andrastantos/the_d_machine/modules/sense_amp/notes.md

Temp      DC offset      Output at 20mV input    Output at 40mV input    Gain
=====     ============   ====================    ====================    ====== 
-25:       5.8V               8.60                        11.0             140/130
125:       5.88V              8.34                        10.6             123/118

There's a 13% change in gain and about 1% change in DC offset. However they counteract each other, and the overall effect is only 3-4% change of threshold value. That's acceptable.
