andrastantos/the_d_machine/docs/tape_recorders/MT8X_PCB1.pdf

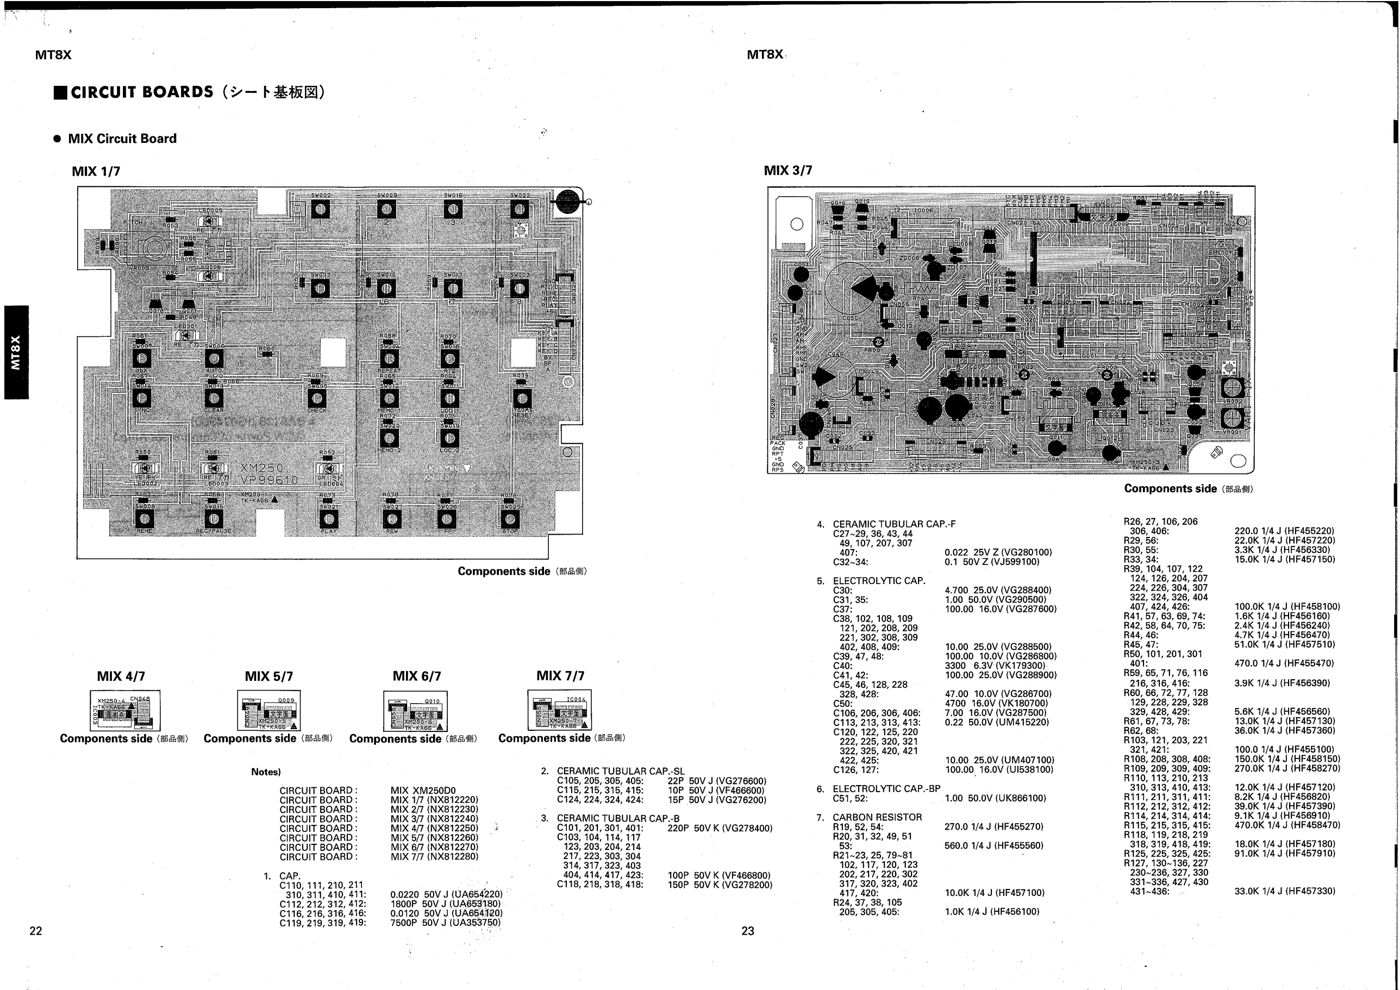
[picture p17: page 1]
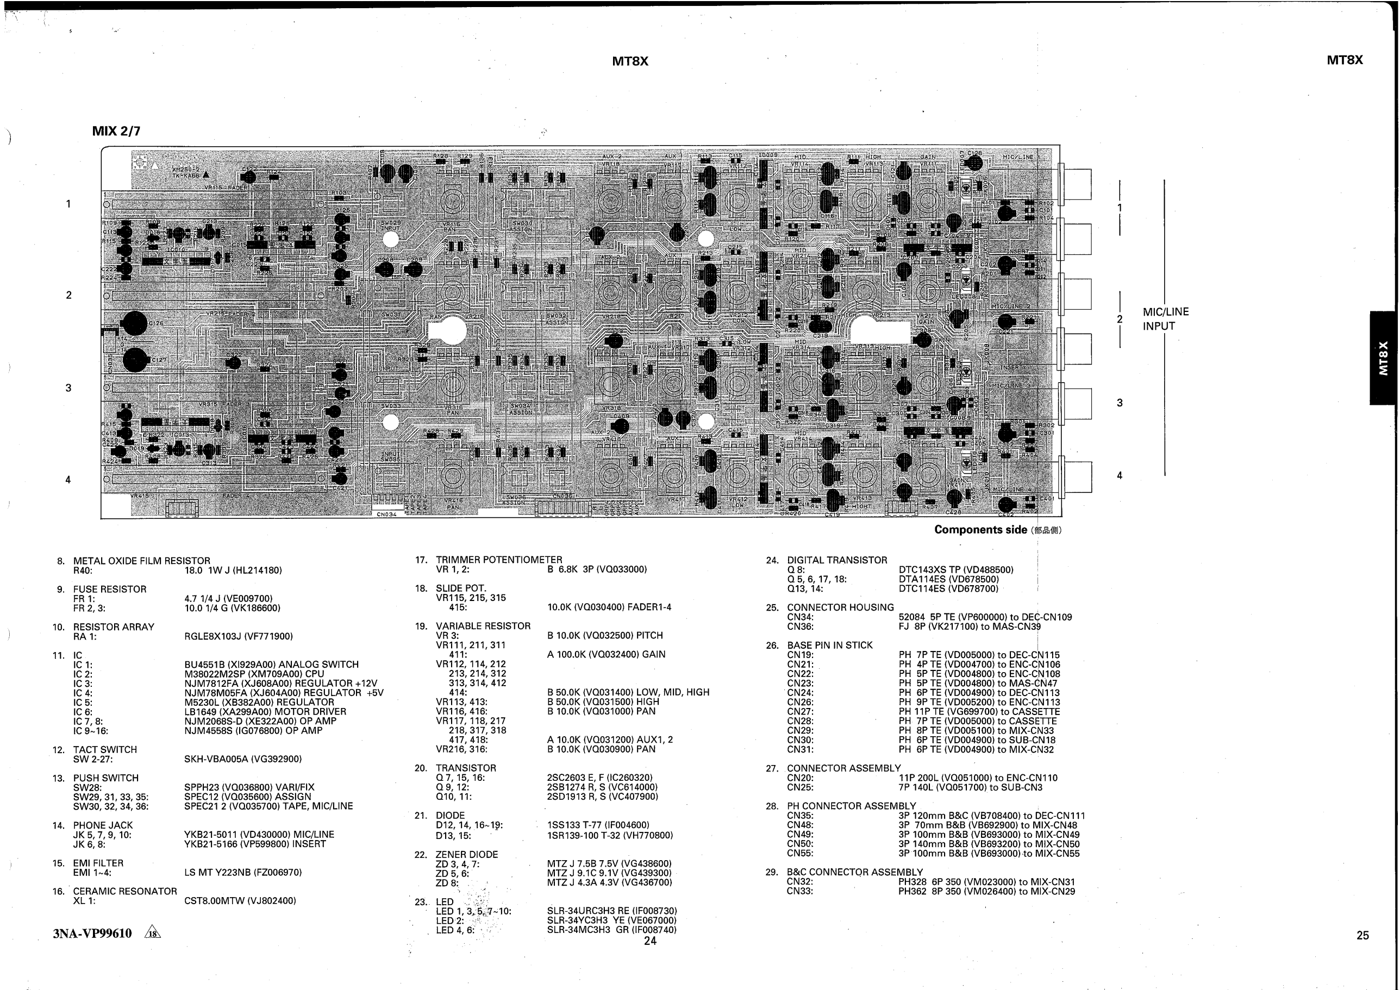
[picture p18: page 2]
