andrastantos/the_d_machine/docs/tape_recorders/MT8X_PCB2.pdf

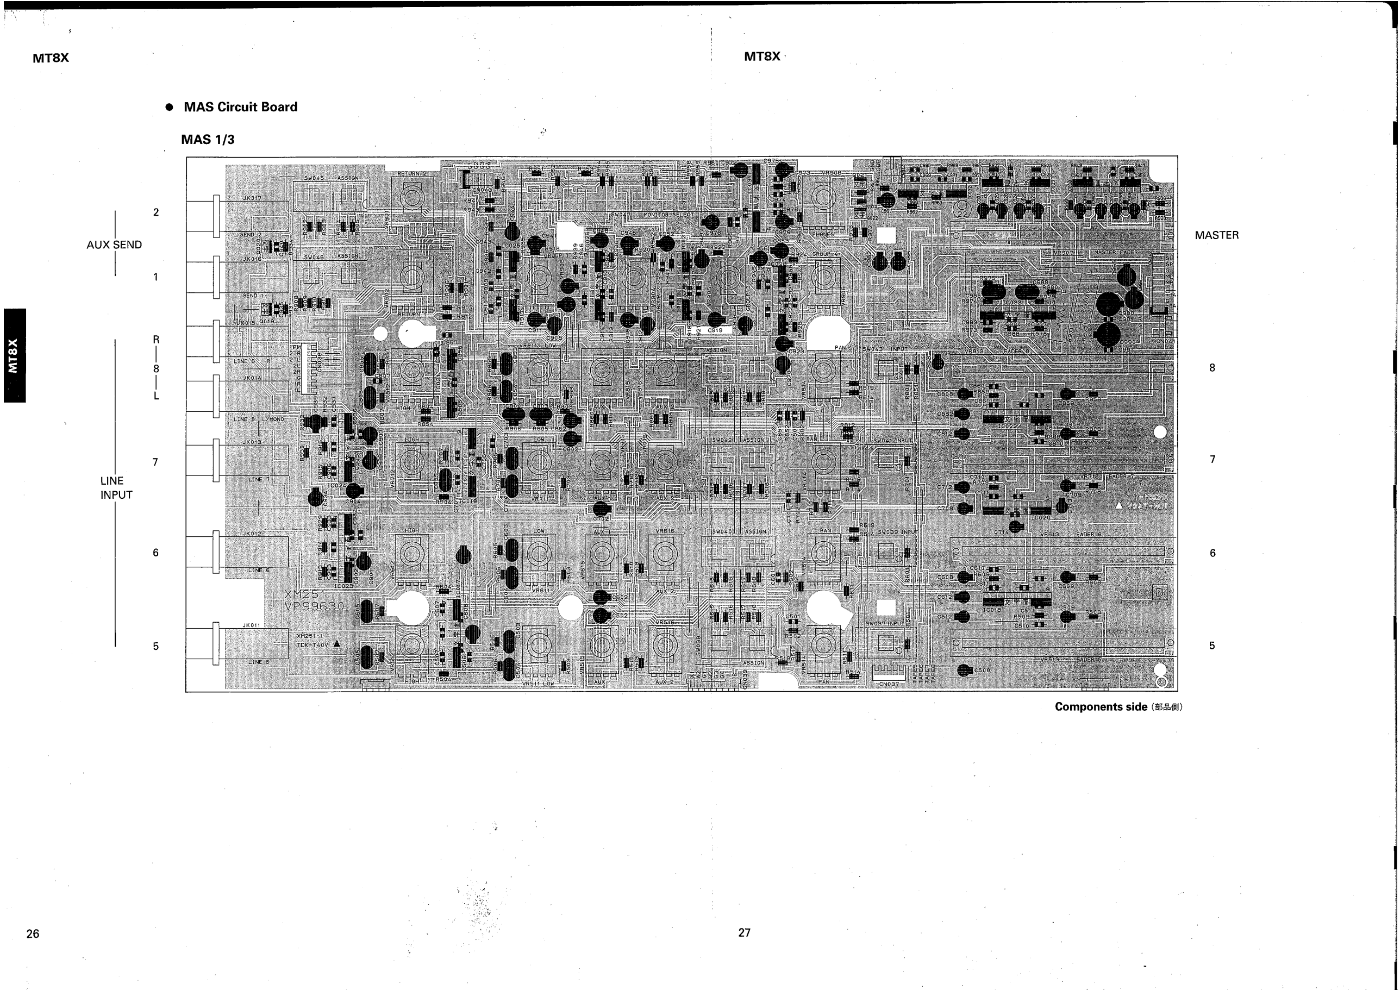
[picture p19: page 1]
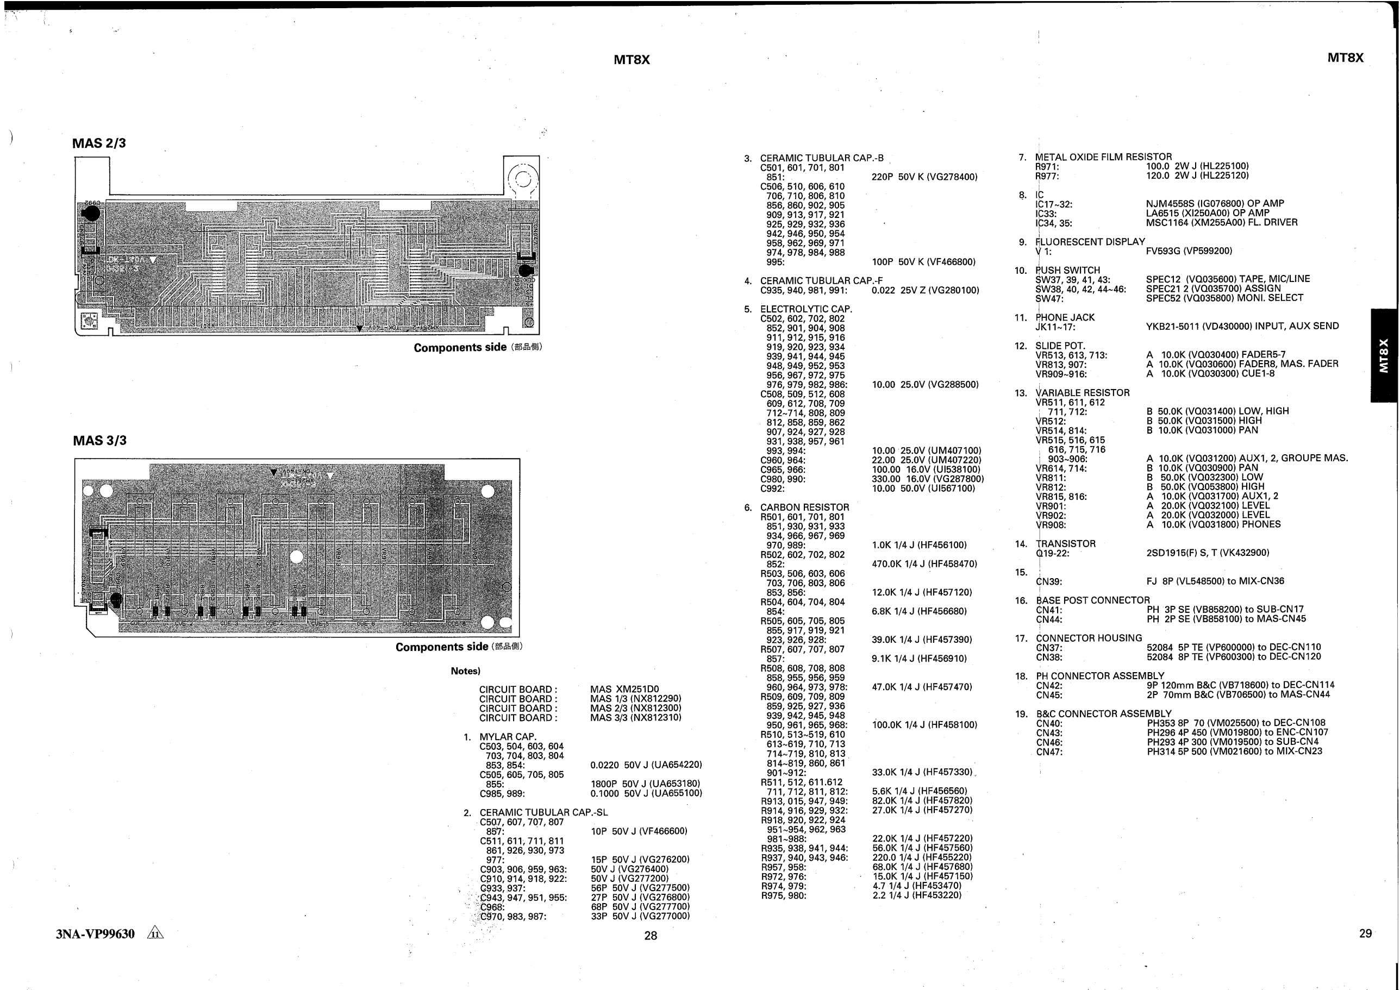
[picture p20: page 2]
