andrastantos/the_d_machine/docs/tape_recorders/MT8X_PCB3.pdf

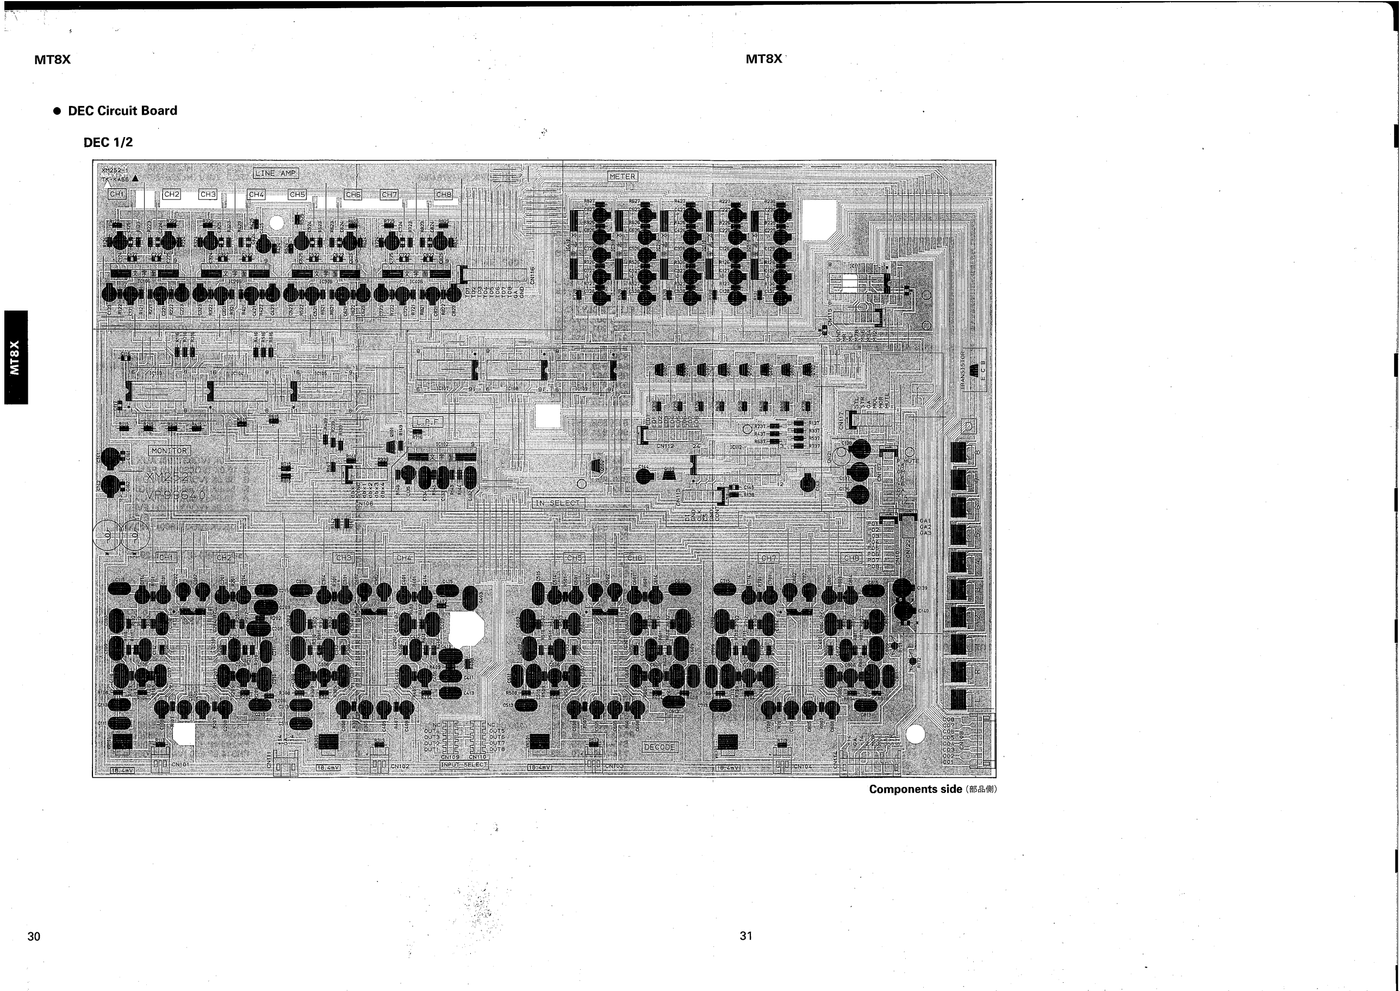
[picture p21: page 1]
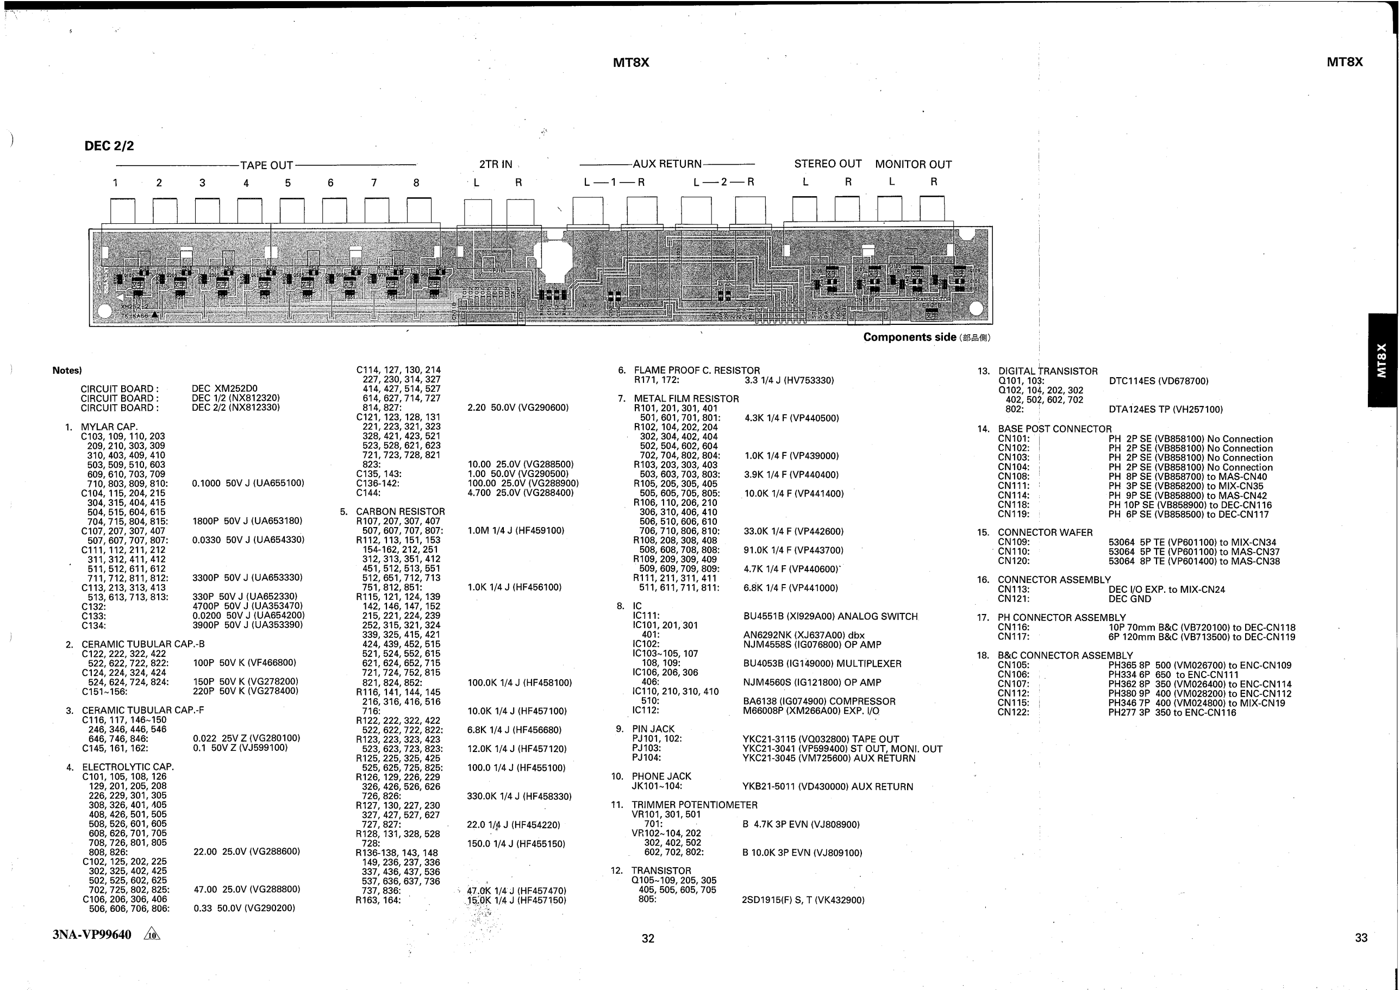
[picture p22: page 2]
