andrastantos/the_d_machine/docs/alu/delay_at_125c.png

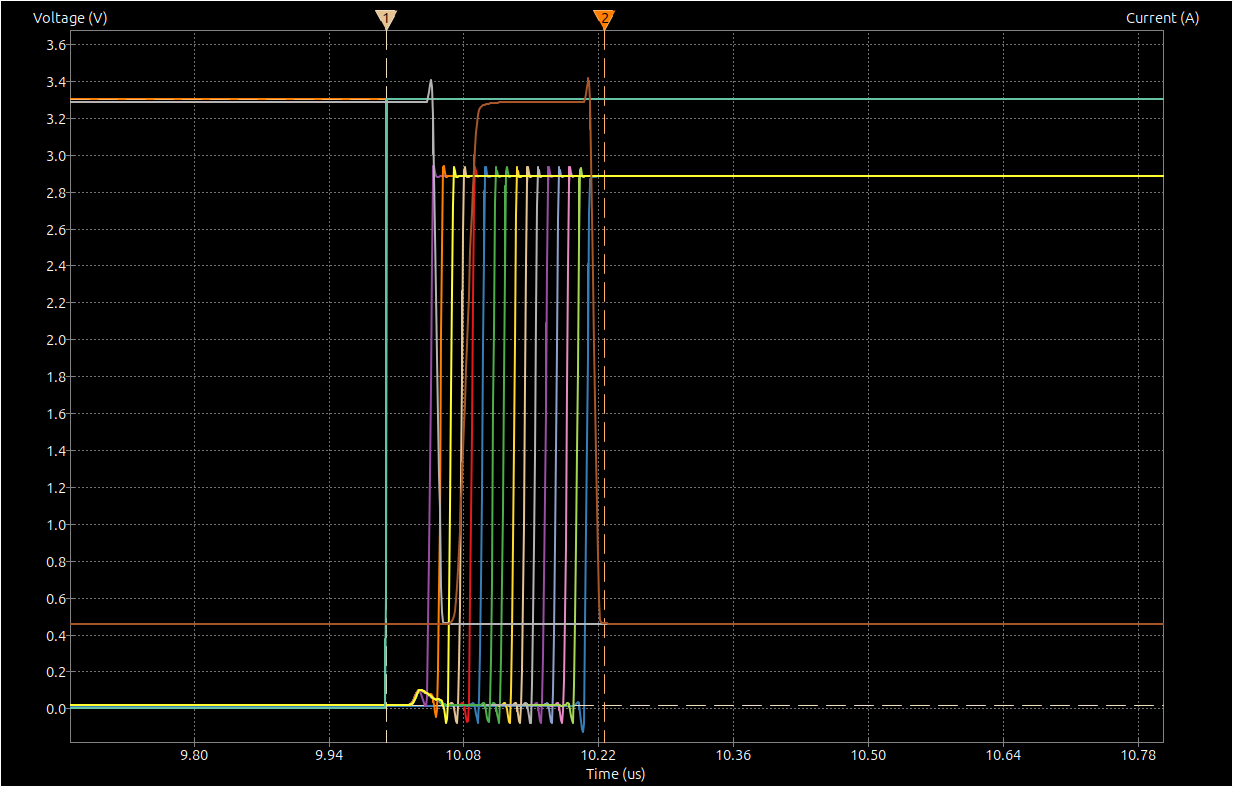
docs/alu/delay_at_125c.png
