andrastantos/the_d_machine/docs/alu/delay_at_neg25c.png

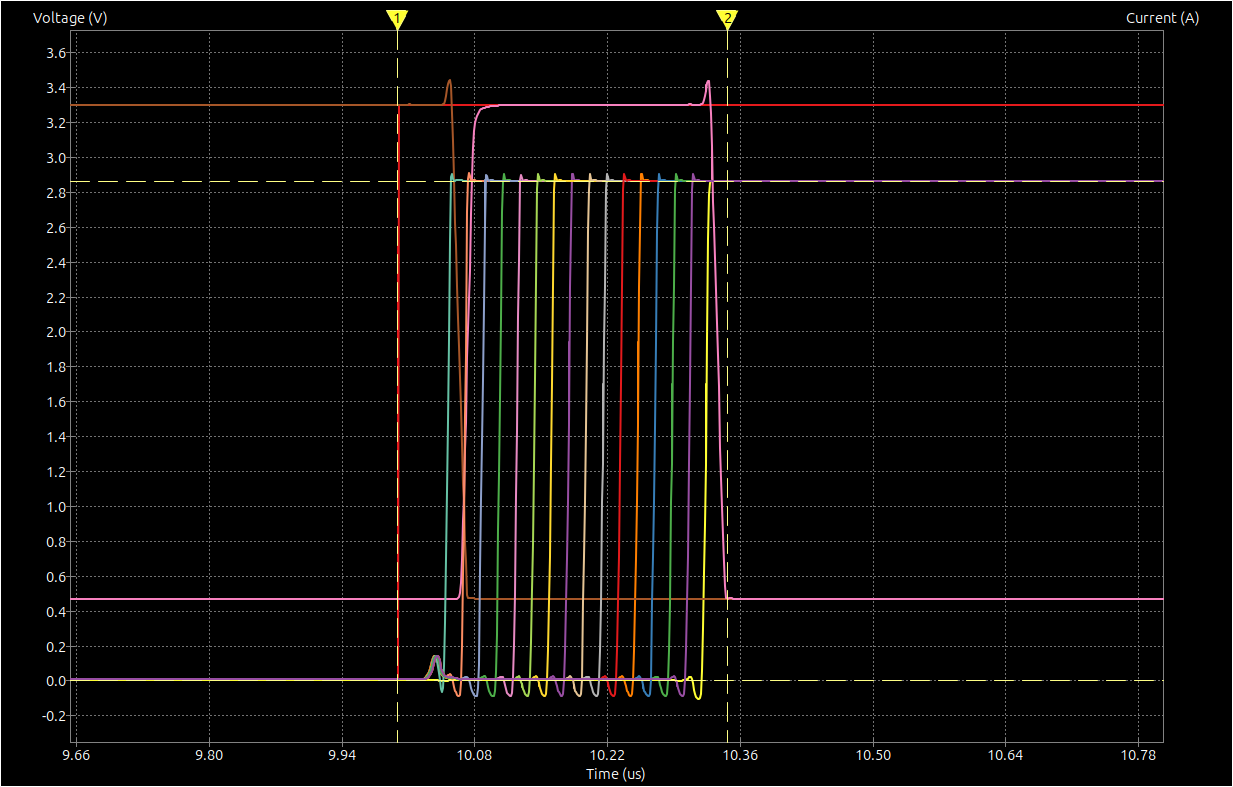
docs/alu/delay_at_neg25c.png
