andrastantos/the_d_machine/docs/tape_recorders/MT8X_sch1.tif

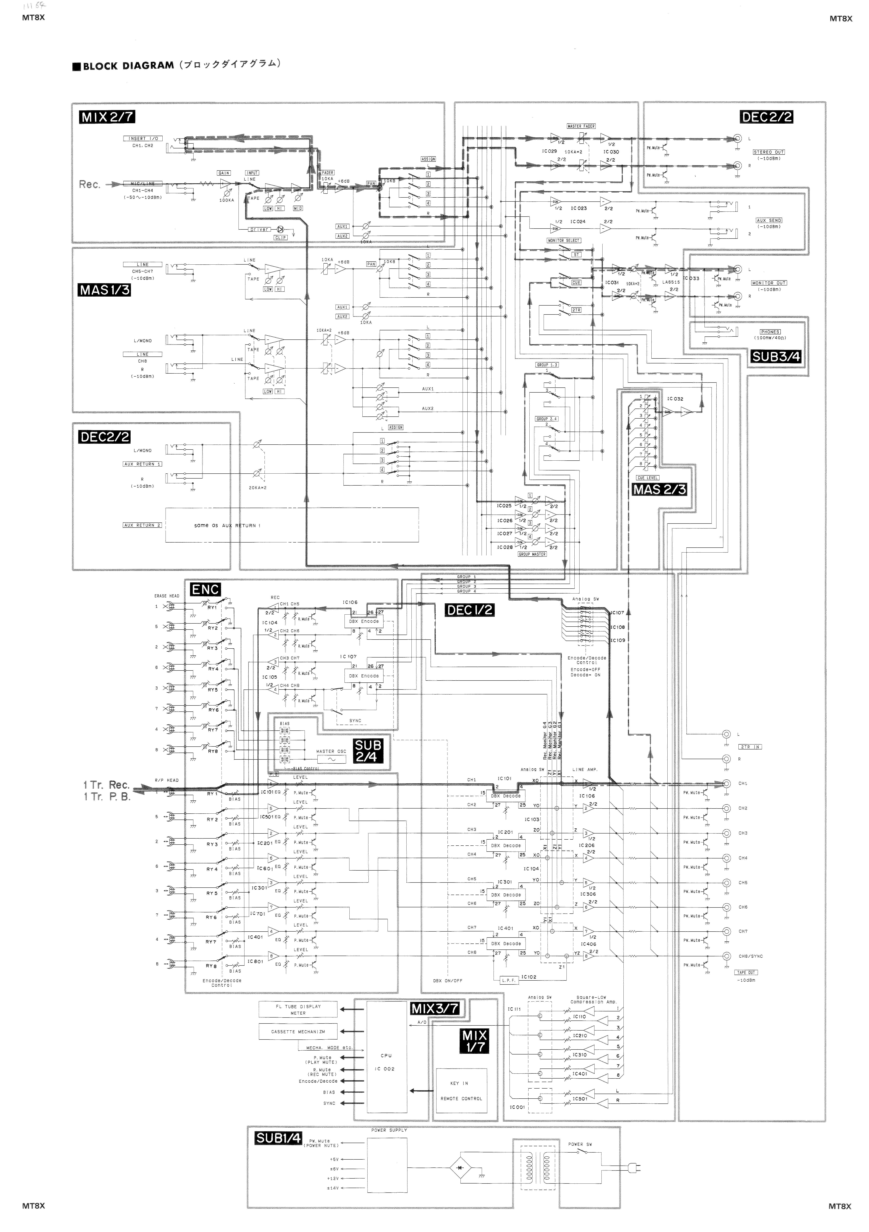
docs/tape_recorders/MT8X_sch1.tif
