andrastantos/the_d_machine/docs/tape_recorders/MT8X_sch4.tif

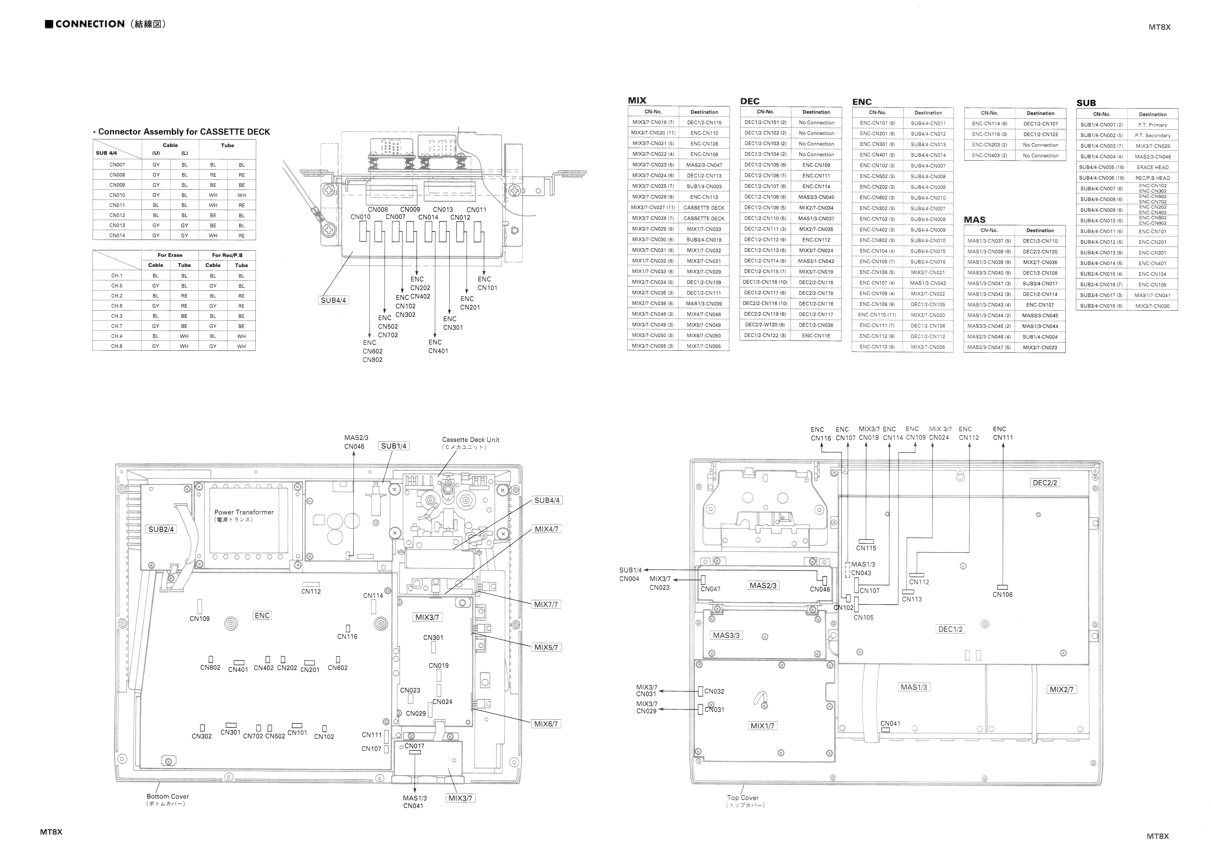
docs/tape_recorders/MT8X_sch4.tif
