andrastantos/the_d_machine/circuit_sims/power/forward_regulator_test2.asc

C1: cap; 100µ
C2: cap; 100µ
D1: diode; MBRS340
D2: diode; MBRS340
D3: diode; MBRS340
D4: diode; MBRS340
D5: diode; MBRS340
D6: diode; MBRS340
L1: ind; {l1}; Rser=1m
L2: ind; {l1*n2*n2}; Rser=1m
L3: ind; {l1*n3*n3}; Rser=1m
L4: ind; {l1*n4*n4}; Rser=1m
L5: ind; 10µ
L6: ind; 10µ
R1: res; 17.6m
R2: res; 105.6m
R3: res; 426m
R4: res; 122m
R5: res; {18/0.1}
R6: res; {18/2}
S1: sw; LDSW
S3: sw; LDSW
V1: voltage; 20
V2: voltage; PULSE(0 1 0 1n 1n 1u 2u)
Named nets: 0, out_p, out_n, sw
;K L1 L2 L3 L4 0.9988
PA3856.006NL
.model LDSW SW(Ron=1m Roff=1Meg Vt=.5 Vh=-.4)
.tran 0 10m 0 5n uic
K L1 L2 L3 L4 1
.param n1=1 n2=1.74 n3=2.12 n4=2.12 l1=128u
Maximum duty cycle is 50%, at least in theory.
Still, this setup can produce 20V output even under heavy loads from a 20V input.
Saturation current: Bpk/K1_factor. Bbk is 2700Gauss and K1_factor is 41.7
K2 L5 L6 L7 1
