andrastantos/the_d_machine/circuit_sims/power/forward_regulator_test1.asc

C1: cap; 100µ
C2: cap; 100µ
C3: cap; 100µ
C4: cap; 100µ
D1: diode; MBRS340
D2: diode; MBRS340
D3: diode; MBRS340
D4: diode; MBRS340
D5: diode; MBRS340
D6: diode; MBRS340
D7: diode; MBRS340
D8: diode; MBRS340
D9: diode; MBRS340
D10: diode; MBRS340
D11: diode; MBRS340
D12: diode; MBRS340
L1: ind; {l1}; Rser=1m
L2: ind; {l1*n2*n2}; Rser=1m
L3: ind; {l1*n3*n3}; Rser=1m
L4: ind; {l1*n4*n4}; Rser=1m
L5: ind; 10µ
L6: ind; 10µ
L7: ind; {l7}; Rser=1m
L8: ind; {l7*n8*n8}; Rser=1m
L9: ind; {l7*n9*n9}; Rser=1m
L10: ind; {l7*n10*n10}; Rser=1m
L11: ind; 10µ
L12: ind; 10µ
R1: res; 17.6m
R2: res; 105.6m
R3: res; 426m
R4: res; 122m
R5: res; {18/1.5}
R6: res; {18/1.5}
R7: res; 60m
R8: res; 90m
R9: res; 75m
R10: res; 90m
R11: res; {18/1.5}
R12: res; {18/1.5}
S1: sw; LDSW
S2: sw; LDSW
V1: voltage; 30
V2: voltage; PULSE(0 1 0 1n 1n 1u 2.75u)
V3: voltage; 30
V4: voltage; PULSE(0 1 0 1n 1n 2.5u 5u)
Named nets: 0
;K L1 L2 L3 L4 0.9988
PA3856.006NL
.model LDSW SW(Ron=1m Roff=1Meg Vt=.5 Vh=-.4)
.tran 0 10m 0 5n uic
K L1 L2 L3 L4 1
.param n1=1 n2=1.74 n3=2.12 n4=2.12 l1=128u
Maximum duty cycle is the turns ration (n1:(n1+n2)) to allow the primary
current to return to zero
;K L1 L2 L3 L4 0.9988
PA3856.007NL
.model LDSW SW(Ron=1m Roff=1Meg Vt=.5 Vh=-.4)
.tran 0 10m 0 5n uic
K2 L7 L8 L9 L10 1
.param n7=1 n8=1 n9=1.1 n10=1.1 l7=200u
Saturation current: Bpk/K1_factor. Bbk is 2700Gauss and K1_factor is 41.7 (33.3 for L7)
The 007NL transformer (just barely) can work with a 20V input voltage.
The 006NL transformer needs close to 30V input to function.
 
Since the 007NL is a unicorn as far as the distributors are concerned
(only Mouser seem to have it), I'll work with the 006NL and increase
the input voltage to 30V.
 
This decision doesn't seem to impact the netlist, just (a bunch of)
component values.
It seems that light loads actually result in really high input currents.
I don't quite understand that.
