andrastantos/the_d_machine/circuit_sims/power/step_down2.asc

C2: cap; {Cosc}
C5: cap; {Cosc}
D3: diode; BZX84C6V2L
Q6: npn; 2N3904
Q8: npn; 2N3904
Q9: pnp; 2N3906
Q10: pnp; 2N3906
Q17: pnp; 2N3906
Q18: pnp; 2N3906
Q19: npn; 2N3904
Q20: pnp; 2N3906
Q21: npn; 2N3904
Q22: npn; 2N3904
R1: res; 1m
R19: res; {1.1/3.5m}
R20: res; 1k
R21: res; 10k
R22: res; 2.5k
R23: res; 1m
R24: res; 1m
R27: res; 1m
R28: res; 4.7k
R29: res; 2.5k
R30: res; {Rosc}
R31: res; {Rosc}
R32: res; 1m
V2: voltage; 2.1
V4: voltage; 20
Named nets: 0, IN, VREF, ca, cb, ba, bb
.tran 0.5m startup
.param Rc=270
.param Rb=1m
.param Rosc=680
;.step param Rosc 3k 10k 500
.param Cosc=470p
;.step param Cosc 1n 10n 1n
;.step temp list -25 25 125
.temp 125
.dc V2 0 20 0.05
1.1V
1.1V
\\/ 5mA
2.1V
