andrastantos/the_d_machine/circuit_sims/power/step_down_trial2_2.asc

C1: cap; 100µ
C3: cap; 4.7n
C4: cap; 10µ
D1: diode; BZX84C6V2L
D2: diode; MBRS340
D3: diode; BAT54
L1: ind; 470µ
M1: pmos; Si4835DY
M5: nmos; 2N7002
M6: nmos; 2N7002
M7: nmos; 2N7002
M8: pmos; BSS84
Q1: pnp; 2N3906
Q4: npn; 2N3904
Q5: npn; 2N3904
Q6: npn; 2N3904
Q7: pnp; 2N3906
Q8: pnp; 2N3906
Q9: npn; 2N3904
Q10: npn; 2N3904
Q11: npn; 2N3904
Q12: pnp; 2N3906
Q13: pnp; 2N3906
Q14: npn; 2N3904
R2: res; 1m
R3: res; 4
R4: res; 1k
R5: res; 1k
R6: res; 1k
R7: res; {1.1/4m}
R8: res; 1k
R9: res; 10k
R10: res; 2.5k
R11: res; {1.1/15m}
R12: res; 1m
R13: res; 4.7k
R14: res; 2.5k
R15: res; 1k
R16: res; 1
R17: res; 8k
R18: res; 8k
R19: res; 10k
R20: res; 10k
R21: res; 1k
R22: res; 1k
R23: res; 10k
R24: res; 10k
R25: res; 10k
R26: res; 10k
R27: res; 1m
R28: res; 220
R29: res; 520
R_ileft1: res; 1m
R_ileft2: res; 1m
R_imaster1: res; 1m
R_imaster2: res; 1m
R_iright1: res; 1m
R_iright2: res; 1m
V2: voltage; 20
Vfb: voltage; 0.9
Named nets: triangle, 0, VREF, FB, st1, st2, out, sw
.tran 10m startup
1.1V
1.1V
\\/ 5mA
2.1V
slow-start capacitor
.dc Vfb 0 20 0.05
1.1V
\\/ 5mA
;.step temp list -25 25 125
.temp -25
