andrastantos/the_d_machine/circuit_sims/power/step_down3.asc

C1: cap; 2.2n
C2: cap; 1p
C3: cap; 33µ
C4: cap; 1µ
D1: diode; BAT54
D2: diode; BAT54
D3: diode; BZX84C6V2L
D4: diode; 1N5818
D5: diode; BAT54
L1: ind; 33µ; Rser=1m
M1: nmos; 2N7002
M2: nmos; 2N7002
M3: nmos; 2N7002
M4: pmos; BSS84
M5: nmos; 2N7002
M6: pmos; BSS84
M7: nmos; 2N7002
M8: pmos; BSS84
Q1: pnp; 2N3906
Q2: pnp; 2N3906
Q3: npn; 2N3904
Q4: pnp; 2N3906
Q5: npn; 2N3904
Q6: npn; 2N3904
Q7: pnp; 2N3906
Q8: npn; 2N3904
Q9: npn; 2N3904
Q10: pnp; 2N3906
Q11: pnp; 2N3906
Q12: pnp; 2N3906
Q13: pnp; 2N3906
Q14: pnp; 2N3906
Q19: npn; 2N3904
Q20: pnp; 2N3906
R1: res; 1
R2: res; 10k
R3: res; 10k
R4: res; 220
R5: res; 1Mega
R6: res; 1m
R7: res; 1m
R8: res; 1m
R9: res; 0.1
R10: res; 10k
R11: res; 10k
R12: res; 10k
R13: res; 25
R14: res; 20k
R15: res; 1Mega
R16: res; 1k
R17: res; 10k
R18: res; 1k
R19: res; {1.1/5m}
R20: res; 1k
R21: res; 10k
R22: res; 2.5k
R23: res; 1m
R24: res; 1m
R25: res; 10k
R28: res; 4.7k
R29: res; 2.5k
R32: res; 1m
R_ileft: res; 1m
R_imaster: res; 1m
R_iright: res; 1m
V4: voltage; 20
Named nets: 0, VREF, FB, triangle, drive, sw, st1, st2, vout, vcc
.tran 0 5m 0 startup
.param Rc=270
.param Rb=1m
;.step param Rosc 3k 10k 500
;.step param Cosc 1n 10n 1n
;.step temp list -25 25 125
.temp 125
.dc V2 0 20 0.05
1.1V
1.1V
\\/ 5mA
2.1V
;.step param Vset 2.12 2.18 0.01
.param Vset=2.2
slow-start capacitor
over-current protection;
crucial for proper startup
Q14/Q12/Q9/Q10: over-voltage protection, but doesn't work too well.
while it does prevent the output from turning on,
the pumpued inductor current still needs to reach 0, which can
drive the output voltage way too high.
M8 is an attempt at soft-start. It only delays the start, unfortunately.
