andrastantos/the_d_machine/circuit_sims/power/step_down1.asc

C1: cap; 100µ
C3: cap; {Cosc}
C4: cap; {Cosc}
D1: diode; BZX84C6V2L
D2: diode; MBRS1100
L1: ind; 470µ; Rser=1m
Q1: npn; 2N3904
Q2: pnp; 2N2907
Q3: npn; 2N3904
Q4: npn; 2N3904
Q5: npn; 2N3904
Q7: pnp
Q11: npn; 2N3904
Q12: npn; 2N3904
Q13: pnp; 2N3906
Q14: pnp; 2N3906
Q15: pnp; 2N3906
Q16: pnp; 2N3906
R1: res; 1k
R2: res; 20k
R3: res; {Rosc}
R4: res; {Rosc}
R5: res; 5k
R6: res; {Rb}
R7: res; {Rb}
R8: res; {Rc}
R9: res; {Rosc}
R10: res; 2k
R11: res; 10
R12: res; 10k
R13: res; 19k
R14: res; 1m
R15: res; 1m
R16: res; {Rosc}
R17: res; 1m
R18: res; 2.7k
V1: voltage; 20
V2: voltage; 5
V3: voltage; PULSE(1 0 1m 100n 100n 10 100)
Named nets: 0, OUT, SW, FB, IN, VREF, ca, cb, ba, bb
.tran 5m startup
.param Rc=270
.param Rb=1
.param Rosc=810
;.step param Rosc 3k 10k 500
.param Cosc=470p
;.step param Cosc 1n 10n 1n
.step temp list -25 25 125
.temp 125
