andrastantos/the_d_machine/circuit_sims/sense_amp/rom_sense_amp_with_optics2.asc

C1: cap; 1n
D1: schottky; BAT54
D2: schottky; BAT54
D3: diode; BZX84C8V2L
I1: current; PULSE(0.8m 1.2m 450n 1n 1n 989n 1980n)
I2: current; 1m
Q1: npn; 2N3904
Q2: npn; 2N3904
Q3: npn; 2N3904
Q4: npn; 2N3904
Q10: npn; 2N3904
Q11: npn; 2N3904
Q19: npn; 2N3904
Q20: npn; 2N3904
Q21: npn; 2N3904
Q26: npn; 2N3904
Q27: npn; 2N3904
Q29: npn; 2N3904
Q30: npn; 2N3904
Q31: pnp; 2N3906
Q32: pnp; 2N3906
R1: res; 1k
R4: res; 1k
R5: res; 1k
R8: res; 1k
R9: res; 0.01m
R10: res; 10k
R11: res; 1k
R12: res; 0.01m
R13: res; 10k
R20: res; 56
R22: res; 56
R24: res; 600
R25: res; 6.8k
R26: res; 6.8k
R27: res; 300
R28: res; 2k
R29: res; 1k
R30: res; 1k
R34: res; 1k
R35: res; 1k
R36: res; 1.7k
R37: res; 300
R38: res; 300
R39: res; 100
R42: res; 100
U3: 4N25
U4: 4N25
V_EN: voltage; PULSE(-4 12 0 1n 1n 299n 500n)
VN: voltage; 12
VP1: voltage; 3.3
VP: voltage; 12
Named nets: 0, V+, V-, IN+, IN-, VCC, EN, SENSE_OUT2-, S_IN-, V_REF, SENSE_OUT2+, O-, O+, E_IN+, E_IN-, S_IN+
.tran 20u
.dc VINA -100m 100m 0.1m
;.step temp -25 125 25
PULSE(-4 12 0 1n 1n 299n 500n)
PWL file=ampl_train.pwl
VREF control
;.step param in_ampl 1000u 10000u 500u
;.temp 125
This is not a good design: it's common-base input stage does nothing for
noise coupling, but of course makes the system more complicated.
