andrastantos/the_d_machine/circuit_sims/sense_amp/rom_sense_amp_with_optics.asc

C1: cap; 100p
C2: cap; 100p
C3: cap; 100p
C4: cap; 10p
C5: cap; 10p
C6: cap; 100p
C7: cap; 10p
D1: schottky; BAT54
D2: schottky; BAT54
D3: diode; BZX84C8V2L
D4: diode; BZX84C8V2L
D5: diode; BZX84C8V2L
D6: diode; BZX84C8V2L
I1: current; PULSE(0.8m 1.2m 450n 1n 1n 249n 500n)
I2: current; 1m
I3: current; 10m
Q1: npn; 2N3904
Q2: npn; 2N3904
Q3: pnp; 2N3906
Q4: npn; 2N3904
Q5: pnp; 2N3906
Q6: npn; 2N3904
Q7: npn; 2N3904
Q8: pnp; 2N3906
Q9: pnp; 2N3906
Q10: npn; 2N3904
Q11: npn; 2N3904
Q12: pnp; 2N3906
Q13: pnp; 2N3906
Q14: pnp; 2N3906
Q15: pnp; 2N3906
Q16: npn; 2N3904
Q19: npn; 2N3904
Q20: npn; 2N3904
Q21: npn; 2N3904
Q26: npn; 2N3904
Q27: npn; 2N3904
Q29: npn; 2N3904
Q30: npn; 2N3904
Q31: pnp; 2N3906
Q32: pnp; 2N3906
R1: res; 1k
R2: res; 1k
R3: res; 1k
R4: res; 1k
R5: res; 1k
R6: res; 1k
R7: res; 1k
R8: res; 1k
R9: res; 1k
R10: res; 100
R11: res; 1k
R12: res; 0.01m
R13: res; 0.01m
R14: res; 500
R15: res; 1k
R16: res; 500
R17: res; 1k
R18: res; 1k
R19: res; 1k
R20: res; 56
R21: res; 0.01m
R22: res; 56
R23: res; 1k
R24: res; 600
R25: res; 6.8k
R26: res; 6.8k
R27: res; 300
R28: res; 2k
R29: res; 1k
R30: res; 1k
R31: res; 1k
R32: res; 1k
R34: res; 1k
R35: res; 1k
R36: res; 1.7k
R37: res; 300
R38: res; 300
R39: res; 100
R42: res; 100
U1: 4N25
U2: 4N25
U3: 4N25
U4: 4N25
U5: 4N25
V1: voltage; 8.2
V_EN: voltage; PULSE(-4 12 0 1n 1n 299n 500n)
VN: voltage; 12
VP1: voltage; 3.3
VP: voltage; 12
Named nets: 0, V+, V-, IN+, IN-, VCC, EN, SENSE_OUT2-, S_IN+, S_IN-, V_REF, SENSE_OUT2+, O-, O+, E_IN+, E_IN-, oooo2, a, b, bias, oooo1, a1, b1, ooo3, oooo3, a2, b2, ooo4
.tran 20u
.dc VINA -100m 100m 0.1m
.step temp -25 125 25
PULSE(-4 12 0 1n 1n 299n 500n)
PWL file=ampl_train.pwl
VREF control
;.step param in_ampl 1000u 10000u 500u
;.temp 125
Common-base current buffer.
Unfortunately, it needs a relatively high input bias current (50uA or so) to work.
In fact, to get low input impedance (~200ohms), one needs 10mA bias current, but
that crushes output current amplitude.
I think this is the common-base input stage that I want
