andrastantos/the_d_machine/circuit_sims/bjt/optical_components.asc

C1: cap; 100p
C2: cap; 100p
C3: cap; 100p
C4: cap; 100p
C5: cap; 100p
C6: cap; 100p
C7: cap; 100p
C8: cap; 100p
D1: diode; L1C1-AMB1000000000
D2: schottky; BAT54
D3: schottky; BAT54
D4: schottky; BAT54
D5: schottky; BAT54
D6: schottky; BAT54
D7: diode; 1N914
D8: diode; L1C1-AMB1000000000
D9: schottky; BAT54
D10: schottky; BAT54
D11: schottky; BAT54
D12: schottky; BAT54
D13: schottky; BAT54
D14: schottky; BAT54
D15: schottky; BAT54
D16: diode; L1C1-AMB1000000000
D17: diode; L1C1-AMB1000000000
D18: diode; L1C1-AMB1000000000
D19: schottky; BAT54
D20: schottky; BAT54
D21: schottky; BAT54
D22: schottky; BAT54
D23: schottky; BAT54
D24: schottky; BAT54
D25: schottky; BAT54
D26: diode; L1C1-AMB1000000000
D27: diode; L1C1-AMB1000000000
D28: diode; L1C1-AMB1000000000
D29: diode; L1C1-AMB1000000000
D30: diode; L1C1-AMB1000000000
I1: current; PULSE(0 10mA 0 1n 1n 99n 200n)
I2: current; PULSE(0 0.06mA 0 1n 1n 99n 200n)
Q1: npn; 2N3904
Q2: npn; 2N3904
Q3: npn; 2N3904
Q4: npn; 2N3904
Q5: npn; 2N3904
Q6: npn; 2N3904
Q7: npn; 2N3904
Q8: npn; 2N3904
Q9: npn; 2N3904
Q10: npn; 2N3904
Q11: pnp; 2N2907
Q12: npn; 2N3904
Q13: npn; 2N3904
Q14: npn; 2N3904
Q15: npn; 2N3904
Q16: npn; 2N3904
Q17: npn; 2N3904
Q18: pnp; 2N3906
Q19: pnp; 2N3906
Q20: npn; 2N3904
Q21: npn; 2N3904
Q22: pnp; 2N3906
Q23: pnp; 2N3906
Q24: npn; 2N3904
Q25: npn; 2N3904
Q26: pnp; 2N3906
Q27: pnp; 2N3906
Q28: npn; 2N3904
Q29: npn; 2N3904
Q30: pnp; 2N3906
Q31: pnp; 2N3906
Q32: npn; 2N3904
Q33: npn; 2N3904
Q34: pnp; 2N3906
Q35: pnp; 2N3906
Q36: npn; 2N3904
Q37: npn; 2N3904
Q38: pnp; 2N3906
Q39: pnp; 2N3906
R1: res; 1k
R2: res; 100
R3: res; 220
R4: res; 220
R5: res; 220
R6: res; 220
R7: res; 220
R8: res; 220
R9: res; 100
R10: res; 1k
R11: res; 220
R12: res; 220
R13: res; 220
R14: res; 220
R15: res; 100
R16: res; 1k
R17: res; 100
R18: res; 15
R19: res; 10k
R20: res; 220
R21: res; 220
R22: res; 100
R23: res; 220
R24: res; 220
R25: res; 100
R26: res; 220
R27: res; 220
R28: res; 15
R29: res; 220
R30: res; 220
R31: res; 15
R32: res; 220
R33: res; 220
R34: res; 15
R35: res; 220
R36: res; 220
R37: res; 1k
R38: res; 1k
R39: res; 1k
R40: res; 1k
R41: res; 75
R42: res; 220
R43: res; 220
R44: res; 75
R45: res; 1m
R46: res; 75
R47: res; 10
R48: res; 10
R49: res; 10
R50: res; 10
R51: res; 220
R52: res; 220
R53: res; 75
R54: res; 1m
R55: res; 10
R56: res; 10
R57: res; 10
R58: res; 10
R59: res; 75
R60: res; 220
R61: res; 220
R62: res; 75
R63: res; 1m
R64: res; 10
R65: res; 10
R66: res; 10
R67: res; 10
R68: res; 75
R69: res; 220
R70: res; 220
R71: res; 75
R72: res; 1m
R73: res; 10
R74: res; 10
R75: res; 10
R76: res; 10
R77: res; 1
R78: res; 1
R79: res; 1
R80: res; 1
R81: res; 66
R82: res; 100
R83: res; 100
U1: 4N25
U2: 4N25
U3: 4N25
U4: 4N25
V1: voltage; PULSE(0 {VCC} 0 {rise} {rise} {1/freq/2-rise} {1/freq})
V2: voltage; 15
V3: voltage; 5
V_BIT2: voltage; PULSE(0 {VCC} 0 {rise} {rise} {1/freq/2-rise} {1/freq}); AC 5
V_BIT3: voltage; PULSE(0 {VCC} 0 {rise} {rise} {2*1/freq/2-rise} {2*1/freq})
V_BIT4: voltage; PULSE(0 {VCC} 0 {rise} {rise} {4*1/freq/2-rise} {4*1/freq})
V_BIT5: voltage; PULSE(0 {VCC} 0 {rise} {rise} {8*1/freq/2-rise} {8*1/freq})
V_BIT6: voltage; PULSE(0 {VCC} 0 {rise} {rise} {16*1/freq/2-rise} {16*1/freq})
VCC1: voltage; {VCC}
Named nets: 0, VCC, BIT0, OUT, BIT1, BIT2, BIT3, BIT4, _bit0, _bit1, _BIT0, _BIT1, bit0, bit1
.tran {16*reps/freq}
.ac oct 100 1k 100mega
.dc V_BIT0 0 {VCC} 0.01
.param VCC=3.3
.param freq=1Mega
.param rise=1n
.param reps=1
.step param temp list -25 25 125
