andrastantos/the_d_machine/circuit_sims/bjt/current_h_bridge_test_bed.asc

C1: cap; 57p
C2: cap; 2.7n
C3: cap; 1n
C4: cap; 2.7n
C5: cap; 2.7n
C6: cap; 100p
C7: cap; 100p
C8: cap; 100p
C9: cap; 100p
C10: cap; 100p
C11: cap; 100p
D1: schottky; BAT54SHY
D2: zener; BZX84C6V2L
D3: schottky; BAT54SHY
D4: schottky; BAT54SHY
D5: diode; TDZV20
D6: schottky; BAT54SHY
D7: diode; 1N914
D8: diode; 1N914
D9: diode; 1N914
D10: diode; 1N914
D11: diode; BZX84C27VLY
D12: diode; BZX84C27VLY
D13: diode; 1N914
D14: schottky; BAT54
D15: schottky; BAT54
D16: schottky; BAT54
D17: schottky; BAT54
D18: schottky; BAT54
D19: diode; 1N914
D20: diode; 1N914
D21: schottky; BAT54
D22: diode; 1N914
D23: diode; 1N914
D24: schottky; BAT54
D25: schottky; BAT54
D26: schottky; BAT54
D27: schottky; BAT54
D28: schottky; BAT54
D29: schottky; BAT54
D30: schottky; BAT54
D31: schottky; BAT54
D32: schottky; BAT54
D33: schottky; BAT54
D34: diode; 1N914
D35: diode; 1N914
D36: diode; 1N914
D37: diode; 1N914
D38: diode; BZX84C27VLY
D39: diode; BZX84C27VLY
D40: schottky; BAT54
D41: schottky; BAT54
D43: schottky; BAT54
D44: schottky; BAT54
I5: current; 0.37
Q1: pnp; 2DB1182Q
Q2: pnp; 2DB1182Q
Q3: npn; 2N3904
Q4: pnp; 2DB1182Q
Q5: npn; 2N3904
Q6: npn; 2N3904
Q7: pnp; 2N3906
Q8: pnp; 2N3906
Q9: pnp; 2N3906
Q10: pnp; 2N3906
Q11: pnp; 2DB1182Q
Q12: pnp; 2N3906
Q13: npn; 2N3904
Q14: pnp; 2N3906
Q15: pnp; 2DB1182Q
Q16: pnp; 2DB1182Q
Q17: pnp; 2N3906
Q18: pnp; 2DB1182Q
Q19: pnp; 2N3906
Q20: pnp; 2DB1182Q
Q21: pnp; 2DB1182Q
Q22: pnp; 2DB1182Q
Q23: pnp; 2DB1182Q
Q24: npn; 2N3904
Q25: pnp; 2DB1182Q
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
.param R_TRIM=3.95k
.param V_HIGH 20
;.param temp 25
.model LDSW SW(Ron=1m Roff=1Meg Vt=.5 Vh=-.4)
.tran 10u
.param R_ISENSE_XY=0.34
.tran {TC*10} uic
.param TON=200n
.param TC=500n
.dc V_RD 0 3.3 0.01
PULSE(3.3 0 {TDELAY/4} 1n 1n {TON} {TC})
.lib ../../spice_models/ssm6l40tu_n.lib
.lib ../../spice_models/ssm6l40tu_p.lib
See https://fscdn.rohm.com/en/products/databook/applinote/common/how_to_use_ltspice_models_an-e.pdf
on how to use .subck models in FETs and other primitives.
See https://fscdn.rohm.com/en/products/databook/applinote/common/how_to_use_ltspice_models_an-e.pdf
on how to use .subck models in FETs and other primitives.
.param TDELAY = {TC-TON}
.lib ../../spice_models/2db1182q.bjt
PULSE(3.3 0 {TC/2+TDELAY/4} 1n 1n {TON} {TC} 1000)
The low-side FET needs shorter on-time than the top-side to avoid swtich
currents flowing through the load. Turn-on needs to be delayed by about 50ns,
turn-off brought in by about the same amount.
.lib ../../spice_models/pbss4580pa.bjt
PULSE(3.3 0 {TDELAY/4} 1n 1n {TON} {TC})
PULSE(0 3.3 {TC/2+TDELAY/4} 1n 1n {TON} {TC} 1000)
