andrastantos/the_d_machine/circuit_sims/bjt/current_switch_test_bed.asc

D1: diode; TDZV20
D2: diode; TDZV20
D3: diode; TDZV20
D4: diode; TDZV20
D5: diode; TDZV20
D6: diode; TDZV20
D7: diode; BAT54
D8: diode; TDZV20
I1: current; 0.37
I2: current; 0.3
I3: current; 0.3
I4: current; 0.3
I5: current; 0.37
I6: current; 0.37
I7: current; 0.37
M1: pmos; RRR030P03
M2: pmos; RRR030P03
M3: pmos; BSS84
M4: nmos; 2N7002
M5: pmos; RRR030P03
Q1: pnp; 2DB1182Q
Q2: pnp; 2DB1182Q
Q3: npn; 2N3904
Q4: pnp; 2DB1182Q
Q5: npn; 2N3904
Q6: npn; 2N3904
Q7: pnp; 2db1182q
Q8: pnp; 2DB1182Q
Q9: npn; 2N3904
Q10: npn; 2N3904
Q11: pnp; 2DB1182Q
Q12: npn; 2N3904
R1: res; 1
R2: res; 1
R3: res; 1
R4: res; 1
R5: res; 50
R6: res; 0.1
R7: res; 0.1
R8: res; 0.1
R9: res; 1
R10: res; 10
R11: res; 10
R12: res; 1k
R13: res; 1k
R14: res; 1k
R15: res; 1k
R16: res; 1k
R17: res; 1k
R_LOAD1: res; 15
R_LOAD2: res; 15
R_LOAD3: res; 15
R_LOAD4: res; 15
R_LOAD5: res; 15
R_LOAD6: res; 15
R_LOAD7: res; 15
V1: voltage; PULSE(20 0 50n 1n 1n 198n 500n)
V2: voltage; PULSE(20 0 0n 1n 1n 198n 400n)
V3: voltage; PULSE(20 0 25n 1n 1n 148n 400n)
V4: voltage; PULSE(10 0 50n 1n 1n 198n 400n)
V5: voltage; PULSE(20 10 50n 1n 1n 198n 400n)
V6: voltage; PULSE(20 2 50n 1n 1n 198n 500n)
V7: voltage; 20
V8: voltage; PULSE(20 0 50n 1n 1n 198n 500n)
V9: voltage; 20
V10: voltage; PULSE(20 0 50n 1n 1n 198n 500n)
Named nets: 0, drv_h, drv_l
.tran 1600n uic
.lib ../../spice_models/tip42c.bjt
.lib ../../spice_models/tip41c.bjt
.lib ../../spice_models/ssm6l40tu_n.lib
.lib ../../spice_models/ssm6l40tu_p.lib
.lib ../../spice_models/2db1182q.bjt
