andrastantos/the_d_machine/circuit_sims/bjt/current_switch_test_bed_2.asc

C1: cap; 57p
C2: cap; 4.7n
C3: cap; 1n
C4: cap; 2.7n
C5: cap; 1n
D1: schottky; BAT54SHY
D2: zener; BZX84C6V2L
D3: schottky; BAT54SHY
D4: schottky; BAT54SHY
D5: diode; TDZV20
D6: schottky; BAT54SHY
D7: diode; 1N914
D8: diode; 1N914
D9: diode; 1N914
D10: diode; 1N914
D11: diode; BZX84C27VLY
D12: diode; BZX84C27VLY
D13: diode; 1N914
D16: diode; 1N914
D17: diode; 1N914
D18: diode; BZX84C27VLY
D19: diode; 1N914
D20: diode; 1N914
D22: diode; 1N914
D23: diode; 1N914
I5: current; 0.37
M1: pmos; RRR030P03
M2: pmos; RRR030P03
M3: nmos; RTR025N03
M4: nmos; RTR025N03
M6: pmos; RRR030P03
Q1: pnp; 2DB1182Q
Q2: pnp; 2DB1182Q
Q3: npn; 2N3904
Q4: pnp; 2DB1182Q
Q5: npn; 2N3904
Q6: npn; 2N3904
Q7: pnp; 2N3906
Q8: pnp; 2N3906
Q9: pnp; 2N3906
Q10: pnp; 2N3906
Q11: pnp; 2DB1182Q
Q12: pnp; 2N3906
Q13: npn; 2N3904
Q14: pnp; 2N3906
Q15: pnp; 2DB1182Q
Q16: pnp; 2DB1182Q
Q17: pnp; 2N3906
Q18: pnp; 2DB1182Q
Q19: pnp; 2N3906
Q20: npn; 2N3904
Q21: npn; 2N3904
Q22: pnp; 2N3906
Q23: npn; 2N3904
Q24: pnp; 2N3906
Q25: pnp; 2DB1182Q
Q26: npn; 2N3904
Q27: npn; 2N3904
Q28: pnp; 2DB1182Q
Q29: npn; 2N3904
R1: res; {R_TRIM}
R2: res; {R_ISENSE_INH}
R3: res; 145
R4: res; 145
R5: res; 4.7k
R6: res; {R_ISENSE_INH}
R7: res; 1k
R8: res; 200
R9: res; {R_ISENSE_XY}
R10: res; {R_ISENSE_XY}
R11: res; 0.1m
R12: res; 1k
R13: res; 1k
R14: res; 1k
R15: res; 0.1m
R16: res; {Rg}
R17: res; {Rg}
R18: res; {Rg}
R19: res; {Rg}
R20: res; 15
R21: res; 4.7
R22: res; 10
R23: res; 10
R24: res; 10
R25: res; 12
R26: res; 520
R27: res; 1k
R28: res; 1k
R29: res; {Rg}
R30: res; 520
R31: res; 1k
R32: res; 0.01
R33: res; 1k
R34: res; 1k
R35: res; 1k
R_LOAD1: res; {R_X}
R_LOAD2: res; {R_Y}
R_LOAD4: res; {R_INH}
R_LOAD5: res; 15
R_LOAD6: res; 15
RT1: res; {300*exp(beta*(1/(TEMP+273.15)-1/(25+273.15)))}
S1: sw; LDSW
V1: voltage; 2
V2: voltage; PULSE(1 0 350n 1n 1n 150n 500n 10)
V3: voltage; {V_HIGH}
V4: voltage; {V_HIGH}
V5: voltage; 20
V7: voltage; 20
V8: voltage; PULSE(0 20 00n 1n 1n 198n 500n)
V_EN1: voltage; 3.3
V_INH1: voltage; PULSE(0 20 {TC/2+50n} 1n 1n {TON} {TC} 1000)
V_LOGIC1: voltage; 3.3
V_RD1: voltage; PULSE(3.3 0 {TDELAY/4} 1n 1n {TON} {TC*2})
V_WR1: voltage; PULSE(3.3 0 {TC+TDELAY/4} 1n 1n {TON} {TC*2} 1000)
Named nets: 0, VT, DB, V_HIGH, TL, LEFT, RIGHT, _RD, EN, V_LOGIC, Gtl, CS0, Gbr, Dbr, Gbl, Gtr, TR, BR, INH, V_HIGH2, BL, _WR, V_TOP_DRV, V_TOP_DRV2, INH_DRV3, V_INH_DRV, V_1, V_2, v_3, v_4
.lib ../../spice_models/tip42c.bjt
.lib ../../spice_models/tip41c.bjt
.step temp 0 50 25
.op
;.step param V_HIGH 18 25 1
.param beta=3468
;.step param beta 3100 4000 100
{300*exp(beta*(1/(TEMP+273.15)-1/(25+273.15)))}
.param L_FERRITE=1p
.param R_X=25 R_Y=19 R_INH=15
.param R_ISENSE_INH=0.365
;.step param R_TRIM 4.1k 4.2k 20
.param R_TRIM=3.95k
.param V_HIGH 20
;.param temp 25
.model LDSW SW(Ron=1m Roff=1Meg Vt=.5 Vh=-.4)
.tran 10u
.param R_ISENSE_XY=0.34
.tran {TC*10} uic
.param TON=200n
.param TC=500n
.param Rg=1m
;.step param Rg 10 100 10
.dc V_RD 0 3.3 0.01
.param Rout=33
PULSE(3.3 0 {TDELAY/4} 1n 1n {TON} {TC})
.lib ../../spice_models/ssm6l40tu_n.lib
.lib ../../spice_models/ssm6l40tu_p.lib
See https://fscdn.rohm.com/en/products/databook/applinote/common/how_to_use_ltspice_models_an-e.pdf
on how to use .subck models in FETs and other primitives.
See https://fscdn.rohm.com/en/products/databook/applinote/common/how_to_use_ltspice_models_an-e.pdf
on how to use .subck models in FETs and other primitives.
.param TDELAY = {TC-TON}
.lib ../../spice_models/2db1182q.bjt
PULSE(3.3 0 {TC/2+TDELAY/4} 1n 1n {TON} {TC} 1000)
The low-side FET needs shorter on-time than the top-side to avoid swtich
currents flowing through the load. Turn-on needs to be delayed by about 50ns,
turn-off brought in by about the same amount.
