andrastantos/the_d_machine/circuit_sims/bjt/current_step_response_DEC.asc

L1: ind; 2µ
L2: ind; 1nH
R1: res; 19
R2: res; 1k
R3: res; 30
S1: sw; LDSW
V1: voltage; 20
V2: voltage; 20
V3: voltage; PULSE(0 1 1u 1n 1n 300n 1u 10)
Named nets: 0, VCC, VL
.model LDSW SW(Ron=1m Roff=1Meg Vt=.5 Vh=-.4)
.tran 2u
