andrastantos/the_d_machine/circuit_sims/bm2ecl_gates.asc

I1: current; {Ig}
I2: current; {Ig}
I3: current; {Ig}
Q1: pnp; 2N3906
Q2: pnp; 2N3906
Q3: pnp; 2N3906
Q4: pnp; 2N3906
Q5: pnp; 2N3906
Q6: pnp; 2N3906
R1: res; {Rc}
R2: res; {Rc}
R3: res; {Rc}
R4: res; {Rc}
R5: res; {Rc}
R6: res; {Rc}
V_IN: voltage; PULSE(0 0.45 0 1n 1n 48n 100n)
V_REF: voltage; {V_REF}
V_VCC: voltage; 3.3
Named nets: 0, VCC, IN, OUT, _OUT, V_REF, OUT2, _OUT2, OUT3, _OUT3
.dc V_IN 0 3.3 0.01
.tran 1u
;.step param V_REF 0 3.3 0.1
.param V_REF 0.225
.step temp -25 125 25
.param Rc 220
.param Ig 2m
