andrastantos/the_d_machine/circuit_sims/bmecl_gates.asc

Q1: npn; 2N3904
Q2: npn; 2N3904
Q3: npn; 2N3904
Q4: npn; 2N3904
Q5: npn; 2N3904
Q6: npn; 2N3904
R1: res; 1.2k
R2: res; 220
R3: res; 220
R4: res; 1.2k
R5: res; 220
R6: res; 220
R7: res; 1.2k
R8: res; 220
R9: res; 220
V_IN: voltage; PULSE(2.8 3.3 0 1n 1n 48n 100n)
V_REF: voltage; 3.05
V_VCC: voltage; 3.3
Named nets: 0, VCC, IN, OUT, _OUT, V_REF, OUT2, _OUT2, OUT3, _OUT3
.dc V_IN 0 3.3 0.1
.tran 1u
.step temp -25 125 25
