andrastantos/the_d_machine/circuit_sims/ecl_gates.asc

Q1: npn; 2N3904
Q2: npn; 2N3904
Q3: npn; 2N3904
Q4: npn; 2N3904
Q5: npn; 2N3904
Q6: npn; 2N3904
Q7: npn; 2N3904
Q8: npn; 2N3904
Q9: npn; 2N3904
Q10: npn; 2N3904
Q11: npn; 2N3904
Q12: npn; 2N3904
Q13: npn; 2N3904
Q14: npn; 2N3904
Q15: npn; 2N3904
Q16: npn; 2N3904
Q17: npn; 2N3904
Q18: npn; 2N3904
Q19: npn; 2N3904
Q20: npn; 2N3904
Q21: npn; 2N3904
R1: res; 779
R2: res; 6.1k
R3: res; 4.98k
R4: res; 220
R5: res; 245
R6: res; 907
R7: res; 2k
R8: res; 2k
R9: res; 779
R10: res; 6.1k
R11: res; 4.98k
R12: res; 220
R13: res; 245
R14: res; 907
R15: res; 50k
R16: res; 50k
R17: res; 779
R18: res; 6.1k
R19: res; 4.98k
R20: res; 220
R21: res; 245
R22: res; 907
R23: res; 50k
R24: res; 50k
V1: voltage; {VCC}
V2: voltage; PULSE(3.4 4.4 0 1n 1n 98n 200n)
Named nets: 0, VCC, IN, OUT, _OUT, OUT3, _OUT3, OUT2, _OUT2
.tran 2000n
.param VCC=5
.dc V2 0 5 0.01
.step param temp -25 125 25
