andrastantos/the_d_machine/circuit_sims/d_flop_bjt.asc

A1: and
A2: and
A3: or
A4: or
A5: or
A6: or
A7: inv
D3: schottky; BAT54
D4: schottky; BAT54
D5: schottky; BAT54
D6: schottky; BAT54
D7: schottky; BAT54
D8: schottky; BAT54
D9: schottky; BAT54
D10: schottky; BAT54
D11: schottky; BAT54
D12: schottky; BAT54
Q1: npn; 2N3904
Q2: npn; 2N3904
Q3: npn; 2N3904
Q4: npn; 2N3904
Q5: npn; 2N3904
Q6: pnp; 2N3906
Q7: pnp; 2N3906
Q8: npn; 2N3904
Q9: pnp; 2N3906
Q10: pnp; 2N3906
Q11: npn; 2N3904
Q12: npn; 2N3904
Q13: npn; 2N3904
Q14: npn; 2N3904
Q15: npn; 2N3904
Q16: npn; 2N3904
Q17: npn; 2N3904
Q18: pnp; 2N3906
Q19: pnp; 2N3906
Q20: npn; 2N3904
Q21: pnp; 2N3906
Q22: pnp; 2N3906
Q23: npn; 2N3904
Q24: npn; 2N3904
Q25: npn; 2N3904
Q26: npn; 2N3904
Q27: npn; 2N3904
Q28: pnp; 2N3906
Q29: pnp; 2N3906
Q30: npn; 2N3904
Q31: pnp; 2N3906
Q32: pnp; 2N3906
Q33: npn; 2N3904
Q34: npn; 2N3904
Q35: npn; 2N3904
Q36: pnp; 2N3906
Q37: pnp; 2N3906
Q38: npn; 2N3904
Q39: pnp; 2N3906
Q40: pnp; 2N3906
Q41: npn; 2N3904
Q42: npn; 2N3904
Q43: npn; 2N3904
Q44: npn; 2N3904
R1: res; 1m
R2: res; {Rout_pull}
R3: res; {Rin*2}
R4: res; {Rin}
R5: res; {Rout_pull}
R6: res; {Rin*2}
R7: res; {Rin}
R8: res; 1m
R9: res; {Rc_up}
R10: res; {Rc_up}
R11: res; 1m
R12: res; {Rout_pull}
R13: res; 1m
R14: res; {Rout_pull}
R15: res; {Rin*2}
R16: res; {Rin}
R17: res; {Rout_pull}
R18: res; {Rin*2}
R19: res; {Rin}
R20: res; 1m
R21: res; {Rc_up}
R22: res; {Rc_up}
R23: res; 1m
R24: res; {Rout_pull}
R25: res; {Rin*2}
R26: res; {Rin}
R27: res; {Rout_pull}
R28: res; {Rin*2}
R29: res; {Rin}
R30: res; 1m
R31: res; {Rc_up}
R32: res; {Rc_up}
R33: res; {Rin*2}
R34: res; {Rin}
R35: res; {Rout_pull}
R36: res; {Rin*2}
R37: res; {Rin}
R38: res; 1m
R39: res; {Rc_up}
R40: res; {Rc_up}
R41: res; {Rout_pull}
R42: res; {Rout_pull}
R43: res; {Rin*2}
R44: res; {Rin}
R47: res; {Rin*2}
R48: res; {Rin}
V_BIT1: voltage; PULSE(0 {VCC} {1/freq/4} {rise} {rise} {1/freq/2-rise} {1/freq} {128*reps}); AC 5
V_BIT5: voltage; PULSE(0 {VCC} 0 {rise} {rise} {2*1/freq/1.5-rise} {2*1/freq/0.75} {256*reps}); AC 5
VCC: voltage; {VCC}
Named nets: 0, VCC, DATA, CLK, _DATA, _CLK, BJTQ1, _BJTQ1, BJTQ2, _BJTQ2
.tran {32*reps/freq}
.param VCC=5
.param freq=10mega
.param rise=1n
.param reps=1
PAR_LD
PAR_D
SHIFT
.param Rin=100
.param Rout_pull=300
.param Rin_ld = 1000
.param Rc_up=300
.step temp -25 125 25
.temp 125
