andrastantos/the_d_machine/circuit_sims/d_flop_cmos.asc

A1: and
A2: and
A3: or
A4: or
A5: or
A6: or
A7: inv
C1: cap; 520p
C2: cap; 520p
C3: cap; 520p
C4: cap; 520p
C5: cap; 520p
C6: cap; 520p
C7: cap; 520p
C8: cap; 520p
C9: cap; 520p
C10: cap; 520p
D1: diode; 1N914
D2: diode; 1N914
D3: schottky; BAT54
D4: schottky; BAT54
D5: schottky; BAT54
D6: schottky; BAT54
D7: schottky; BAT54
D8: schottky; BAT54
D25: diode; 1N914
D26: diode; 1N914
M1: pmos; BSS84
M2: nmos; 2N7002
M3: pmos; BSS84
M4: nmos; 2N7002
M5: pmos; BSS84
M6: nmos; 2N7002
M7: nmos; 2N7002
M8: nmos; 2N7002
M9: pmos; BSS84
M10: nmos; 2N7002
M11: pmos; BSS84
M12: nmos; 2N7002
M13: pmos; BSS84
M14: nmos; 2N7002
M15: nmos; 2N7002
M16: nmos; 2N7002
M17: nmos; 2N7002
M18: nmos; 2N7002
M19: pmos; BSS84
M20: pmos; BSS84
M21: pmos; BSS84
M22: nmos; 2N7002
M23: pmos; BSS84
M24: nmos; 2N7002
M25: nmos; 2N7002
M26: nmos; 2N7002
M27: pmos; BSS84
M28: nmos; 2N7002
M29: nmos; 2N7002
M30: nmos; 2N7002
M31: nmos; 2N7002
M32: nmos; 2N7002
M33: pmos; BSS84
M34: nmos; 2N7002
M35: pmos; BSS84
M36: nmos; 2N7002
M37: nmos; 2N7002
M38: nmos; 2N7002
M39: pmos; BSS84
M40: nmos; 2N7002
M41: pmos; BSS84
M42: nmos; 2N7002
M43: pmos; BSS84
M44: nmos; 2N7002
M45: pmos; BSS84
M46: nmos; 2N7002
M47: nmos; 2N7002
M48: nmos; 2N7002
M49: pmos; BSS84
M50: pmos; BSS84
M51: pmos; BSS84
M52: nmos; 2N7002
M53: pmos; BSS84
M54: nmos; 2N7002
M55: nmos; 2N7002
M56: nmos; 2N7002
M57: pmos; BSS84
M58: nmos; 2N7002
M59: pmos; BSS84
M60: nmos; 2N7002
M61: nmos; 2N7002
M62: nmos; 2N7002
M63: pmos; BSS84
M64: nmos; 2N7002
M65: pmos; BSS84
M66: nmos; 2N7002
M67: nmos; 2N7002
M68: nmos; 2N7002
M69: pmos; BSS84
M70: nmos; 2N7002
M71: pmos; BSS84
M72: nmos; 2N7002
M73: nmos; 2N7002
M74: nmos; 2N7002
Q1: npn; 2N3904
Q2: npn; 2N3904
Q3: npn; 2N3904
Q4: npn; 2N3904
Q5: npn; 2N3904
Q6: pnp; 2N3906
Q7: pnp; 2N3906
Q8: npn; 2N3904
Q9: pnp; 2N3906
Q10: pnp; 2N3906
Q13: npn; 2N3904
Q14: npn; 2N3904
Q15: npn; 2N3904
Q16: npn; 2N3904
Q17: npn; 2N3904
Q18: pnp; 2N3906
Q19: pnp; 2N3906
Q20: npn; 2N3904
Q21: pnp; 2N3906
Q22: pnp; 2N3906
Q23: npn; 2N3904
Q24: npn; 2N3904
Q25: npn; 2N3904
Q26: npn; 2N3904
Q27: npn; 2N3904
Q28: pnp; 2N3906
Q29: pnp; 2N3906
Q30: npn; 2N3904
Q31: pnp; 2N3906
Q32: pnp; 2N3906
R1: res; 1m
R2: res; {Rout_pull}
R3: res; {Rin*2}
R4: res; {Rin}
R5: res; {Rout_pull}
R6: res; {Rin*2}
R7: res; {Rin}
R8: res; 1m
R9: res; {Rc_up}
R10: res; {Rc_up}
R13: res; 1m
R14: res; {Rout_pull}
R15: res; {Rin*2}
R16: res; {Rin}
R17: res; {Rout_pull}
R18: res; {Rin*2}
R19: res; {Rin}
R20: res; 1m
R21: res; {Rc_up}
R22: res; {Rc_up}
R23: res; 1m
R24: res; {Rout_pull}
R25: res; {Rin*2}
R26: res; {Rin}
R27: res; {Rout_pull}
R28: res; {Rin*2}
R29: res; {Rin}
R30: res; 1m
R31: res; {Rc_up}
R32: res; {Rc_up}
V_BIT1: voltage; PULSE(0 {VCC} {1/freq/4} {rise} {rise} {1/freq/2-rise} {1/freq} {128*reps}); AC 5
V_BIT5: voltage; PULSE(0 {VCC} 0 {rise} {rise} {2*1/freq/1.5-rise} {2*1/freq/0.75} {256*reps}); AC 5
VCC1: voltage; {VCC+1.7}
VCC: voltage; {VCC}
Named nets: 0, VCC, DATA, CLK, _Q, VCC5, DOUT, Q, _DATA, _CLK, DLOAD, BJTQ, _BJTQ, BJTDOUT, _DLOAD, DynOUT, DynOUT2, DynOUT3, DynOUTb, BJTQ2, _BJTQ2
.tran {32*reps/freq}
.param VCC=3.3
.param freq=11mega
.param rise=1n
.param reps=1
PAR_LD
PAR_D
SHIFT
.param Rin=100
.param Rout_pull=300
.param Rin_ld = 1000
.param Rc_up=300
.step temp -25 125 25
.temp 125
