andrastantos/the_d_machine/circuit_sims/d_flop.asc

A1: and
A2: and
A3: or
A4: or
A5: or
A6: or
A7: inv
C1: cap; 47p
C2: cap; 22p
C3: cap; 22p
C4: cap; 220p
C5: cap; 10p
D1: schottky; BAT54
D2: schottky; BAT54
D3: schottky; BAT54
D4: schottky; BAT54
D5: schottky; BAT54
D6: schottky; BAT54
D7: schottky; BAT54
D8: schottky; BAT54
D9: schottky; BAT54
D10: schottky; BAT54
D11: schottky; BAT54
D12: schottky; BAT54
D13: schottky; BAT54
D14: schottky; BAT54
D15: schottky; BAT54
D16: schottky; BAT54
D17: schottky; BAT54
D18: schottky; BAT54
D19: schottky; BAT54
D20: schottky; BAT54
D61: schottky; BAT54
D62: schottky; BAT54
L1: ind; 10µ
L2: ind; 1µ
Q1: npn; 2N3904
Q2: npn; 2N3904
Q3: npn; 2N3904
Q4: npn; 2N3904
Q5: npn; 2N3904
Q6: pnp; 2N3906
Q7: pnp; 2N3906
Q8: npn; 2N3904
Q9: pnp; 2N3906
Q10: pnp; 2N3906
Q11: npn; 2N3904
Q12: npn; 2N3904
Q13: npn; 2N3904
Q14: npn; 2N3904
Q15: pnp; 2N3906
Q16: pnp; 2N3906
Q17: pnp; 2N3906
Q18: pnp; 2N3906
Q19: pnp; 2N3906
Q20: npn; 2N3904
Q21: npn; 2N3904
Q22: npn; 2N3904
Q23: npn; 2N3904
Q24: npn; 2N3904
Q25: pnp; 2N3906
Q26: npn; 2N3904
Q27: npn; 2N3904
Q28: npn; 2N3904
Q29: pnp; 2N3906
Q30: pnp; 2N3906
Q31: pnp; 2N3906
Q32: npn; 2N3904
Q33: npn; 2N3904
Q34: pnp; 2N3906
Q35: pnp; 2N3906
Q36: pnp; 2N3906
Q37: npn; 2N3904
Q38: npn; 2N3904
Q39: npn; 2N3904
Q40: npn; 2N3904
Q41: npn; 2N3904
Q42: npn; 2N3904
Q43: npn; 2N3904
Q44: npn; 2N3904
Q45: pnp; 2N3906
Q46: pnp; 2N3906
Q47: pnp; 2N3906
Q48: npn; 2N3904
Q49: npn; 2N3904
Q51: npn; 2N3904
Q52: npn; 2N3904
Q53: npn; 2N3904
Q55: pnp; 2N3906
Q56: pnp; 2N3906
Q190: npn; 2N3904
Q191: npn; 2N3904
Q192: npn; 2N3904
Q193: npn; 2N3904
R1: res; {Rout_pull}
R2: res; 1m
R3: res; 1m
R4: res; {Rout_pull}
R5: res; {Rin*2}
R6: res; {Rin}
R7: res; {Rc_up}
R8: res; {Rc_up}
R9: res; {Rout_pull}
R10: res; 1m
R11: res; {Rin*2}
R12: res; {Rin}
R13: res; {Rin*2}
R14: res; {Rin}
R15: res; {Rout_pull}
R16: res; {Rin*2}
R17: res; {Rin}
R18: res; 1m
R19: res; {Rout_pull}
R20: res; {Rin*2}
R21: res; {Rin}
R22: res; 1m
R23: res; {Rc_up}
R24: res; {Rc_up}
R25: res; {Rout_pull}
R26: res; 1m
R27: res; {Rin*2}
R28: res; {Rin}
R29: res; {Rout_pull}
R30: res; {Rin}
R31: res; {Rin}
R32: res; 500
R33: res; {Rout_pull}
R34: res; {Rin*2}
R35: res; {Rin}
R36: res; 1m
R37: res; {Rout_pull}
R38: res; {Rin*2}
R39: res; {Rc_up}
R40: res; {Rin}
R41: res; {Rout_pull}
R42: res; {Rin*2}
R43: res; {Rin}
R44: res; 1m
R45: res; {Rc_up}
R46: res; 1k
R47: res; 1k
R48: res; 10
R49: res; {Rout_pull}
R50: res; {Rin}
R51: res; {Rin}
R52: res; 1m
R53: res; 1m
R54: res; 1
R55: res; 1m
R56: res; 1m
R57: res; {Rin}
R58: res; {Rin}
R59: res; 1
R60: res; 10
R61: res; 1m
R62: res; 1m
R63: res; 1m
R64: res; {Rin}
R65: res; {Rin}
R66: res; {Rout_pull}
R67: res; 1m
R68: res; {Rin*2}
R69: res; {Rin}
R70: res; 500
R71: res; 35
R72: res; 1m
R73: res; 1m
R74: res; 1m
R75: res; {Rin}
R76: res; {Rin}
R77: res; 1
R79: res; 1m
R80: res; 1m
R81: res; 1m
R82: res; {Rin}
R83: res; {Rin}
R427: res; {Rout_pull}
R428: res; {Rout_pull}
R429: res; {Rin*2}
R430: res; 1m
R431: res; {Rin}
R433: res; {Rin*2}
R434: res; {Rin}
V1: voltage; 2.5
V2: voltage; 2.5
V3: voltage; 2.5
V_BIT1: voltage; PULSE(0 {VCC} {1/freq/4} {rise} {rise} {1/freq/2-rise} {1/freq} {128*reps}); AC 5
V_BIT5: voltage; PULSE(0 {VCC} 0 {rise} {rise} {1/freq/1.5-rise} {1/freq/0.75} {256*reps}); AC 5
VCC: voltage; {VCC}
Named nets: 0, VCC, DATA, CLK, EN, _D, D, DCLK, _EN, D0, _D0, D1, _D1, _CLK, _DCLK, D2, _D2, inv_int, inv_final, inv_ac
.tran {32*reps/freq}
.param VCC=5
.param freq=20mega
.param rise=1n
.param reps=1
PAR_LD
PAR_D
SHIFT
.param Rin=100
.param Rout_pull=300
.param Rin_ld = 1000
.param Rc_up=1000
.step temp -25 125 25
.temp 125
This is a temperature-compensated edge-generator
Very high current (200mA) through this diode!!!!
