andrastantos/the_d_machine/circuit_sims/logic_gates.asc

C1: cap; 50p
C2: cap; 50p
D1: schottky; BAT54
D2: schottky; BAT54
D3: schottky; BAT54
D4: schottky; BAT54
D5: schottky; BAT54
D6: schottky; BAT54
D7: schottky; BAT54
D8: schottky; BAT54
D9: schottky; BAT54
D10: schottky; BAT54
D11: schottky; BAT54
D12: schottky; BAT54
D13: schottky; BAT54
D14: schottky; BAT54
D15: schottky; BAT54
D16: schottky; BAT54
D17: schottky; BAT54
D18: schottky; BAT54
D19: schottky; BAT54
D20: schottky; BAT54
D21: schottky; BAT54
D22: schottky; BAT54
D23: schottky; BAT54
D24: schottky; BAT54
D25: schottky; BAT54
D26: schottky; BAT54
D27: schottky; BAT54
D28: schottky; BAT54
D29: schottky; BAT54
D30: schottky; BAT54
D31: schottky; BAT54
D32: schottky; BAT54
D33: schottky; BAT54
Q1: npn; 2N3904
Q2: npn; 2N3904
Q3: npn; 2N3904
Q4: npn; 2N3904
Q5: npn; 2N3904
Q6: npn; 2N3904
Q7: npn; 2N3904
Q8: npn; 2N3904
Q9: npn; 2N3904
Q10: npn; 2N3904
Q11: pnp; 2N3906
Q12: pnp; 2N3906
Q13: npn; 2N3904
Q14: npn; 2N3904
Q15: npn; 2N3904
Q16: npn; 2N3904
Q17: npn; 2N3904
Q18: npn; 2N3904
Q19: npn; 2N3904
Q20: npn; 2N3904
Q21: npn; 2N3904
Q22: npn; 2N3904
Q23: npn; 2N3904
Q24: npn; 2N3904
Q25: pnp; 2N3906
Q26: pnp; 2N3906
Q27: npn; 2N3904
Q28: npn; 2N3904
Q29: npn; 2N3904
Q30: pnp; 2N3906
Q31: npn; 2N3904
Q32: pnp; 2N3906
Q33: npn; 2N3904
Q34: npn; 2N3904
Q35: npn; 2N3904
Q36: npn; 2N3904
Q37: npn; 2N3904
Q38: pnp; 2N3906
Q39: pnp; 2N3906
Q40: npn; 2N3904
Q41: npn; 2N3904
Q42: npn; 2N3904
Q43: pnp; 2N3906
Q44: pnp; 2N3906
Q45: pnp; 2N3906
Q46: npn; 2N3904
Q49: npn; 2N3904
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
 
Rb=100 --> 4/5ns gate delay; 35mA gate power
Rb=200 --> 6/8ns gate delay; 20mA gate power
.param Rin=100
.param Rout=50
.step  temp -25 125 25
;.step param Rb 10 110 25
This is the simplest inverter chain I could come up with
