andrastantos/the_d_machine/circuit_sims/register.asc

A1: and
A2: and
A3: or
A4: or
A5: or
A6: or
A7: inv
D1: schottky; BAT54
D2: schottky; BAT54
D3: schottky; BAT54
D4: schottky; BAT54
D5: schottky; BAT54
D6: schottky; BAT54
D7: schottky; BAT54
D8: schottky; BAT54
D9: schottky; BAT54
D10: schottky; BAT54
D11: schottky; BAT54
D12: schottky; BAT54
D13: schottky; BAT54
D14: schottky; BAT54
D15: schottky; BAT54
D16: schottky; BAT54
D17: schottky; BAT54
D18: schottky; BAT54
D19: schottky; BAT54
D20: schottky; BAT54
D21: schottky; BAT54
D22: schottky; BAT54
D23: schottky; BAT54
D24: schottky; BAT54
D61: schottky; BAT54
D62: schottky; BAT54
Q1: npn; 2N3904
Q2: npn; 2N3904
Q3: npn; 2N3904
Q4: npn; 2N3904
Q5: npn; 2N3904
Q6: pnp; 2N3906
Q7: pnp; 2N3906
Q8: npn; 2N3904
Q9: pnp; 2N3906
Q10: pnp; 2N3906
Q11: npn; 2N3904
Q12: npn; 2N3904
Q13: npn; 2N3904
Q14: npn; 2N3904
Q15: pnp; 2N3906
Q16: pnp; 2N3906
Q17: pnp; 2N3906
Q18: pnp; 2N3906
Q19: pnp; 2N3906
Q20: npn; 2N3904
Q21: npn; 2N3904
Q22: npn; 2N3904
Q23: npn; 2N3904
Q24: npn; 2N3904
Q25: pnp; 2N3906
Q26: npn; 2N3904
Q27: npn; 2N3904
Q28: npn; 2N3904
Q29: npn; 2N3904
Q30: pnp; 2N3906
Q31: pnp; 2N3906
Q32: npn; 2N3904
Q33: pnp; 2N3906
Q34: pnp; 2N3906
Q35: npn; 2N3904
Q36: npn; 2N3904
Q37: npn; 2N3904
Q38: npn; 2N3904
Q39: npn; 2N3904
Q40: npn; 2N3904
Q41: pnp; 2N3906
Q42: npn; 2N3904
Q43: npn; 2N3904
Q44: pnp; 2N3906
Q45: npn; 2N3904
Q46: npn; 2N3904
Q47: npn; 2N3904
Q48: npn; 2N3904
Q49: npn; 2N3904
Q50: npn; 2N3904
Q51: pnp; 2N3906
Q52: npn; 2N3904
Q53: npn; 2N3904
Q54: pnp; 2N3906
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
.tran {32*reps/freq}
.param VCC=5
.param freq=1mega
.param rise=1n
.param reps=1
PAR_LD
PAR_D
SHIFT
.param Rin=100
.param Rout_pull=300
.param Rin_ld = 1000
.param Rc_up=1000
;.step temp -25 125 25
.temp 125
