andrastantos/the_d_machine/circuit_sims/alu.asc

A1: and; Vhigh={VCC}
A2: or; Vhigh={VCC}
A3: or; Vhigh={VCC}
A4: and; Vhigh={VCC}
A5: and; Vhigh={VCC}
A6: and; Vhigh={VCC}
A7: and; Vhigh={VCC}
A8: and; Vhigh={VCC}
A9: and; Vhigh={VCC}
A10: or; Vhigh={VCC}
A11: dflop; Vhigh={VCC}
A12: inv; Vhigh={VCC}
A13: dflop; Vhigh={VCC}
A14: dflop; Vhigh={VCC}
A15: dflop; Vhigh={VCC}
A16: dflop; Vhigh={VCC}
D2: schottky; BAT54
D3: schottky; BAT54
D4: schottky; BAT54
D7: schottky; BAT54
D8: schottky; BAT54
Q1: npn; 2N3904
Q3: npn; 2N3904
Q4: npn; 2N3904
Q5: npn; 2N3904
Q6: npn; 2N3904
Q13: npn; 2N3904
Q30: npn; 2N3904
Q31: npn; 2N3904
Q32: npn; 2N3904
Q33: pnp; 2N3906
Q34: pnp; 2N3906
Q35: pnp; 2N3906
Q36: pnp; 2N3906
Q37: pnp; 2N3906
Q38: pnp; 2N3906
Q39: pnp; 2N3906
Q41: pnp; 2N3906
Q43: pnp; 2N3906
Q44: pnp; 2N3906
Q52: npn; 2N3904
Q53: pnp; 2N3906
Q54: pnp; 2N3906
Q55: pnp; 2N3906
Q57: npn; 2N3904
Q61: npn; 2N3904
Q63: npn; 2N3904
Q65: npn; 2N3904
Q66: pnp; 2N3906
Q67: pnp; 2N3906
Q70: npn; 2N3904
Q71: npn; 2N3904
Q72: npn; 2N3904
Q73: pnp; 2N3906
Q74: pnp; 2N3906
Q75: pnp; 2N3906
Q76: pnp; 2N3906
Q77: pnp; 2N3906
Q78: pnp; 2N3906
Q79: pnp; 2N3906
Q82: pnp; 2N3906
Q83: npn; 2N3904
R1: res; 1m
R2: res; 1m
R3: res; 1m
R4: res; 1m
R5: res; 1m
R6: res; 1m
R7: res; 1m
R8: res; 1m
R9: res; {Rout_pull}
R10: res; {Rin*2}
R11: res; {Rin}
R12: res; {Rout_pull}
R13: res; {Rin*2}
R14: res; {Rin}
R15: res; {Rout_pull}
R16: res; {Rin*2}
R17: res; {Rin}
R18: res; {Rout_pull}
R19: res; {Rin*2}
R20: res; {Rin}
R21: res; {Rout_pull}
R22: res; {Rin*2}
R24: res; {Rin}
R89: res; {Re_pull}
R93: res; {Re_pull}
R122: res; {Re_pull}
R131: res; {Re_pull}
R136: res; 1m
R146: res; {Re_pull}
R150: res; {Re_pull}
R155: res; 1m
V_BIT5: voltage; PULSE(0 {VCC} 0 {rise} {rise} {1/freq/2-rise} {1/freq} {256*reps}); AC 5
VCC: voltage; {VCC}
Named nets: 0, VCC, T_OUT, A_IN, B_IN, C_IN, _ADD_EN, _CARRY_OUT, COUT_1, COUT_0, CARRY_OUT, BIT0, BIT1, BIT2, _BIT3, BIT4, BIT5, _AND_EN, _OR_EN, L_OUT, BIT3, L_carry_out, _BIT1, _BIT2, _BIT4, _BIT5
.tran {32*reps/freq}
.param VCC=5
.param freq=16Mega
.param rise=1n
.param reps=1
.param Re_pull=220
Rb controls gate delay (rise and fall edge) as well as gate power consumption.
 
Rb=100 --> 4/5ns gate delay; 35mA gate power
Rb=200 --> 6/8ns gate delay; 20mA gate power
ALU
ADD: _AND_EN=1 _OR_EN=0 _ADD_EN=0
XNOR: _AND_EN=1 _OR_EN=X _ADD_EN=0 C_IN=1
XOR: _AND_EN=X _OR_EN=0 _ADD_EN=0 C_IN=0
NOR: _AND_EN=0 _OR_EN=X _ADD_EN=0 C_IN=1
NAND: _AND_EN=X _OR_EN=1 _ADD_EN=0 C_IN=0
MOV_A: _AND_EN=1 _OR_EN=0 _ADD_EN=0 C_IN=0 B_IN=0
MOV_B: _AND_EN=1 _OR_EN=0 _ADD_EN=0 C_IN=0 A_IN=0
.param Rout_pull=250
.param Rin=100
.step  temp -25 125 25
.temp 125
