andrastantos/the_d_machine/circuit_sims/alu_2bit.asc

A1: and; Vhigh={VCC}
A2: or; Vhigh={VCC}
A3: or; Vhigh={VCC}
A4: and; Vhigh={VCC}
A5: and; Vhigh={VCC}
A6: and; Vhigh={VCC}
A7: and; Vhigh={VCC}
A8: and; Vhigh={VCC}
A9: and; Vhigh={VCC}
A10: or; Vhigh={VCC}
A11: dflop; Vhigh={VCC}
A12: inv; Vhigh={VCC}
A13: dflop; Vhigh={VCC}
A14: dflop; Vhigh={VCC}
A15: dflop; Vhigh={VCC}
A16: dflop; Vhigh={VCC}
D1: schottky; BAT54
D2: schottky; BAT54
D3: schottky; BAT54
D4: schottky; BAT54
D5: schottky; BAT54
D6: schottky; BAT54
D7: schottky; BAT54
D8: schottky; BAT54
D9: schottky; BAT54
D10: schottky; BAT54
Q1: npn; 2N3904
Q2: pnp; 2N3906
Q3: npn; 2N3904
Q4: npn; 2N3904
Q5: npn; 2N3904
Q6: npn; 2N3904
Q7: pnp; 2N3906
Q8: npn; 2N3904
Q9: npn; 2N3904
Q10: npn; 2N3904
Q11: npn; 2N3904
Q12: npn; 2N3904
Q13: npn; 2N3904
Q14: npn; 2N3904
Q15: npn; 2N3904
Q16: pnp; 2N3906
Q17: pnp; 2N3906
Q18: pnp; 2N3906
Q19: pnp; 2N3906
Q20: pnp; 2N3906
Q21: pnp; 2N3906
Q22: pnp; 2N3906
Q23: pnp; 2N3906
Q24: pnp; 2N3906
Q25: pnp; 2N3906
Q26: pnp; 2N3906
Q27: pnp; 2N3906
Q28: npn; 2N3904
Q29: npn; 2N3904
Q30: npn; 2N3904
Q31: npn; 2N3904
Q32: npn; 2N3904
Q33: pnp; 2N3906
Q34: pnp; 2N3906
Q35: pnp; 2N3906
Q36: pnp; 2N3906
Q37: pnp; 2N3906
Q38: pnp; 2N3906
Q39: pnp; 2N3906
Q40: npn; 2N3904
Q41: pnp; 2N3906
Q42: npn; 2N3904
Q43: pnp; 2N3906
Q44: pnp; 2N3906
Q45: pnp; 2N3906
Q46: pnp; 2N3906
Q47: npn; 2N3904
Q48: npn; 2N3904
Q49: npn; 2N3904
Q50: pnp; 2N3906
Q51: pnp; 2N3906
Q52: npn; 2N3904
Q53: pnp; 2N3906
Q54: pnp; 2N3906
Q55: pnp; 2N3906
Q56: pnp; 2N3906
Q57: npn; 2N3904
Q58: pnp; 2N3906
Q59: pnp; 2N3906
Q60: pnp; 2N3906
Q61: npn; 2N3904
Q62: pnp; 2N3906
Q63: npn; 2N3904
Q64: npn; 2N3904
Q65: npn; 2N3904
Q66: pnp; 2N3906
Q67: pnp; 2N3906
Q68: npn; 2N3904
Q70: npn; 2N3904
Q71: npn; 2N3904
Q72: npn; 2N3904
Q73: pnp; 2N3906
Q74: pnp; 2N3906
Q75: pnp; 2N3906
Q76: pnp; 2N3906
Q77: pnp; 2N3906
Q78: pnp; 2N3906
Q79: pnp; 2N3906
Q82: pnp; 2N3906
Q83: npn; 2N3904
R1: res; 1m
R2: res; 1m
R3: res; 1m
R4: res; 1m
R5: res; 220
R6: res; 1m
R7: res; 1m
R8: res; 1m
R9: res; {Rout_pull}
R10: res; {Rin*6}
R11: res; {Rin*3}
R12: res; {Rout_pull}
R13: res; {Rin*6}
R14: res; {Rin*3}
R15: res; {Rout_pull}
R16: res; {Rin*6}
R17: res; {Rin*3}
R18: res; {Rout_pull}
R19: res; {Rin*6}
R20: res; {Rin*3}
R21: res; {Rout_pull}
R22: res; {Rin*6}
R23: res; 1m
R24: res; {Rin*3}
R25: res; 1m
R26: res; 1m
R27: res; 1m
R28: res; 1m
R29: res; 1m
R30: res; 1m
R31: res; 1m
R32: res; 1m
R33: res; 1m
R34: res; 1m
R35: res; 1m
R36: res; 1m
R37: res; 220
R38: res; 1m
R39: res; 1m
R40: res; 1m
R41: res; 220
R42: res; 1m
R43: res; 1m
R44: res; 1m
R45: res; 1m
R46: res; 1m
R47: res; 1m
R48: res; {Rout_pull}
R49: res; {Rin*6}
R50: res; {Rin*3}
R51: res; {Rout_pull}
R52: res; {Rin*6}
R53: res; {Rin*3}
R54: res; {Rout_pull}
R55: res; {Rin*6}
R56: res; {Rin*3}
R57: res; 1m
R58: res; 1m
R59: res; 1m
R60: res; 220
R61: res; 1m
R62: res; 1m
R63: res; 1m
R64: res; 1m
R65: res; 1m
R66: res; 1m
R67: res; 220
R68: res; 1m
R69: res; 1m
R70: res; 1m
R71: res; 220
R72: res; 1m
R73: res; 1m
R74: res; 1m
R75: res; 1m
R76: res; 1m
R77: res; 1m
R78: res; 1m
R79: res; 1m
R80: res; 1m
R81: res; {Rout_pull}
R82: res; {Rin*6}
R83: res; {Rin*3}
R84: res; 1m
R85: res; {Rout_pull}
R86: res; {Rin*6}
R87: res; 1m
R88: res; 1m
R89: res; 220
R90: res; 1m
R91: res; 1m
R92: res; 1m
R93: res; 220
R94: res; 1m
R95: res; {Rin*3}
R98: res; 1m
R99: res; 1m
R100: res; 1m
R103: res; 1m
R107: res; 1m
R108: res; 1m
R109: res; 1m
R111: res; 1m
R113: res; 1m
R115: res; 1m
R119: res; 1m
R122: res; 220
R124: res; 1m
R125: res; 1m
R126: res; 1m
R127: res; 1m
R128: res; 1m
R129: res; 1m
R131: res; 220
R132: res; 1m
R136: res; 1m
R137: res; 1m
R138: res; 1m
R144: res; 1m
R145: res; 1m
R146: res; 220
R147: res; 1m
R148: res; 1m
R149: res; 1m
R150: res; 220
R151: res; 1m
R152: res; 1m
R153: res; 1m
R154: res; 1m
R155: res; 1m
V_BIT5: voltage; PULSE(0 {VCC} 0 {rise} {rise} {1/freq/2-rise} {1/freq} {256*reps}); AC 5
VCC: voltage; {VCC}
Named nets: 0, VCC, T_OUT, A_IN, B_IN, C_IN, _ADD_EN, _CARRY_OUT, COUT_1, COUT_0, CARRY_OUT, _AND_EN, _OR_EN, L_OUT, L_carry_out, T_OUT2, _CARRY_OUT2, CARRY_OUT2
.tran {32*reps/freq}
.ac oct 100 1k 100mega
.dc V_IN 0 5 0.01
.param VCC=5
.param freq=1Mega
.param rise=1n
.param reps=1
.param Rb=100
Rb controls gate delay (rise and fall edge) as well as gate power consumption.
 
Rb=100 --> 4/5ns gate delay; 35mA gate power
Rb=200 --> 6/8ns gate delay; 20mA gate power
ALU
ADD: _AND_EN=1 _OR_EN=0 _ADD_EN=0
XNOR: _AND_EN=1 _OR_EN=X _ADD_EN=0 C_IN=1
XOR: _AND_EN=X _OR_EN=0 _ADD_EN=0 C_IN=0
NOR: _AND_EN=0 _OR_EN=X _ADD_EN=0 C_IN=1
NAND: _AND_EN=X _OR_EN=1 _ADD_EN=0 C_IN=0
MOV_A: _AND_EN=1 _OR_EN=0 _ADD_EN=0 C_IN=0 B_IN=0
MOV_B: _AND_EN=1 _OR_EN=0 _ADD_EN=0 C_IN=0 A_IN=0
.param Rout_pull=250
.param Rin=100
.param Rout=50
.step  temp -25 125 25
ALU
