andrastantos/the_d_machine/circuit_sims/bitcell.asc

D1: schottky; BAT54
D2: schottky; BAT54
D7: schottky; BAT54
D8: schottky; BAT54
D9: schottky; BAT54
D10: schottky; BAT54
D11: schottky; BAT54
D12: schottky; BAT54
D13: schottky; BAT54
D14: schottky; BAT54
D15: schottky; BAT54
D16: schottky; BAT54
D17: schottky; BAT54
D18: schottky; BAT54
D19: schottky; BAT54
D20: schottky; BAT54
D21: schottky; BAT54
D22: schottky; BAT54
D23: schottky; BAT54
D24: schottky; BAT54
D25: diode; 1N4148
D26: diode; 1N4148
D27: diode; 1N4148
D28: schottky; BAT54
D29: diode; 1N4148
D30: schottky; BAT54
D31: schottky; BAT54
D32: schottky; BAT54
D33: schottky; BAT54
D34: schottky; BAT54
D35: schottky; BAT54
D36: schottky; BAT54
D37: schottky; BAT54
D38: schottky; BAT54
D39: schottky; BAT54
D40: schottky; BAT54
D41: schottky; BAT54
D42: schottky; BAT54
D43: schottky; BAT54
D44: schottky; BAT54
E3: e; 1
E4: e; 1
I1: load2; 20m
Q1: npn; 2N3904
Q2: pnp; 2N3906
Q3: npn; 2N3904
Q4: pnp; 2N3906
Q5: npn; 2N3904
Q6: pnp; 2N3906
Q7: npn; 2N3904
Q8: pnp; 2N3906
Q9: npn; 2N3904
Q10: pnp; 2N3906
Q11: npn; 2N3904
Q12: pnp; 2N3906
Q13: npn; 2N3904
Q14: pnp; 2N3906
Q15: npn; 2N3904
Q16: pnp; 2N3906
Q17: npn; 2N3904
Q18: pnp; 2N3906
Q19: npn; 2N3904
Q20: pnp; 2N3906
Q21: npn; 2N3904
Q22: pnp; 2N3906
Q23: npn; 2N3904
Q24: pnp; 2N3906
Q25: npn; 2N3904
Q26: pnp; 2N3906
Q27: npn; 2N3904
Q28: pnp; 2N3906
Q29: npn; 2N3904
Q30: pnp; 2N3906
Q31: npn; 2N3904
Q32: pnp; 2N3906
Q33: npn; 2N3904
Q34: npn; 2N3904
Q35: npn; 2N3904
Q36: pnp; 2N3906
Q37: npn; 2N3904
Q38: pnp; 2N3906
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
.ac oct 100 1k 100mega
.dc V_BIT0 0 {VCC} 0.01
.param VCC=5
.param freq=10Mega
.param rise=1n
.param reps=1
.param Rb=100
Rb controls gate delay (rise and fall edge) as well as gate power consumption.
 
Rb=100 --> 4/5ns gate delay; 35mA gate power
Rb=200 --> 6/8ns gate delay; 20mA gate power
This invertert chain produces 1.5V swing around 2.5V, consumes around 15mA per inverter and seems to have a propagation delay of about 1ns.
.param Rinv_in=100
.step temp -25 125 25
I think this is the inverter I would want to use for logic. This needs a 5V supply to operate reasonable well though, which incerases power consumption quite a bit.
