andrastantos/the_d_machine/circuit_sims/bitcell_nmos.asc

M1: nmos; 2N7002
M2: nmos; 2N7002
M3: nmos; 2N7002
M4: nmos; 2N7002
M5: nmos; 2N7002
M6: nmos; 2N7002
R1: res; {R}
R2: res; R=R/2
R3: res; R=R/2
R4: res; R=R/2
R5: res; R=R/2
VB: voltage; {VB}
VCC: voltage; {VCC}
WR: voltage; PULSE(0 {VCC} 2u 10n 10n 1.5u 8u 10)
X: voltage; PULSE({VCC} 0 0 10n 10n 2u 4u 10)
Y: voltage; PULSE({VCC} 0 1u 10n 10n 2u 4u 10)
Named nets: 0, B1, BIT, EN, X, Y
.param VCC=3.3 R=500 VB=5
.tran 100u
