andrastantos/the_d_machine/circuit_sims/low_power_inverter.asc

A11: dflop; Vhigh={VH-VL}
A13: dflop; Vhigh={VH-VL}
A14: dflop; Vhigh={VH-VL}
A15: dflop; Vhigh={VH-VL}
A16: dflop; Vhigh={VH-VL}
D1: schottky; BAT54
D2: schottky; BAT54
D3: diode; 1N914
D4: schottky; BAT54
D5: diode; 1N914
D10: diode; 1N914
D11: schottky; BAT54
D12: diode; 1N914
Q1: npn; 2N3904
Q2: npn; 2N3904
Q3: npn; 2N3904
Q6: npn; 2N3904
R1: res; R=R_b
R2: res; R=R_b
R3: res; R=R_b
R4: res; R=R_fb
R5: res; R=R_fb
R6: res; R=R_fb
R7: res; R=R_c
R8: res; R=R_c
R9: res; R=R_c
R10: res; R=R_d
R11: res; 1m
R12: res; 1m
R13: res; R=R_d
R14: res; R=R_d
R15: res; R=R_e
R16: res; R=R_e
R17: res; R=R_e
R18: res; 1m
R26: res; 1m
R30: res; R=R_e
R31: res; R=R_b
R32: res; R=R_fb
R33: res; R=R_c
R34: res; R=R_d
R107: res; 1m
R109: res; 1m
V_BIT5: voltage; PULSE(0 {VH-VL} 0 {rise} {rise} {1/freq/2-rise} {1/freq} {256*reps}); AC {VH}
V_IN1: voltage; PULSE({VL} {VH} 0 1n 1n 24n 50n 1000)
VCC1: voltage; {VL}
VCC: voltage; {VCC}
Named nets: 0, VCC, A_IN, B_IN, C_IN, _ADD_EN, _AND_EN, _OR_EN, COUT_0, COUT_1, _B_IN, EN, _D, D, _C_IN, O1, O2, O3, O4
.tran {2*reps/freq}
.ac oct 100 1k 100mega
.param VCC=5
.param freq=20mega
.param rise=1n
.param reps=1
.param Rb=200
Rb controls gate delay (rise and fall edge) as well as gate power consumption.
 
Rb=100 --> 4/5ns gate delay; 35mA gate power
Rb=200 --> 6/8ns gate delay; 20mA gate power
.dc V_IN1 0 5 0.01
.tran 500n
.step temp -25 125 25
;.step param VH 1 2.5 0.1
.param VH=5
.param VL=0.0
.param R_c=50
.param R_e=1m
.param R_b=100
.param R_fb=1mega
.param R_d=7
