andrastantos/the_d_machine/circuit_sims/register_bjt.asc

A11: dflop; Vhigh={VH-VL}
A13: dflop; Vhigh={VH-VL}
A14: dflop; Vhigh={VH-VL}
A15: dflop; Vhigh={VH-VL}
A16: dflop; Vhigh={VH-VL}
D1: diode; 1N4148
D2: schottky; BAT54
D3: schottky; BAT54
D4: diode; 1N914
D5: schottky; BAT54
D6: diode; 1N914
D7: diode; 1N914
D8: schottky; BAT54
D9: diode; 1N914
D10: schottky; BAT54
D11: diode; 1N914
D12: schottky; BAT54
D13: diode; 1N914
D14: schottky; BAT54
D15: diode; 1N914
D16: schottky; BAT54
D17: diode; 1N914
D18: schottky; BAT54
D19: diode; 1N914
D20: schottky; BAT54
D21: diode; 1N914
D22: schottky; BAT54
Q1: npn; 2N3904
Q2: npn; 2N3904
Q3: npn; 2N3904
Q4: npn; 2N3904
Q5: npn; 2N3904
Q6: npn; 2N3904
Q7: pnp; 2N3906
Q8: npn; 2N3904
Q9: npn; 2N3904
Q10: npn; 2N3904
Q11: npn; 2N3904
Q12: npn; 2N3904
Q13: pnp; 2N3906
Q14: pnp; 2N3906
Q15: npn; 2N3904
Q16: npn; 2N3904
Q17: npn; 2N3904
Q18: npn; 2N3904
Q19: npn; 2N3904
Q21: npn; 2N3904
R1: res; 100
R2: res; 75
R3: res; 180
R4: res; 220
R5: res; 10k
R6: res; 1m
R7: res; 20
R8: res; 1m
R9: res; 200
R10: res; 200
R11: res; 1m
R12: res; 1m
R13: res; 1k
R14: res; 1k
R15: res; 500
R16: res; 20
R17: res; 1m
R18: res; 200
R19: res; 1k
R20: res; 500
R21: res; 500
R22: res; 20
R23: res; 1m
R24: res; 1m
R25: res; 200
R26: res; 1m
R27: res; 1k
R28: res; 500
R29: res; 20
R30: res; 1m
R31: res; 100
R32: res; 1m
R33: res; 1k
R34: res; 500
R35: res; 20
R36: res; 1m
R37: res; 100
R38: res; 1k
R39: res; 500
R40: res; 20
R41: res; 1m
R42: res; 100
R43: res; 1k
R44: res; 500
R45: res; 20
R46: res; 1m
R47: res; 100
R48: res; 1k
R49: res; 500
R50: res; 20
R51: res; 1m
R52: res; 100
R53: res; 1k
R54: res; 500
R55: res; 20
R56: res; 1m
R57: res; 100
R58: res; 1k
R59: res; 500
R60: res; 20
R61: res; 100
R62: res; 100
R63: res; 100
R64: res; 100
R65: res; 2k
R66: res; 1k
R67: res; 2k
R68: res; 1k
R69: res; 10k
R70: res; 1k
R71: res; 1m
R72: res; 2k
R73: res; 1k
R107: res; 1m
R109: res; 1m
R168: res; 810
R169: res; 1k
R171: res; 15
R174: res; 22
V_BIT5: voltage; PULSE(0 {VH-VL} 0 {rise} {rise} {1/freq/2-rise} {1/freq} {256*reps}); AC {VH}
V_IN1: voltage; PULSE({VL} {VH} 0 1n 1n 24n 50n 1000)
V_IN: voltage; PULSE(0 3 0 1n 1n 24n 50n 1000)
VCC1: voltage; {VL}
VCC: voltage; {VCC}
VCC_1: voltage; 12
VCC_3: voltage; 3
VCC_12: voltage; 30
VCC_NEG: voltage; 12
Named nets: 0, VCC, A_IN, B_IN, C_IN, _ADD_EN, _AND_EN, _OR_EN, COUT_0, COUT_1, _B_IN, EN, _D, D, _O1, I1, O1, IN, O2, O4, O3, S1, S2, S4, S3, O, _C_IN, _O, _OO
.tran {2*reps/freq}
.ac oct 100 1k 100mega
.param VCC=5
.param freq=20mega
.param rise=1n
.param reps=1
.param Rb=200
Rb controls gate delay (rise and fall edge) as well as gate power consumption.
 
Rb=100 --> 4/5ns gate delay; 35mA gate power
Rb=200 --> 6/8ns gate delay; 20mA gate power
This is the original cascode video amplifier I had for the MAC project
.dc V_IN1 0 5 0.01
.tran 500n
.step temp -25 125 25
;.step param VH 1 2.5 0.1
.param VH=1.5
.param VL=0.0
