andrastantos/the_d_machine/circuit_sims/register_cascode.asc

A11: dflop; Vhigh={VCC}
A13: dflop; Vhigh={VCC}
A14: dflop; Vhigh={VCC}
A15: dflop; Vhigh={VCC}
A16: dflop; Vhigh={VCC}
D1: diode; 1N4148
D2: schottky; BAT54
D3: diode
Q1: npn; 2N3904
Q2: npn; 2N3904
Q3: npn; 2N3904
Q4: pnp; 2N3906
Q5: pnp; 2N3906
Q9: npn; 2N3904
R1: res; 100
R2: res; 75
R3: res; 180
R4: res; 220
R5: res; 10k
R6: res; 50
R7: res; 1m
R8: res; 100
R9: res; 100
R10: res; 700
R11: res; 1m
R12: res; 1m
R13: res; 360
R14: res; 1k
R15: res; 400
R16: res; 50
R17: res; 1Mega
R18: res; 700
R19: res; 600
R20: res; 700
R21: res; 1k
R22: res; 50
R23: res; 180
R24: res; 1m
R25: res; 100
R26: res; 1m
R107: res; 1m
R109: res; 1m
R168: res; 810
R169: res; 1k
R171: res; 15
R174: res; 22
V_BIT5: voltage; PULSE(0 {VCC} 0 {rise} {rise} {1/freq/2-rise} {1/freq} {256*reps}); AC 5
V_IN1: voltage; PULSE({VL} {VH} 0 1n 1n 24n 50n 1000)
V_IN: voltage; PULSE(0 3 0 1n 1n 24n 50n 1000)
VCC: voltage; {VCC}
VCC_1: voltage; 12
VCC_2: voltage; 5
VCC_3: voltage; 12
VCC_12: voltage; 30
VCC_NEG: voltage; 12
Named nets: 0, VCC, A_IN, B_IN, C_IN, _ADD_EN, _AND_EN, _OR_EN, COUT_0, COUT_1, _B_IN, EN, _D, D, _O1, I1, O1, O1b, O1c, O1d
.tran {2*reps/freq}
.ac oct 100 1k 100mega
.param VCC=5
.param freq=1k
.param rise=1n
.param reps=1
.param Rb=200
Rb controls gate delay (rise and fall edge) as well as gate power consumption.
 
Rb=100 --> 4/5ns gate delay; 35mA gate power
Rb=200 --> 6/8ns gate delay; 20mA gate power
This is the original cascode video amplifier I had for the MAC project
.dc V_IN1 0 5 0.01
.tran 250n
.step temp -25 125 25
;.step param VH 1 2.5 0.1
.param VH=0.8
.param VL=0
