andrastantos/the_d_machine/circuit_sims/register_mos.asc

A1: and
A2: and
A3: or
A4: or
A5: or
A6: or
A7: inv
A11: dflop; Vhigh={VCC}
A13: dflop; Vhigh={VCC}
A14: dflop; Vhigh={VCC}
A15: dflop; Vhigh={VCC}
A16: dflop; Vhigh={VCC}
D1: schottky; BAT54
D2: schottky; BAT54
D5: schottky; BAT54
D6: schottky; BAT54
D7: schottky; BAT54
D8: schottky; BAT54
D25: schottky; BAT54
D26: schottky; BAT54
M1: nmos; 2N7002
M2: nmos; 2N7002
M3: nmos; 2N7002
M4: nmos; 2N7002
M5: nmos; 2N7002
Q1: npn; 2N3904
Q2: pnp; 2N3906
Q3: npn; 2N3904
Q6: pnp; 2N3906
Q7: pnp; 2N3906
Q8: npn; 2N3904
Q9: npn; 2N3904
Q10: pnp; 2N3906
Q11: npn; 2N3904
Q12: pnp; 2N3906
Q13: npn; 2N3904
Q14: pnp; 2N3906
Q17: pnp; 2N3906
Q19: pnp; 2N3906
Q20: npn; 2N3904
Q21: pnp; 2N3906
Q23: npn; 2N3904
Q24: pnp; 2N3906
Q25: npn; 2N3904
Q26: pnp; 2N3906
Q27: pnp; 2N3906
Q30: npn; 2N3904
Q31: pnp; 2N3906
R1: res; {Rb}
R2: res; {Rb}
R3: res; 1m
R4: res; 1m
R5: res; 1m
R6: res; 1m
R7: res; {R}
R8: res; 1m
R9: res; 1m
R10: res; 1m
R11: res; 1m
R12: res; 1m
R13: res; 1m
R14: res; 1m
R15: res; 1m
R16: res; 1m
R17: res; 1m
R18: res; 1m
R19: res; {Rb}
R20: res; {Rb}
R21: res; 1m
R22: res; R=R/2
R23: res; 1m
R24: res; 1k
R25: res; 1k
R26: res; 1m
R27: res; 1m
R31: res; 1m
R35: res; 1m
R36: res; 1m
R37: res; 1m
R38: res; 1m
R39: res; R=R/2
R40: res; R=R/2
R41: res; {Rb}
R42: res; {Rb}
R43: res; 1m
R44: res; 1m
R45: res; 1m
R46: res; 1m
R47: res; 1m
R48: res; 1m
R49: res; 1m
R50: res; 1m
R51: res; 1m
R52: res; 1m
R54: res; 1m
R56: res; R=R/2
R57: res; 1m
R58: res; 1m
R59: res; 1k
R61: res; 1k
R85: res; {Rb}
R86: res; {Rb}
R107: res; 1m
R109: res; 1m
R158: res; 1m
R160: res; 1m
R168: res; 1m
R169: res; 1m
R170: res; 1m
R171: res; 1m
R172: res; 1m
R173: res; 1m
R174: res; 1m
R175: res; 1m
V_BIT5: voltage; PULSE(0 {VCC} 0 {rise} {rise} {1/freq/2-rise} {1/freq} {256*reps}); AC 5
VB1: voltage; {VB}
VCC1: voltage; {VCC}
VCC: voltage; {VCC}
Named nets: 0, VCC, NAN2, BIT0, BIT1, A_IN, B_IN, C_IN, _ADD_EN, _AND_EN, _OR_EN, COUT_0, COUT_1, _EN, EN, D0, _D0, _D, D, _B_IN, B1
.tran {32*reps/freq}
.ac oct 100 1k 100mega
.dc V_IN 0 5 0.01
.param VCC=5
.param freq=1k
.param rise=1n
.param reps=1
.param Rb=200
Rb controls gate delay (rise and fall edge) as well as gate power consumption.
 
Rb=100 --> 4/5ns gate delay; 35mA gate power
Rb=200 --> 6/8ns gate delay; 20mA gate power
Parallel load would add 10 more transistors per bit
PAR_LD
PAR_D
SHIFT
.param R=500
.param VB=7
