andrastantos/the_d_machine/circuit_sims/ttl_inverters.asc

D1: schottky; BAT54
D2: schottky; BAT54
D3: schottky; BAT54
D4: schottky; BAT54
D5: schottky; BAT54
D6: schottky; BAT54
D7: schottky; BAT54
D8: schottky; BAT54
D9: diode; 1N914
D10: schottky; BAT54
D11: schottky; BAT54
D12: schottky; BAT54
D13: schottky; BAT54
D14: schottky; BAT54
D15: schottky; BAT54
D16: schottky; BAT54
D17: schottky; BAT54
D18: schottky; BAT54
D19: schottky; BAT54
M1: nmos; 2N7002
M2: pmos; BSS84
M3: nmos; 2N7002
M4: pmos; BSS84
M5: nmos; 2N7002
M6: pmos; BSS84
M7: nmos; 2N7002
M8: pmos; BSS84
Q1: npn; 2N3904
Q2: npn; 2N3904
Q3: pnp; 2N3906
Q4: npn; 2N3904
Q5: npn; 2N3904
Q6: npn; 2N3904
Q7: npn; 2N3904
Q8: npn; 2N3904
Q9: npn; 2N3904
Q10: npn; 2N3904
Q11: npn; 2N3904
Q12: npn; 2N3904
Q13: npn; 2N3904
Q14: npn; 2N3904
Q15: pnp; 2N3906
Q16: pnp; 2N3906
Q17: npn; 2N3904
Q18: npn; 2N3904
Q19: pnp; 2N3906
Q20: npn; 2N3904
Q21: pnp; 2N3906
Q22: npn; 2N3904
Q23: pnp; 2N3906
Q24: npn; 2N3904
Q25: pnp; 2N3906
Q26: npn; 2N3904
Q27: pnp; 2N3906
Q28: npn; 2N3904
Q29: pnp; 2N3906
R1: res; 50
R2: res; 100
R3: res; 2.2k
R4: res; 100
R5: res; 100
R6: res; 100
R7: res; 100
R8: res; 1m
R9: res; 0.01
R10: res; 0.01
R11: res; 1k
R12: res; 1k
R13: res; 470
R14: res; 0.01
R15: res; 100
R16: res; 100k
R17: res; 10
R18: res; 1m
R19: res; 1k
R20: res; 1k
R21: res; 500
R22: res; 0.01
R23: res; 100
R24: res; 1m
R25: res; 3.5k
R26: res; 100
R27: res; 250
R28: res; 1m
R29: res; 0.01
R30: res; 0.01
R31: res; 50
R32: res; 50
R33: res; 50
R34: res; 200
R35: res; 200
R36: res; 1m
R37: res; 1m
R38: res; 200
R39: res; 200
R40: res; 1m
R41: res; 1m
R42: res; 1k
R43: res; 1k
R44: res; 1m
R45: res; 1m
R46: res; 1m
R47: res; 1m
R48: res; 1m
R49: res; 1m
R50: res; 1m
R51: res; 1m
R52: res; 1k
R53: res; 1k
R54: res; 1m
R55: res; 1m
R56: res; 1m
R57: res; 1m
R58: res; 1m
R59: res; 1m
R60: res; 200
R61: res; 200
R62: res; 1m
R63: res; 1m
R64: res; 1k
R65: res; 1k
R66: res; 1m
R67: res; 1m
R68: res; 1m
R69: res; 1m
R70: res; 1m
R71: res; 1m
R72: res; 200
R73: res; 200
R74: res; 1m
R75: res; 1m
R76: res; 1k
R77: res; 1k
R78: res; 1m
R79: res; 1m
R80: res; 1m
R81: res; 1m
R82: res; 1m
R83: res; 1m
R84: res; 100
R85: res; 0.01
R86: res; 0.01
R87: res; 0.01
R88: res; 1m
R89: res; 50
R90: res; 50
R91: res; 0.01
R92: res; 0.01
R93: res; 1m
R94: res; 50
R95: res; 50
R96: res; 0.01
R97: res; 0.01
R98: res; 1m
R99: res; 50
R100: res; 50
V1: voltage; 5
V_IN: voltage; PULSE(0.5 4.5 0 1n 1n 499n 1000n 10); AC 5
Named nets: 0, OUT, IN, VCC, OUT2, OUT3, OUT4, OUT_CMOS1, OUT2a, OUT2b, OUT2c, OUT2d, OUT_CMOS2, OUT_CMOS3, OUT_CMOS4
.tran 10u
.ac oct 100 1k 100mega
Circuits from https://ia802904.us.archive.org/32/items/bitsavers_tidataBookrdTTLSLSDataBook_39061488/1988_TTL_Logic_Standard_TTL_S_LS_Data_Book.pdf
74Sxx-series
74xx series (more or less)
.dc V_IN 0 5 0.01
~4ns rise and fall, but enormous power consumption (mostly transient though)
Base power is around 20mA per gate with an 80ns transient to ~70mA average.
Seems to still beat 74Sxx in every metric possible.
