andrastantos/the_d_machine/circuit_sims/op_amp.asc

C2: cap; 100n
M1: nmos; 2N7002
M2: nmos; 2N7002
M3: nmos; 2N7002
M4: nmos; 2N7002
M5: pmos; BSS84
M6: pmos; BSS84
M7: nmos; 2N7002
M8: nmos; 2N7002
R1: res; {Ri}
R2: res; 10k
R3: res; 10k
R4: res; 100k
R5: res; 1k
R6: res; 1k
V1: voltage; SINE(0 {Vdiff} 500k 0 0 0)
V2: voltage; SINE(0 {Vdiff} 500k 0 0 180)
V3: voltage; {VCC}
V4: voltage; SINE({Vcm} {Vdd} 5k 0 0 180)
Named nets: OUT, 0, IN_P, IN_N
.tran 1000u
.param VCC=10
.param Ri=250
.param Vcm=5
.param Vdiff=10m
;.step param Vcm 1 15 1
.param Vdd=100m
