andrastantos/the_d_machine/circuit_sims/sense_amp3.asc

C1: cap; 1µ
C2: cap; 100n
C3: cap; 1µ
C4: cap; 1µ
M1: nmos; 2N7002
M2: nmos; 2N7002
M3: nmos; 2N7002
M4: nmos; 2N7002
M5: nmos; 2N7002
M6: nmos; 2N7002
M7: pmos; BSS84
M8: pmos; BSS84
M9: pmos; BSS84
M10: pmos; BSS84
M11: pmos; BSS84
M12: pmos; BSS84
M13: pmos; BSS84
M14: nmos; 2N7002
M15: pmos; BSS84
M16: nmos; 2N7002
M17: nmos; 2N7002
M18: nmos; 2N7002
M19: nmos; 2N7002
M20: nmos; 2N7002
M21: nmos; 2N7002
M22: nmos; 2N7002
M23: pmos; BSS84
M24: pmos; BSS84
R1: res; {Ri}
R2: res; {Rl}
R3: res; {Rl}
R4: res; {Rload}
R5: res; {Rl/2}
R6: res; 0.0001
R7: res; {Rload}
R8: res; {Ri}
R9: res; {Rl}
R10: res; {Rl}
R11: res; 0.0001
R12: res; {Rload}
R13: res; {Rload*1.43}
R14: res; {Rl}
R15: res; {Rl}
R16: res; 0.0001
R17: res; {Rload*1.5}
R18: res; {Rload}
R19: res; 1k
R20: res; 1k
R21: res; {Ri}
R22: res; {Rl}
R23: res; {Rl}
R24: res; 0.0001
R25: res; {Rload*1.3}
R26: res; {Rload}
R27: res; 1k
V1: voltage; SINE(0 {Vdiff} {f_sig} 0 0 0)
V2: voltage; SINE(0 {Vdiff} {f_sig} 0 0 180)
V3: voltage; {VCC}
V4: voltage; SINE({Vcm} {Vdd} {f_dd} 0 0 180)
V5: voltage; {VBIAS}
Named nets: OUT, 0, IN_P, IN_N, VCC, OP, ON, BIT
.tran {10/f_sig}
.param VCC=5
.param Ri=1000
.param Vcm=2.5
.param Vdiff=20m
.step param Vdiff 10m 20m 5m
.param Vdd=100m
.param Rl=1500
.param Rload=10k
.param f_sig=50k
.param f_dd=5000
.param VBIAS=5
