andrastantos/the_d_machine/circuit_sims/sense_amp_bjt.asc

C1: cap; 1µ
C2: cap; 1µ
C3: cap; 100p
Q1: npn2; 2N3904
Q2: npn2; 2N3904
Q5: npn2; 2N3904
Q12: npn2; 2N3904
Q13: npn2; 2N3904
Q14: pnp; 2N3906
Q15: pnp; 2N3906
Q16: pnp; 2N3906
Q17: pnp; 2N3906
R1: res; 22k
R2: res; 1k
R3: res; {Rin}
R4: res; 1k
R5: res; 100
R6: res; 1k
R7: res; 1k
R8: res; 1k
R9: res; {Rin}
R10: res; 1k
R12: res; 100
R13: res; 100
R18: res; 150
V1: voltage; SINE(0 {Vdiff} {f_diff} 0 0 0); AC 1
V2: voltage; SINE(0 {Vdiff} {f_diff} 0 0 180); AC 1 180
V3: voltage; {VCC}
V4: voltage; SINE({Vcm} {Vdd} 0 0 0 180)
Named nets: OUT, 0, IN_P, IN_N, VCC, OUT2
.tran {max(10m, 10/f_diff)}
.param VCC=10
.param Ri=250
.param Vcm=5
.param Vdiff=10m
;.step param f_diff 1k 1001k 100k
.param Vdd=10m
.ac dec 100 1u 1000mega
.param Lb=3m
Based on https://sound-au.com/project07.htm
 
A databook with tons of good design info:
http://www.bitsavers.org/components/ti/_dataBooks/1974_TI_Linear_and_Interface_Circuits_Applications.pdf
http://www.bitsavers.org/components/ti/_dataBooks/1977_TI_Memory_Interface_Data_Book.pdf
 
Specifically:
- DC termination on the intput of about 100ohm (external)
- Input bias current of 25-50uA
 
We seem to be meeting these...
 
- Thershold accuracy of about 1-3mV
- (They) depending on resistor ratios to achieve that.
- (They) don't use window-comparators
.param Rin=10k
Common current source needs about 2.5V to operate
Top current mirror needs about 1.2V to operate
As such, 5V operation is not really possible.
.param f_diff=1mega
;step param Rin 1k 10k 1k
;.step param Vcm 3 7 1
.step param Vdiff 0 50m 10m
.tran {10/f_diff}
