andrastantos/the_d_machine/circuit_sims/sense_amp_third_try.asc

C1: cap; 1µ
C2: cap; 1µ
C3: cap; 1µ
C4: cap; 1µ
M1: nmos; 2N7002
M2: nmos; 2N7002
M3: nmos; 2N7002
M4: nmos; 2N7002
M5: pmos; BSS84
M6: pmos; BSS84
M7: pmos; BSS84
M8: pmos; BSS84
M9: pmos; BSS84
M10: pmos; BSS84
M11: pmos; BSS84
M12: pmos; BSS84
M15: nmos; 2N7002
M16: nmos; 2N7002
M17: nmos; 2N7002
M18: nmos; 2N7002
M19: nmos; 2N7002
M20: nmos; 2N7002
M21: pmos; BSS84
M22: pmos; BSS84
M25: nmos; 2N7002
M26: nmos; 2N7002
M27: nmos; 2N7002
M28: nmos; 2N7002
M29: pmos; BSS84
M30: pmos; BSS84
Q1: npn2; 2N3904
Q2: npn2; 2N3904
Q3: npn2; 2N3904
Q4: npn2; 2N3904
Q5: npn2; 2N3904
Q6: npn2; 2N3904
Q7: npn2; 2N3904
Q8: npn2; 2N3904
Q9: npn2; 2N3904
R1: res; {Ri}
R2: res; 10k
R3: res; {Rin}
R4: res; 1k
R5: res; {Ri}
R6: res; 1k
R7: res; {Rin}
R8: res; {Rin}
R9: res; {Rin}
R10: res; 1k
R11: res; 50k
R12: res; 100
R13: res; 100
R14: res; 100
R15: res; {Ri}
R16: res; 1k
R17: res; {Rin}
R19: res; {Rin}
R20: res; 50k
R21: res; 100
R22: res; 10k
R23: res; 1k
R24: res; 1k
R25: res; 100
R26: res; {Ri}
R27: res; 1k
R28: res; {Rin}
R29: res; {Rin}
R30: res; 50k
R31: res; 100
R32: res; 10k
R33: res; 5k
R34: res; 5k
R35: res; 100
R36: res; 100
R37: res; {10*Rin}
R38: res; 100
R39: res; {10*Rin}
V1: voltage; SINE(0 {Vdiff} {f_diff} 0 0 0); AC 1
V2: voltage; SINE(0 {Vdiff} {f_diff} 0 0 180); AC 1 180
V3: voltage; {VCC}
V4: voltage; SINE({Vcm} {Vdd} 0 0 0 180)
V5: voltage; SINE(0 {Vdiff} {f_diff} 0 0 0); AC 1
V6: voltage; SINE(0 {Vdiff} {f_diff} 0 0 180); AC 1 180
V7: voltage; SINE({Vcm} {Vdd} 5k 0 0 180)
V8: voltage; SINE(0 {Vdiff} {f_diff} 0 0 0); AC 1
V9: voltage; SINE(0 {Vdiff} {f_diff} 0 0 180); AC 1 180
V10: voltage; PWL(0 0 5m 10); AC 2
V12: voltage; SINE({Vcm} {Vdd} 0 0 0 180)
Named nets: OUT, 0, IN_P, IN_N, VCC, IN_P1, IN_N1, OUT1, IN_CM, OUT4, IN_P4, IN_N4, OUT_CM
.tran {10/f_diff}
.param VCC=10
.param Ri=250
.param Vcm=6.59
.param Vdiff=10m
.step param f_diff 1k 1001k 100k
.param Vdd=10m
.ac dec 100 1u 1000mega
.param Lb=3m
A databook with tons of good design info:
http://www.bitsavers.org/components/ti/_dataBooks/1974_TI_Linear_and_Interface_Circuits_Applications.pdf
http://www.bitsavers.org/components/ti/_dataBooks/1977_TI_Memory_Interface_Data_Book.pdf
 
Specifically:
- DC termination on the intput of about 100ohm (external)
- Input bias current of 25-50uA
 
We seem to be meeting these...
 
- Thershold accuracy of about 1-3mV
- (They) depending on resistor ratios to achieve that.
- (They) don't use window-comparators
.param Rin=10k
Common current source needs about 2.5V to operate
Top current mirror needs about 1.2V to operate
As such, 5V operation is not really possible.
.param f_diff=1
