andrastantos/the_d_machine/circuit_sims/xor.asc

IN1: voltage; PULSE(0 5 0 10n 10n 90n 200n 10)
IN2: voltage; PULSE(0 5 0 10n 10n 190n 400n 5)
M1: nmos; 2N7002
M2: nmos; 2N7002
M3: nmos; 2N7002
M4: nmos; 2N7002
M5: nmos; 2N7002
M6: nmos; 2N7002
M7: pmos; BSS84
M8: pmos; BSS84
M9: nmos; 2N7002
M10: pmos; BSS84
M11: nmos; 2N7002
M12: nmos; 2N7002
M13: nmos; 2N7002
M14: nmos; 2N7002
M15: nmos; 2N7002
M16: nmos; 2N7002
M17: nmos; 2N7002
M18: nmos; 2N7002
M19: nmos; 2N7002
M20: nmos; 2N7002
M21: pmos; BSS84
M22: pmos; BSS84
M23: nmos; 2N7002
M24: pmos; BSS84
M25: nmos; 2N7002
M26: nmos; 2N7002
M27: pmos; BSS84
M28: pmos; BSS84
M29: nmos; 2N7002
M30: pmos; BSS84
M31: nmos; 2N7002
M32: nmos; 2N7002
M33: nmos; 2N7002
M34: nmos; 2N7002
M35: nmos; 2N7002
M36: nmos; 2N7002
R1: res; 100k
R2: res; 100
R3: res; 100k
R4: res; 100k
R5: res; 100
R6: res; 100
R7: res; 100
R8: res; 100
R9: res; 100
R10: res; 100
VCC1: voltage; 5
VCC: voltage; 7
Named nets: 0, VG, VCC, A, B, O1, O2
.tran 1000n
