andrastantos/the_d_machine/modules/alu/bit_logic/bit_logic.kicad_pcb

## KiCad design modules/alu/bit_logic/bit_logic.kicad_pcb (2026-05-24)

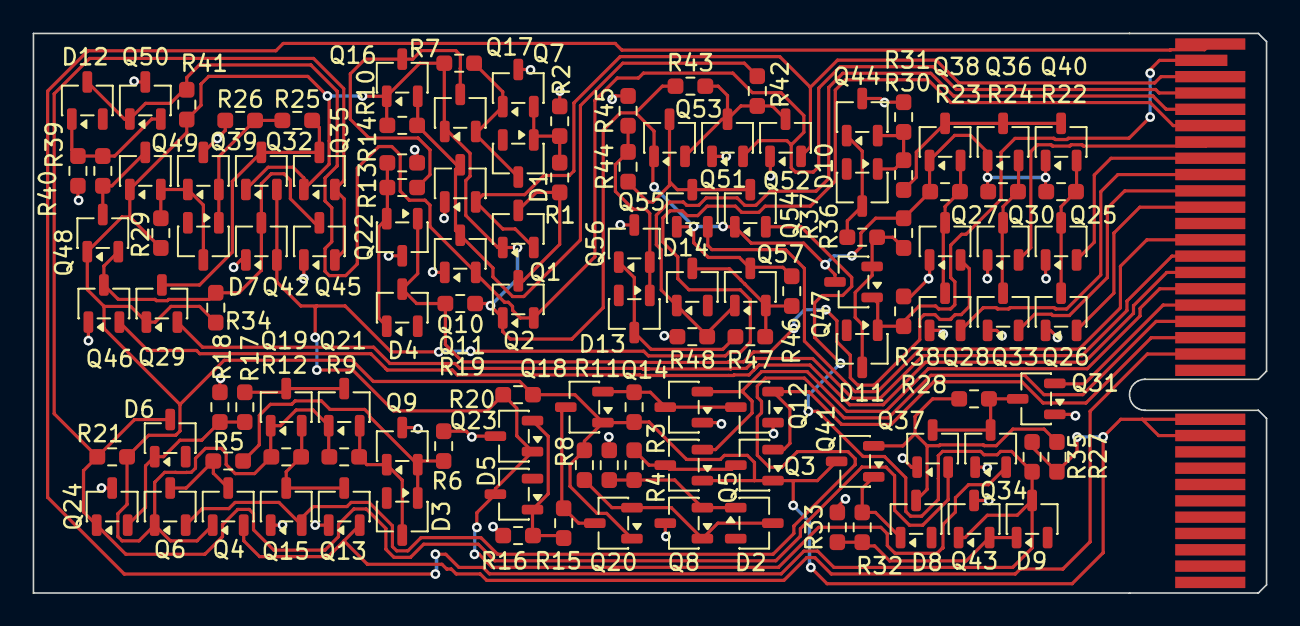
[picture p27: board bit_logic.kicad_pcb from above]

Board: 2 copper layers, 75.6 x 34.3 mm, 120 parts (0 on the bottom side), 63 nets.

Parts:
D1, D2, D3, D4, D5, D6, D7, D8, D9, D10, D11, D12, D13, D14: BAT54LT1G; SOT-23-3
J1: PCIe_4x_edge; BUS_PCIexpress_x4
Q1, Q2, Q3, Q4, Q5, Q6, Q7, Q8, Q9, Q16, Q17, Q18, Q19, Q20, Q21, Q22, Q23, Q24, Q29, Q32, Q35, Q36, Q38, Q39, Q40, Q43, Q44, Q48, Q49, Q50, Q53, Q54, Q55, Q56: 2N3904; SOT-23-3
Q10, Q11, Q12, Q13, Q14, Q15, Q25, Q26, Q27, Q28, Q30, Q31, Q33, Q34, Q37, Q41, Q42, Q45, Q46, Q47, Q51, Q52, Q57: 2N3906; SOT-23-3
R1, R2, R3, R4, R5, R6, R13, R14, R15, R16, R17, R18, R25, R26, R27, R28, R30, R31, R39, R40, R44, R45: 220; R_0603_1608Metric_Pad0.98x0.95mm_HandSolder
R7, R8, R9, R19, R20, R21, R29, R32, R33, R35, R36, R37, R38, R41, R46, R47, R48: 100; R_0603_1608Metric_Pad0.98x0.95mm_HandSolder
R10, R11, R12, R22, R23, R24, R34, R43: 520; R_0603_1608Metric_Pad0.98x0.95mm_HandSolder
R42: 0; R_0603_1608Metric_Pad0.98x0.95mm_HandSolder

Connections:
/IN_A: J1.B14 (Pin_b14), Q3.2 (B), Q12.2 (B)
/IN_ADD_EN: J1.B24 (Pin_b24), Q28.2 (B)
/IN_AND_EN: J1.B19 (Pin_b19), Q29.2 (B)
/IN_A_NEXT: J1.B26 (Pin_b26), Q30.2 (B)
/IN_A_PREV: J1.B25 (Pin_b25), Q25.2 (B)
/IN_B: J1.B13 (Pin_b13), Q4.2 (B), Q13.2 (B)
/IN_C: J1.B30 (Pin_b30), Q1.2 (B), Q10.2 (B), Q52.2 (B)
/IN_C_IS_1: J1.B20 (Pin_b20), Q55.2 (B)
/IN_INV_A: J1.B17 (Pin_b17), Q5.2 (B), Q14.2 (B)
/IN_INV_B: J1.B15 (Pin_b15), Q6.2 (B), Q15.2 (B)
/IN_ROL_EN: J1.B22 (Pin_b22), Q26.2 (B)
/IN_ROR_EN: J1.B23 (Pin_b23), Q33.2 (B)
/OUT_A: D5.3 (K), J1.B27 (Pin_b27), Q23.1 (C), Q32.2 (B), Q34.2 (B), Q42.2 (B), R20.2
/OUT_C: D14.1 (A), J1.B28 (Pin_b28), Q57.1 (C), R48.1
/OUT_G: D9.3 (K), J1.B32 (Pin_b32), Q43.1 (C), Q54.2 (B), R35.2
/OUT_P: D12.3 (K), J1.B29 (Pin_b29), Q2.2 (B), Q11.2 (B), Q50.1 (C), Q51.2 (B), R41.2
/OUT_S: D11.1 (A), J1.B31 (Pin_b31), Q47.1 (C), R38.1
/XX: Q10.3 (E), Q11.3 (E), Q16.2 (B), R10.2, R42.1
/~IN_C_IS_0: J1.B16 (Pin_b16), Q31.2 (B)
/~IN_OR_EN: J1.B18 (Pin_b18), Q46.2 (B)
GND: J1.A10 (Pin_a10), J1.A11 (Pin_a11), J1.A12 (Pin_a12), J1.A13 (Pin_a13), J1.A14 (Pin_a14), J1.A15 (Pin_a15), J1.A16 (Pin_a16), J1.A17 (Pin_a17), J1.A18 (Pin_a18), J1.A19 (Pin_a19), J1.A20 (Pin_a20), J1.A21 (Pin_a21), J1.A22 (Pin_a22), J1.A23 (Pin_a23), J1.A24 (Pin_a24), J1.A25 (Pin_a25), J1.A26 (Pin_a26), J1.A27 (Pin_a27), J1.A28 (Pin_a28), J1.A29 (Pin_a29), J1.A30 (Pin_a30), J1.A31 (Pin_a31), J1.A32 (Pin_a32), Q7.3 (E), Q8.3 (E), Q9.3 (E), Q10.1 (C), Q11.1 (C), Q12.1 (C), Q13.1 (C), Q14.1 (C), Q15.1 (C), Q22.3 (E), Q23.3 (E), Q24.3 (E), Q25.1 (C), Q26.1 (C), Q27.1 (C), Q28.1 (C), Q30.1 (C), Q31.1 (C), Q33.1 (C), Q34.1 (C), Q37.1 (C), Q39.3 (E), Q42.1 (C), Q43.3 (E), Q44.3 (E), Q45.1 (C), Q46.1 (C), Q50.3 (E), Q51.1 (C), Q52.1 (C), Q56.3 (E), R2.2, R4.2, R6.2, R14.2, R16.2, R18.2, R26.2, R31.2, R33.2, R38.2, R40.2, R45.2, R48.2
unnamed: D1.1 (A), Q7.2 (B), R1.2, R2.1
unnamed: D1.3 (K), Q7.1 (C), Q17.2 (B), R7.2
unnamed: D2.1 (A), Q8.2 (B), R3.2, R4.1
unnamed: D2.3 (K), Q8.1 (C), Q20.2 (B), R8.2
unnamed: D3.1 (A), Q9.2 (B), R5.2, R6.1
unnamed: D3.3 (K), Q9.1 (C), Q21.2 (B), R9.2
unnamed: D4.1 (A), Q22.2 (B), R13.2, R14.1
unnamed: D4.3 (K), Q22.1 (C), Q27.2 (B), R19.2
unnamed: D5.1 (A), Q23.2 (B), R15.2, R16.1
unnamed: D6.1 (A), Q24.2 (B), R17.2, R18.1
unnamed: D6.3 (K), Q24.1 (C), Q35.2 (B), Q37.2 (B), Q45.2 (B), R21.2
unnamed: D7.1 (A), Q39.2 (B), R25.2, R26.1
unnamed: D7.3 (K), Q39.1 (C), Q49.2 (B), R29.2
unnamed: D8.1 (A), Q41.1 (C), R32.1
unnamed: D8.3 (K), Q41.2 (B), R27.2, R28.1
unnamed: D9.1 (A), Q43.2 (B), R32.2, R33.1
unnamed: D10.1 (A), Q44.2 (B), R30.2, R31.1
unnamed: D10.3 (K), Q44.1 (C), R37.2
unnamed: D11.3 (K), Q47.2 (B), R36.2, R37.1
unnamed: D12.1 (A), Q50.2 (B), R39.2, R40.1
unnamed: D13.1 (A), Q56.2 (B), R44.2, R45.1
unnamed: D13.3 (K), Q56.1 (C), R47.2
unnamed: D14.3 (K), Q57.2 (B), R46.2, R47.1
unnamed: Q1.3 (E), Q2.3 (E), R1.1
unnamed: Q3.3 (E), Q5.3 (E), R3.1
unnamed: Q4.3 (E), Q6.3 (E), R5.1
unnamed: Q12.3 (E), Q14.3 (E), Q18.2 (B), R11.2
unnamed: Q13.3 (E), Q15.3 (E), Q19.2 (B), R12.2
unnamed: Q16.3 (E), Q17.3 (E), R13.1
unnamed: Q18.3 (E), Q20.3 (E), R15.1
unnamed: Q19.3 (E), Q21.3 (E), R17.1
unnamed: Q25.3 (E), Q26.3 (E), Q40.2 (B), R22.2
unnamed: Q27.3 (E), Q28.3 (E), Q38.2 (B), R23.2
unnamed: Q29.3 (E), Q32.3 (E), Q35.3 (E), R25.1
unnamed: Q30.3 (E), Q33.3 (E), Q36.2 (B), R24.2
unnamed: Q31.3 (E), Q34.3 (E), Q37.3 (E), R28.2
unnamed: Q36.3 (E), Q38.3 (E), Q40.3 (E), R30.1
unnamed: Q42.3 (E), Q45.3 (E), Q46.3 (E), Q48.2 (B), R34.2
unnamed: Q48.3 (E), Q49.3 (E), R39.1
unnamed: Q51.3 (E), Q52.3 (E), Q53.2 (B), R42.2, R43.2
unnamed: Q53.3 (E), Q54.3 (E), Q55.3 (E), R44.1
VCC: J1.B10 (Pin_b10), J1.B11 (Pin_b11), Q1.1 (C), Q2.1 (C), Q3.1 (C), Q4.1 (C), Q5.1 (C), Q6.1 (C), Q16.1 (C), Q17.1 (C), Q18.1 (C), Q19.1 (C), Q20.1 (C), Q21.1 (C), Q29.1 (C), Q32.1 (C), Q35.1 (C), Q36.1 (C), Q38.1 (C), Q40.1 (C), Q41.3 (E), Q47.3 (E), Q48.1 (C), Q49.1 (C), Q53.1 (C), Q54.1 (C), Q55.1 (C), Q57.3 (E), R7.1, R8.1, R9.1, R10.1, R11.1, R12.1, R19.1, R20.1, R21.1, R22.1, R23.1, R24.1, R27.1, R29.1, R34.1, R35.1, R36.1, R41.1, R43.1, R46.1
