andrastantos/the_d_machine/modules/demux_8/demux_8.kicad_pcb

## KiCad design modules/demux_8/demux_8.kicad_pcb (2026-05-24)

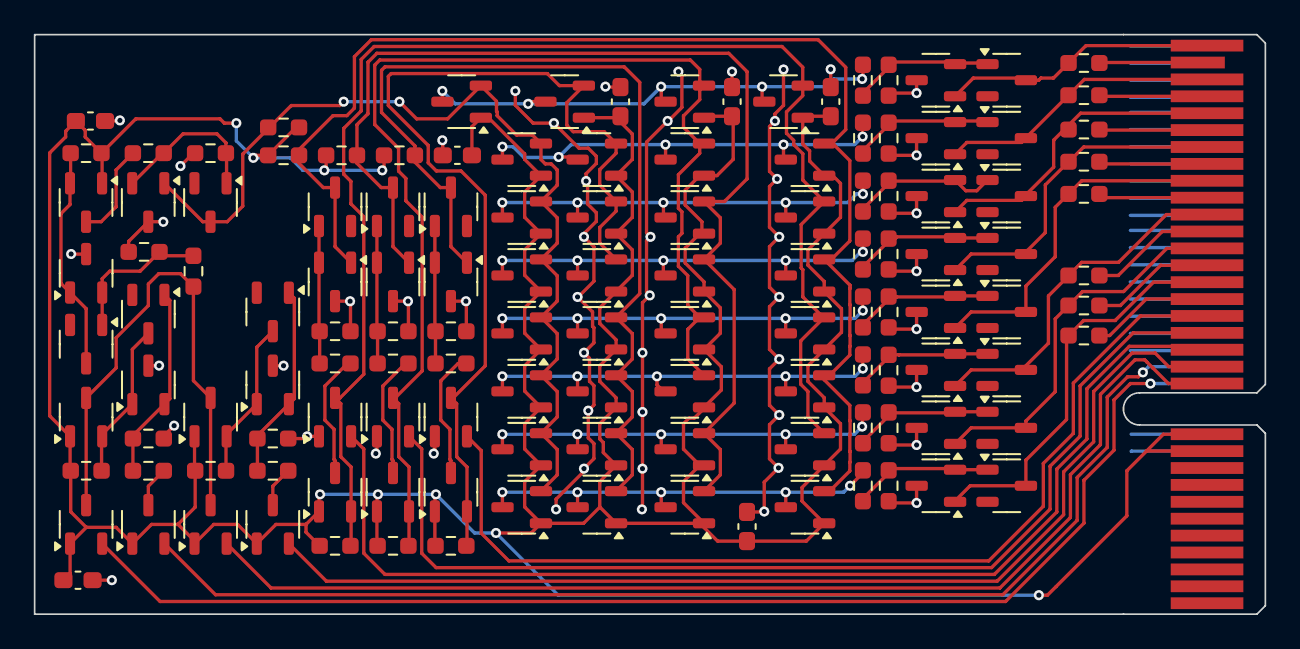
[picture p28: board demux_8.kicad_pcb from above]

Board: 2 copper layers, 72.8 x 34.3 mm, 131 parts (0 on the bottom side), 65 nets.

Parts:
C1, C2, C3, C4, C5, C6, C7: 1u; C_0603_1608Metric_Pad1.08x0.95mm_HandSolder
D1, D2, D3, D4, D5, D6, D7, D8, D9, D10, D11, D12, D13, D14, D15: BAT54LT1G; SOT-23-3
J1: Conn_02x18_Row_Letter_First; BUS_PCIexpress_x4
Q1, Q5, Q6, Q7, Q8, Q9, Q10, Q11, Q12, Q13, Q14, Q15, Q16, Q17, Q18, Q19, Q20, Q21, Q22, Q23, Q24, Q25, Q26, Q27, Q28, Q29, Q30, Q31, Q32, Q33, Q34, Q35, Q36, Q37, Q38, Q39, Q40, Q41, Q42, Q43, Q44, Q45, Q46, Q47, Q48, Q49, Q50, Q51, Q52, Q53, Q54, Q55, Q56, Q57, Q58, Q59, Q60: 2N3904; SOT-23-3
Q2, Q3, Q4: 2N3906; SOT-23-3
R9, R10, R14, R15, R16, R17, R18, R19, R21, R22, R27, R28, R30, R31, R32, R33, R34, R35, R39, R40, R41, R42, R45, R46, R47, R48, R51, R52, R53, R54: 220; R_0603_1608Metric_Pad0.98x0.95mm_HandSolder
R11, R12, R13: 520; R_0603_1608Metric_Pad0.98x0.95mm_HandSolder
R20, R23, R24, R25, R26, R29, R36, R37, R38, R43, R44, R49, R50, R55, R56: 100; R_0603_1608Metric_Pad0.98x0.95mm_HandSolder

Connections:
/A: J1.B14 (Pin_b14), Q2.2 (B)
/B: J1.B15 (Pin_b15), Q3.2 (B)
/C: J1.B16 (Pin_b16), Q4.2 (B)
/EN: D6.3 (K), Q24.1 (C), Q27.2 (B), R29.2
/EN2: J1.B13 (Pin_b13), Q1.2 (B)
/EN3: J1.A13 (Pin_a13), Q9.2 (B)
/O0: D7.3 (K), J1.B18 (Pin_b18), Q28.1 (C), R36.2
/O1: D8.3 (K), J1.B20 (Pin_b20), Q29.1 (C), R37.2
/O2: D10.3 (K), J1.B22 (Pin_b22), Q39.1 (C), R43.2
/O3: D11.3 (K), J1.B24 (Pin_b24), Q40.1 (C), R44.2
/O4: D12.3 (K), J1.B26 (Pin_b26), Q49.1 (C), R49.2
/O5: D13.3 (K), J1.B28 (Pin_b28), Q50.1 (C), R50.2
/O6: D14.3 (K), J1.B30 (Pin_b30), Q59.1 (C), R55.2
/O7: D15.3 (K), J1.B32 (Pin_b32), Q60.1 (C), R56.2
/V_O0: J1.B17 (Pin_b17), R36.1
/V_O1: J1.B19 (Pin_b19), R37.1
/V_O2: J1.B21 (Pin_b21), R43.1
/V_O3: J1.B23 (Pin_b23), R44.1
/V_O4: J1.B25 (Pin_b25), R49.1
/V_O5: J1.B27 (Pin_b27), R50.1
/V_O6: J1.B29 (Pin_b29), R55.1
/V_O7: J1.B31 (Pin_b31), R56.1
/_A: Q2.3 (E), Q5.2 (B), Q18.2 (B), Q32.2 (B), Q42.2 (B), Q52.2 (B), R11.2
/_B: Q3.3 (E), Q6.2 (B), Q33.2 (B), Q34.2 (B), Q53.2 (B), Q54.2 (B), R12.2
/_C: Q4.3 (E), Q7.2 (B), Q45.2 (B), Q46.2 (B), Q55.2 (B), Q56.2 (B), R13.2
/_~A: D2.3 (K), Q10.1 (C), Q17.2 (B), Q31.2 (B), Q41.2 (B), Q51.2 (B), R23.2
/_~B: D3.3 (K), Q11.1 (C), Q20.2 (B), Q21.2 (B), Q43.2 (B), Q44.2 (B), R24.2
/_~C: D4.3 (K), Q12.1 (C), Q22.2 (B), Q23.2 (B), Q35.2 (B), Q36.2 (B), R25.2
/~EN0: J1.B12 (Pin_b12), Q14.2 (B)
/~EN1: J1.A12 (Pin_a12), Q15.2 (B)
/~EN: D9.3 (K), Q25.2 (B), Q26.2 (B), Q30.1 (C), Q37.2 (B), Q38.2 (B), Q47.2 (B), Q48.2 (B), Q57.2 (B), Q58.2 (B), R38.2
GND: C1.2, C2.2, C3.2, C4.2, C5.2, C6.2, C7.2, J1.A10 (Pin_a10), J1.A11 (Pin_a11), J1.A14 (Pin_a14), J1.A15 (Pin_a15), J1.A16 (Pin_a16), J1.A17 (Pin_a17), J1.A18 (Pin_a18), J1.A19 (Pin_a19), J1.A20 (Pin_a20), J1.A21 (Pin_a21), J1.A22 (Pin_a22), J1.A23 (Pin_a23), J1.A24 (Pin_a24), J1.A25 (Pin_a25), J1.A26 (Pin_a26), J1.A27 (Pin_a27), J1.A28 (Pin_a28), J1.A29 (Pin_a29), J1.A30 (Pin_a30), J1.A31 (Pin_a31), J1.A32 (Pin_a32), Q2.1 (C), Q3.1 (C), Q4.1 (C), Q8.3 (E), Q10.3 (E), Q11.3 (E), Q12.3 (E), Q13.3 (E), Q24.3 (E), Q28.3 (E), Q29.3 (E), Q30.3 (E), Q39.3 (E), Q40.3 (E), Q49.3 (E), Q50.3 (E), Q59.3 (E), Q60.3 (E), R10.2, R15.2, R17.2, R19.2, R22.2, R28.2, R31.2, R33.2, R35.2, R40.2, R42.2, R46.2, R48.2, R52.2, R54.2
unnamed: D1.1 (A), Q8.2 (B), R9.2, R10.1
unnamed: D1.3 (K), Q8.1 (C), Q16.2 (B), R20.2
unnamed: D2.1 (A), Q10.2 (B), R14.2, R15.1
unnamed: D3.1 (A), Q11.2 (B), R16.2, R17.1
unnamed: D4.1 (A), Q12.2 (B), R18.2, R19.1
unnamed: D5.1 (A), Q13.2 (B), R21.2, R22.1
unnamed: D5.3 (K), Q13.1 (C), Q19.2 (B), R26.2
unnamed: D6.1 (A), Q24.2 (B), R27.2, R28.1
unnamed: D7.1 (A), Q28.2 (B), R30.2, R31.1
unnamed: D8.1 (A), Q29.2 (B), R32.2, R33.1
unnamed: D9.1 (A), Q30.2 (B), R34.2, R35.1
unnamed: D10.1 (A), Q39.2 (B), R39.2, R40.1
unnamed: D11.1 (A), Q40.2 (B), R41.2, R42.1
unnamed: D12.1 (A), Q49.2 (B), R45.2, R46.1
unnamed: D13.1 (A), Q50.2 (B), R47.2, R48.1
unnamed: D14.1 (A), Q59.2 (B), R51.2, R52.1
unnamed: D15.1 (A), Q60.2 (B), R53.2, R54.1
unnamed: Q1.3 (E), R9.1
unnamed: Q5.3 (E), R14.1
unnamed: Q6.3 (E), R16.1
unnamed: Q7.3 (E), R18.1
unnamed: Q9.3 (E), R21.1
unnamed: Q14.3 (E), Q15.3 (E), Q16.3 (E), Q19.3 (E), R27.1
unnamed: Q17.3 (E), Q20.3 (E), Q22.3 (E), Q25.3 (E), R30.1
unnamed: Q18.3 (E), Q21.3 (E), Q23.3 (E), Q26.3 (E), R32.1
unnamed: Q27.3 (E), R34.1
unnamed: Q31.3 (E), Q33.3 (E), Q35.3 (E), Q37.3 (E), R39.1
unnamed: Q32.3 (E), Q34.3 (E), Q36.3 (E), Q38.3 (E), R41.1
unnamed: Q41.3 (E), Q43.3 (E), Q45.3 (E), Q47.3 (E), R45.1
unnamed: Q42.3 (E), Q44.3 (E), Q46.3 (E), Q48.3 (E), R47.1
unnamed: Q51.3 (E), Q53.3 (E), Q55.3 (E), Q57.3 (E), R51.1
unnamed: Q52.3 (E), Q54.3 (E), Q56.3 (E), Q58.3 (E), R53.1
VCC: C1.1, C2.1, C3.1, C4.1, C5.1, C6.1, C7.1, J1.B10 (Pin_b10), J1.B11 (Pin_b11), Q1.1 (C), Q5.1 (C), Q6.1 (C), Q7.1 (C), Q9.1 (C), Q14.1 (C), Q15.1 (C), Q16.1 (C), Q17.1 (C), Q18.1 (C), Q19.1 (C), Q20.1 (C), Q21.1 (C), Q22.1 (C), Q23.1 (C), Q25.1 (C), Q26.1 (C), Q27.1 (C), Q31.1 (C), Q32.1 (C), Q33.1 (C), Q34.1 (C), Q35.1 (C), Q36.1 (C), Q37.1 (C), Q38.1 (C), Q41.1 (C), Q42.1 (C), Q43.1 (C), Q44.1 (C), Q45.1 (C), Q46.1 (C), Q47.1 (C), Q48.1 (C), Q51.1 (C), Q52.1 (C), Q53.1 (C), Q54.1 (C), Q55.1 (C), Q56.1 (C), Q57.1 (C), Q58.1 (C), R11.1, R12.1, R13.1, R20.1, R23.1, R24.1, R25.1, R26.1, R29.1, R38.1
