andrastantos/the_d_machine/modules/aoi_4x4/aoi_4x4.kicad_pcb

## KiCad design modules/aoi_4x4/aoi_4x4.kicad_pcb (2026-03-07)

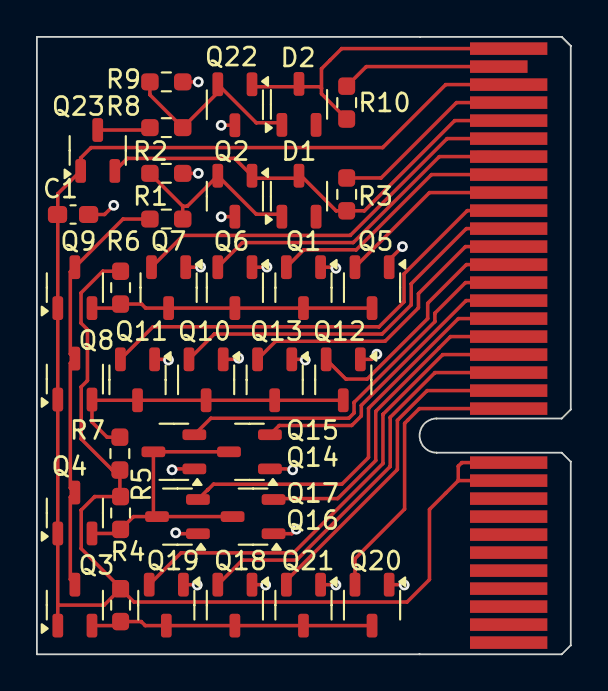
[picture p29: board aoi_4x4.kicad_pcb from above]

Board: 2 copper layers, 29.7 x 34.3 mm, 37 parts (0 on the bottom side), 30 nets.

Parts:
C1: 1u; C_0603_1608Metric_Pad1.08x0.95mm_HandSolder
D1, D2: BAT54LT1G; SOT-23-3
J1: Conn_02x18_Row_Letter_First; BUS_PCIexpress_x4
Q1, Q5, Q6, Q7, Q10, Q11, Q12, Q13, Q14, Q15, Q16, Q17, Q18, Q19, Q20, Q21: 2N3906; SOT-23-3
Q2, Q3, Q4, Q8, Q9, Q22, Q23: 2N3904; SOT-23-3
R1, R2, R8, R9: 220; R_0603_1608Metric_Pad0.98x0.95mm_HandSolder
R3, R10: 100; R_0603_1608Metric_Pad0.98x0.95mm_HandSolder
R4, R5, R6, R7: 520; R_0603_1608Metric_Pad0.98x0.95mm_HandSolder

Connections:
/A: Q1.3 (E), Q5.3 (E), Q6.3 (E), Q7.3 (E), Q9.2 (B), R6.2
/B: Q8.2 (B), Q10.3 (E), Q11.3 (E), Q12.3 (E), Q13.3 (E), R7.2
/C: Q4.2 (B), Q14.3 (E), Q15.3 (E), Q16.3 (E), Q17.3 (E), R5.2
/D: Q3.2 (B), Q18.3 (E), Q19.3 (E), Q20.3 (E), Q21.3 (E), R4.2
/IN_A1: J1.B26 (Pin_b26), Q6.2 (B)
/IN_A2: J1.B27 (Pin_b27), Q7.2 (B)
/IN_A3: J1.B24 (Pin_b24), Q5.2 (B)
/IN_A4: J1.B25 (Pin_b25), Q1.2 (B)
/IN_B1: J1.B22 (Pin_b22), Q10.2 (B)
/IN_B2: J1.B23 (Pin_b23), Q11.2 (B)
/IN_B3: J1.B20 (Pin_b20), Q12.2 (B)
/IN_B4: J1.B21 (Pin_b21), Q13.2 (B)
/IN_C1: J1.B18 (Pin_b18), Q14.2 (B)
/IN_C2: J1.B19 (Pin_b19), Q15.2 (B)
/IN_C3: J1.B16 (Pin_b16), Q16.2 (B)
/IN_C4: J1.B17 (Pin_b17), Q17.2 (B)
/IN_D1: J1.B14 (Pin_b14), Q18.2 (B)
/IN_D2: J1.B15 (Pin_b15), Q19.2 (B)
/IN_D3: J1.B12 (Pin_b12), Q20.2 (B)
/IN_D4: J1.B13 (Pin_b13), Q21.2 (B)
/OUT: D2.3 (K), J1.B32 (Pin_b32), Q22.1 (C), R10.2
/V_OUT: J1.B31 (Pin_b31), R10.1
/V_~OUT: J1.B29 (Pin_b29), R3.1
/X: Q3.3 (E), Q4.3 (E), Q8.3 (E), Q9.3 (E), R1.1
/X2: D1.1 (A), Q2.2 (B), R1.2, R2.1
/Y: Q23.3 (E), R8.1
/Y2: D2.1 (A), Q22.2 (B), R8.2, R9.1
/~OUT: D1.3 (K), J1.B28 (Pin_b28), Q2.1 (C), Q23.2 (B), R3.2
GND: C1.2, J1.A10 (Pin_a10), J1.A11 (Pin_a11), J1.A12 (Pin_a12), J1.A13 (Pin_a13), J1.A14 (Pin_a14), J1.A15 (Pin_a15), J1.A16 (Pin_a16), J1.A17 (Pin_a17), J1.A18 (Pin_a18), J1.A19 (Pin_a19), J1.A20 (Pin_a20), J1.A21 (Pin_a21), J1.A22 (Pin_a22), J1.A23 (Pin_a23), J1.A24 (Pin_a24), J1.A25 (Pin_a25), J1.A26 (Pin_a26), J1.A27 (Pin_a27), J1.A28 (Pin_a28), J1.A29 (Pin_a29), J1.A30 (Pin_a30), J1.A31 (Pin_a31), J1.A32 (Pin_a32), Q1.1 (C), Q2.3 (E), Q5.1 (C), Q6.1 (C), Q7.1 (C), Q10.1 (C), Q11.1 (C), Q12.1 (C), Q13.1 (C), Q14.1 (C), Q15.1 (C), Q16.1 (C), Q17.1 (C), Q18.1 (C), Q19.1 (C), Q20.1 (C), Q21.1 (C), Q22.3 (E), R2.2, R9.2
VCC: C1.1, J1.B10 (Pin_b10), J1.B11 (Pin_b11), J1.B30 (Pin_b30), Q3.1 (C), Q4.1 (C), Q8.1 (C), Q9.1 (C), Q23.1 (C), R4.1, R5.1, R6.1, R7.1
