andrastantos/the_d_machine/modules/diff_probe/diff_probe.kicad_pcb

## KiCad design modules/diff_probe/diff_probe.kicad_pcb (2025-12-10)

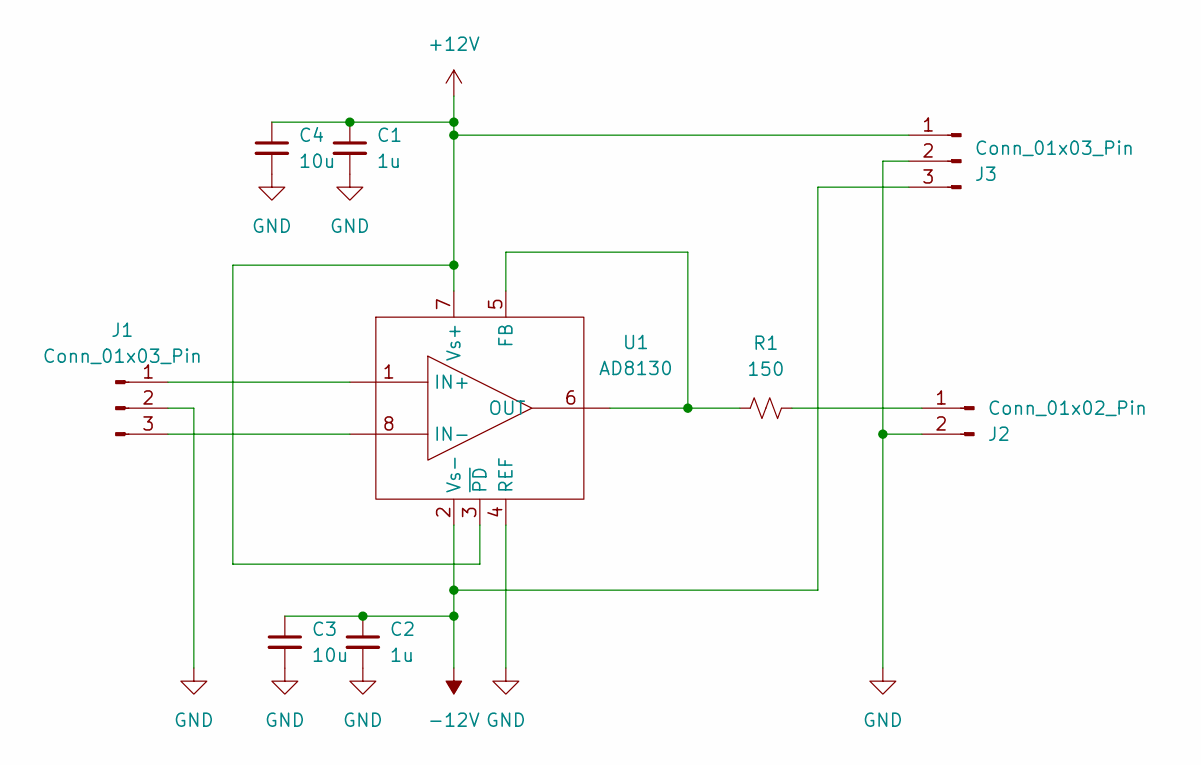
[picture p30: schematic diff_probe.kicad_sch]

Parts:
C1, C2: 1u; C_0603_1608Metric_Pad1.08x0.95mm_HandSolder
C3, C4: 10u; C_0805_2012Metric_Pad1.18x1.45mm_HandSolder
J1, J3: Conn_01x03_Pin; PinHeader_1x03_P2.54mm_Horizontal
J2: Conn_01x02_Pin; SMA_Amphenol_132289_EdgeMount
R1: 150; R_0603_1608Metric_Pad0.98x0.95mm_HandSolder
U1: AD8130; MSOP-8_3x3mm_P0.65mm

Connections:
+12V: C1.1, C4.1, J3.1, U1.3 (~PD), U1.7 (Vs+)
-12V: C2.1, C3.1, J3.3, U1.2 (Vs-)
GND: C1.2, C2.2, C3.2, C4.2, J1.2, J2.2, J3.2, U1.4 (REF)
unnamed: J1.1, U1.1 (IN+)
unnamed: J1.3, U1.8 (IN-)
unnamed: J2.1, R1.2
unnamed: R1.1, U1.5 (FB), U1.6 (OUT)

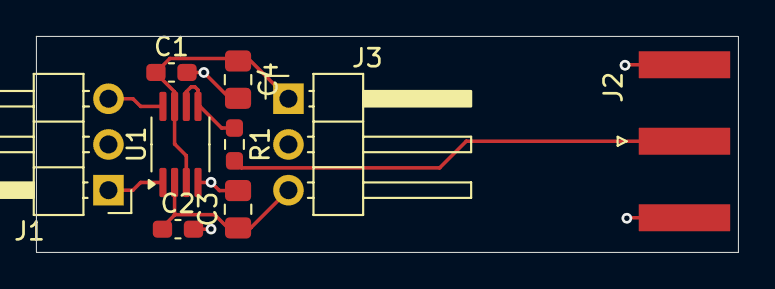
[picture p31: board diff_probe.kicad_pcb from above]

Board: 2 copper layers, 39.0 x 12.0 mm, 9 parts (0 on the bottom side), 7 nets.
