andrastantos/the_d_machine/modules/aoi_2x2/aoi_2x2.kicad_pcb

## KiCad design modules/aoi_2x2/aoi_2x2.kicad_pcb (2025-06-12)

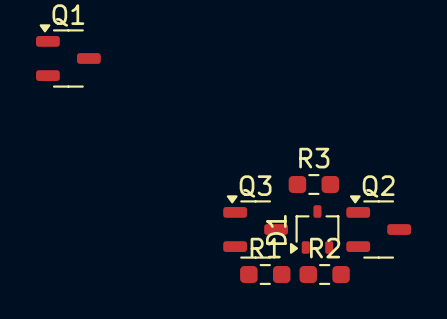
[picture p32: board aoi_2x2.kicad_pcb from above]

Board: 2 copper layers, 7 parts (0 on the bottom side), 5 nets, no tracks yet.

Parts:
D1: BAT54W; SOT-323_SC-70
Q1: 2N3906; SOT-23-3
Q2, Q3: 2N3904; SOT-23-3
R1: 600; R_0603_1608Metric_Pad0.98x0.95mm_HandSolder
R2, R3: 300; R_0603_1608Metric_Pad0.98x0.95mm_HandSolder

Connections:
0: Q2.3 (E), R2.2
/BASE: D1.1 (A), Q2.2 (B), R1.2, R2.1
/OUT: D1.3 (K), Q2.1 (C), R3.2
unnamed: Q3.3 (E), R1.1
VCC: Q3.1 (C), R3.1
