andrastantos/the_d_machine/docs/blog_drawings.kicad_sch

## KiCad design docs/blog_drawings.kicad_sch (2025-07-11)

Schematic: blog_drawings.kicad_sch

Parts:
D1, D2, D3, D4, D5, D6, D7, D8: D
FB1, FB2, FB3, FB4, FB5, FB6, FB7, FB8, FB9, FB10, FB11, FB12, FB13, FB14, FB15, FB16, FB17, FB18, FB19, FB20, FB21, FB22, FB23, FB24, FB25, FB26, FB27, FB28, FB29, FB30, FB31, FB32, FB33, FB34, FB35, FB36, FB37, FB38, FB39, FB40, FB41, FB42, FB43, FB44, FB45, FB46, FB47, FB48, FB49, FB50, FB51, FB52, FB53, FB54, FB55, FB56, FB57, FB58, FB59, FB60, FB61, FB62, FB63, FB64: FerriteBead
I1: HALF_CURRENT
Q1, Q3, Q5, Q7, Q9, Q11, Q13, Q15, Q17, Q19, Q21, Q24, Q25, Q27, Q29, Q31, Q33, Q36, Q38, Q39, Q41: 2N3906; SOT-23-3
Q2, Q4, Q6, Q8, Q10, Q12, Q14, Q16, Q18, Q20, Q22, Q23, Q26, Q28, Q30, Q32, Q34, Q35, Q37, Q40, Q42: 2N3904; SOT-23-3

Connections:
A: Q1.2 (B), Q5.2 (B), Q9.2 (B), Q13.2 (B), Q17.2 (B), Q19.2 (B), Q24.2 (B), Q25.2 (B), Q36.2 (B), Q38.2 (B)
B: Q2.2 (B), Q6.2 (B), Q10.2 (B), Q14.2 (B), Q18.2 (B), Q20.2 (B), Q23.2 (B), Q26.2 (B), Q35.2 (B), Q37.2 (B)
C: Q3.2 (B), Q7.2 (B), Q11.2 (B), Q15.2 (B), Q21.2 (B), Q27.2 (B), Q29.2 (B), Q31.2 (B), Q33.2 (B), Q39.2 (B), Q41.2 (B)
D: Q4.2 (B), Q8.2 (B), Q12.2 (B), Q16.2 (B), Q22.2 (B), Q28.2 (B), Q30.2 (B), Q32.2 (B), Q34.2 (B), Q40.2 (B), Q42.2 (B)
unnamed: D1.1 (K), D2.1 (K), FB57.1
unnamed: D1.2 (A), D4.2 (A), Q38.1 (C)
unnamed: D2.2 (A), D3.2 (A), Q37.1 (C)
unnamed: D3.1 (K), D4.1 (K), FB58.1
unnamed: D5.1 (K), D7.1 (K), FB49.1
unnamed: D5.2 (A), D6.2 (A), Q35.1 (C)
unnamed: D6.1 (K), D8.1 (K), FB50.1
unnamed: D7.2 (A), D8.2 (A), Q36.1 (C)
unnamed: FB1.1, Q1.1 (C), Q2.1 (C)
unnamed: FB1.2, FB2.1
unnamed: FB2.2, FB3.1
unnamed: FB3.2, FB4.1
unnamed: FB4.2, Q3.1 (C), Q4.1 (C)
unnamed: FB5.1, Q5.1 (C), Q6.1 (C)
unnamed: FB5.2, FB6.1
unnamed: FB6.2, FB7.1
unnamed: FB7.2, FB8.1
unnamed: FB8.2, Q7.1 (C), Q8.1 (C)
unnamed: FB9.1, Q9.1 (C), Q10.1 (C)
unnamed: FB9.2, FB10.1
unnamed: FB10.2, FB11.1
unnamed: FB11.2, FB12.1
unnamed: FB12.2, Q11.1 (C), Q12.1 (C)
unnamed: FB13.1, Q13.1 (C), Q14.1 (C)
unnamed: FB13.2, FB14.1
unnamed: FB14.2, FB15.1
unnamed: FB15.2, FB16.1
unnamed: FB16.2, Q15.1 (C), Q16.1 (C)
unnamed: FB17.1, FB19.1, Q17.1 (C), Q18.1 (C)
unnamed: FB17.2, FB21.1
unnamed: FB18.1, FB20.1, Q19.1 (C), Q20.1 (C)
unnamed: FB18.2, FB22.1
unnamed: FB19.2, FB23.1
unnamed: FB20.2, FB24.1
unnamed: FB21.2, FB25.1
unnamed: FB22.2, FB26.1
unnamed: FB23.2, FB27.1
unnamed: FB24.2, FB28.1
unnamed: FB25.2, FB29.1
unnamed: FB26.2, FB30.1
unnamed: FB27.2, FB31.1
unnamed: FB28.2, FB32.1
unnamed: FB29.2, FB30.2, Q27.1 (C), Q28.1 (C)
unnamed: FB31.2, FB32.2, Q21.1 (C), Q22.1 (C)
unnamed: FB33.1, FB35.1, Q23.1 (C), Q24.1 (C)
unnamed: FB33.2, FB37.1
unnamed: FB34.1, FB36.1, Q25.1 (C), Q26.1 (C)
unnamed: FB34.2, FB38.1
unnamed: FB35.2, FB39.1
unnamed: FB36.2, FB40.1
unnamed: FB37.2, FB41.1
unnamed: FB38.2, FB42.1
unnamed: FB39.2, FB43.1
unnamed: FB40.2, FB44.1
unnamed: FB41.2, FB45.1
unnamed: FB42.2, FB46.1
unnamed: FB43.2, FB47.1
unnamed: FB44.2, FB48.1
unnamed: FB45.2, FB48.2, Q31.1 (C), Q32.1 (C)
unnamed: FB46.2, FB47.2, Q33.1 (C), Q34.1 (C)
unnamed: FB49.2, FB51.1
unnamed: FB50.2, FB52.1
unnamed: FB51.2, FB53.1
unnamed: FB52.2, FB54.1
unnamed: FB53.2, FB55.1
unnamed: FB54.2, FB56.1
unnamed: FB55.2, FB63.2, Q39.1 (C), Q40.1 (C)
unnamed: FB56.2, FB64.2, Q41.1 (C), Q42.1 (C)
unnamed: FB57.2, FB59.1
unnamed: FB58.2, FB60.1
unnamed: FB59.2, FB61.1
unnamed: FB60.2, FB62.1
unnamed: FB61.2, FB63.1
unnamed: FB62.2, FB64.1
unnamed: I1.1, Q1.3 (E), Q3.3 (E), Q5.3 (E), Q7.3 (E), Q9.3 (E), Q11.3 (E), Q13.3 (E), Q15.3 (E)
unnamed: I1.2, Q2.3 (E), Q4.3 (E), Q6.3 (E), Q8.3 (E), Q10.3 (E), Q12.3 (E), Q14.3 (E), Q16.3 (E)
unnamed: Q29.1 (C), Q30.1 (C)
