andrastantos/the_d_machine/circuit_sims/and_or_not/and_or_not.kicad_sch

## KiCad design circuit_sims/and_or_not/and_or_not.kicad_sch (2025-06-12)

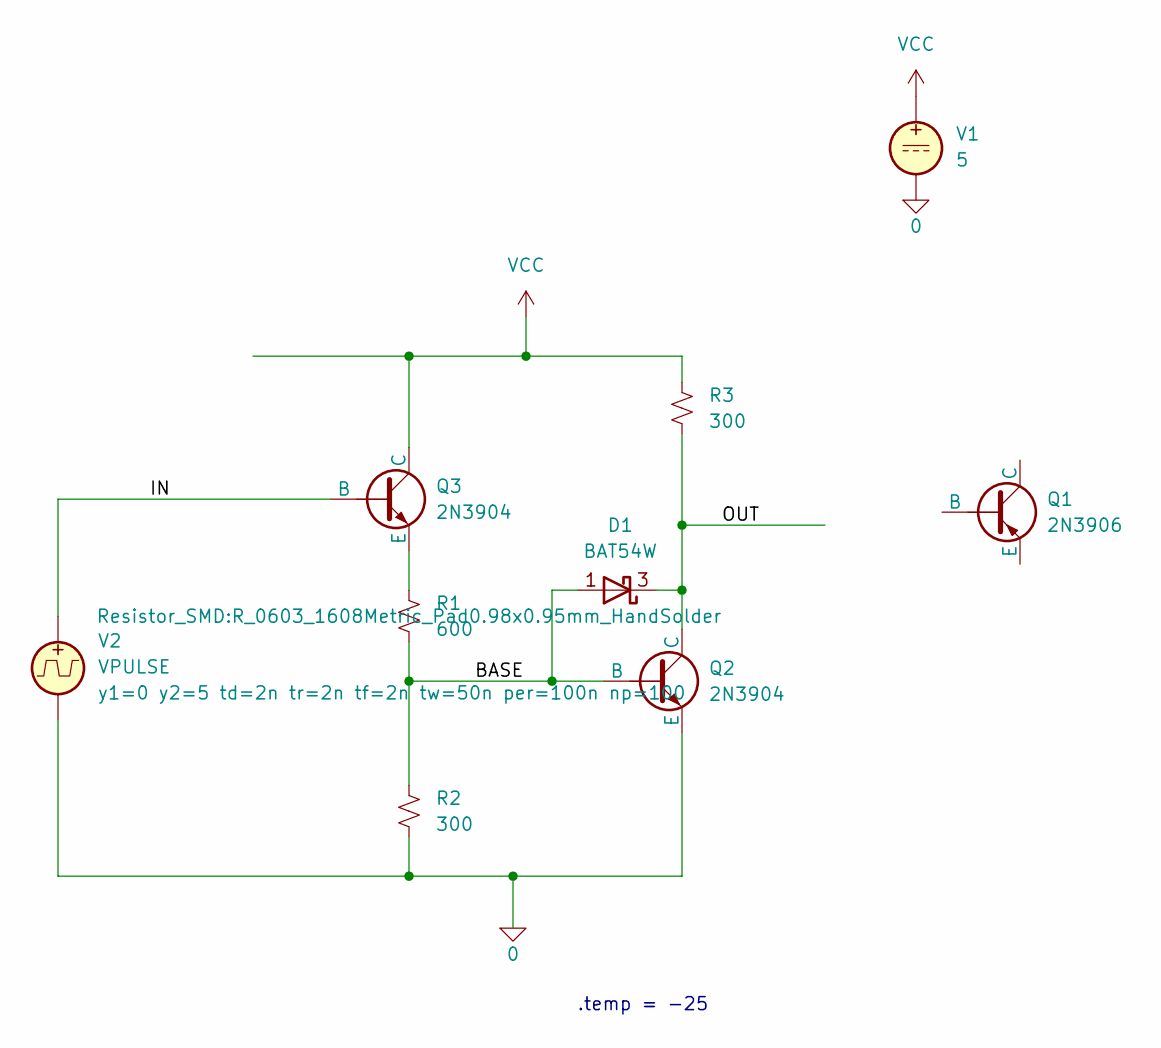
[picture p33: schematic and_or_not.kicad_sch]

Parts:
D1: BAT54W; SOT-323_SC-70
Q1: 2N3906; SOT-23-3
Q2, Q3: 2N3904; SOT-23-3
R1: 600; R_0603_1608Metric_Pad0.98x0.95mm_HandSolder
R2, R3: 300; R_0603_1608Metric_Pad0.98x0.95mm_HandSolder
V1: 5
V2: VPULSE

Connections:
0: Q2.3 (E), R2.2, V1.2, V2.2
BASE: D1.1 (A), Q2.2 (B), R1.2, R2.1
IN: Q3.2 (B), V2.1
unnamed: Q3.3 (E), R1.1
OUT: D1.3 (K), Q2.1 (C), R3.2
VCC: Q3.1 (C), R3.1, V1.1

Notes on the sheet:
.temp = -25
