andrastantos/the_d_machine/(commit log)

2025-05-01 Some tests for more exotic register circuits. No cheese though...
2025-05-02 Still not sure how to make a cheap, low-power and fast SRAM cell.
    No wonder it was difficult back then as well...
2025-05-02 A not-so-low-power inverter variant.
2025-05-05 I'm not getting anywhere with this inverter driver thing.
2025-05-06 Finally, a working, fast, relatively low power and cheap inverter!
    On the other side of the ledger, this needs 3 power supplies.
2025-05-06 Finally, some functional (5V only, unfortunately) logic gates!!
    5V works, but 2.5V would sure be nicer. Lower power, etc. Maybe there's a compromise somewhere in the middle. At any rate, these gates are ~100mA per gate, but have 10ns propagation delay, so maybe there's room for savings.
    The temperature dependency is not great, but acceptable. What's interesting is that the *first* inverter in the chain develops some temperature sensitivity in it's trigger point, but it doesn't seem to get amplified downwards an inverter chain. In other words, it's a self-limiting phenomena, and might not even matter when every driver is of the same kind as opposed to an ideal voltage source in LTSpice.
2025-05-07 Finally figured out temperature compensation.
    This circuit now works well at 5V, though current consumption is high.
    I also need now 4 (!) power supplies, fine-tuned to compensate for Vbe drop.
    This is for now represented by ideal voltage supplies, but of course it
    will need to be something that needs to be implemented by
    real circuits in the end.
    But, at least it allows me to make forward progress.
    NOTE: 2.5V operation is not possible, the emitter follower drops
    are too high.
2025-05-07 I don't think I can get a better bit-cell then this.
    Here we have a 5V, ~20ns, relatively low power bit-cell, where the two inverters and the shift-enable logic total needs only 6 transistors and 2 diodes. I'm not sure I would want to use the same design for generic logic, but I think it's going to be great for the shift-registers.
    For things with parallel load requirements yet another structure (with 2 more transistors to make the input OR gates less hacky) might be needed. Or maybe not. We shall see.
2025-05-08 Low power ALU.
    This thing consumes about 200mA but is relatively slow: 80ns worst-case propagation delay. That doesn't allow 16MHz operation
2025-05-08 2-bit ALU test.
    This has a worst-case propagation delay of 120ns, just about fast enough for 8MHz. On the hairy edge, and if anything else slows things down, it won't make it.
    I think I'll have to find more complex and faster inverters if I want to make this thing tick...
2025-05-08 Added 8-track cassette recorder docs.
    Yes, apparently that was a thing. This is more spendy then the one I've ordered, and I'm a but suspicious of it's signal quality given the extremely narrow tracks, but it actually was a thing.
2025-05-08 Yet another attempt at a fast, complementer inverter.
    This works, but doesn't save any power or provide a speed increase.
2025-05-08 Fine-tuned ALU to work at 20MHz.
    This simply means reducing the input emitter-follower resistance (Rin) to 33ohms. NOTE: this is not the actual resistance, that is a multiple of this.
    At any rate, this results in 20MHz operation (~50ns propagation delay) for a 250mA power.
    I think I'll take this and move on...
2025-05-09 Added trivial inverter chain.
    This uses complementer stages one after the other to achieve very low component count. This might be useful if non-inverting gates are needed.
2025-05-09 New register design.
    This has reasonable speed, ~40mA/bit power and an 8T/2D design. I don't think it can get much more optimal than that in terms of component count.
2025-05-09 Fixed temperature-compensation on inverter.
2025-05-10 Finally a somewhat reasonable clock pulse generator.
    It is sub-optimal in several ways:
    - It needs a dozen or so transistors
    - The lower-end bias-circuit needs to be extremely stiff, right now,
    I need more than 1A current to stabilize it. Interestingly, this is
    not current that's consumed by the inverters, those are fairly
    modest, though the AC coupled one approaches 200mA peak
    On the plus side, this thing generates pulses of ~15 deep and can easily scale from 200kHz to 20MHz and is quite stable over temperature as well.
2025-05-13 So, the only reasonable D-flop is the BJT one with a whopping 20T/4D design per bit.
    Even this, *even this*, only runs up to 10MHz over temperature. At least, it can be made faster by tuning the supply voltage, so if reality is less forgiving, it can be made to work still.
2025-05-19 All tested instructions execute properly now
    Unfortunately I needed to add another mux path: L_BUS_D needs
    to load from both ALU_RESULT (for SWAP) and from L_ALU_RESULT
    (for everything else). This is because L_BUS_D is also an input to most
    ALU operations, so the result has to go through L_ALU_RESULT for a
    cycle, but SWAP can't cycle it's result through there as L_ALU_RESULT
    is a temporary storage for the register content.
    Also MOV-s are somewhat special in selecting their ALU inputs as one or
    the other needs to be zero-ed out based on what the move direction is.
    BTW: MOV could easily be a UNARY op, freeing up a BINARY encoding slot. This is not done though.
2025-05-19 Disambiguated interrupts and reset.
    Sharing the same vector is possible, but ugly. The extra logic, I believe is just one extra transistor, so it's worth the effort.
2025-05-19 Predicates (well, at least EQ and NEQ) work now.
    They're also more efficient then initially thought: they manipulate the PC
    directly instead of killing the next instruction. This also means that
    interrupts are not disabled after a predicate.
2025-05-21 Started a simple assembler.
    This can more or less correctly assemble a single instruction at the moment.
    It can't handle symbols at all.
2025-05-22 Removed 'R1' from indirect base addressing modes.
    We have instead a mem[immediate] addressing, which is way more valuable, not to mention, more symmetrical.
    I think the RTL can be further simplified as we don't have to special-case
    SWAPI anymore.
2025-05-22 A *way* more capable assembler.
    This supports symbols, expressions, sections, pseudo-ops, multi-line
    assembly. It is even capable of generating binary for a trivial single-line
    source.
2025-05-25 I was wrong, the test was wrong. Both the sim and the assembler was right.
2025-05-25 Fixed some assembly and memory dump issues.
2025-05-28 Fixed reversed predicate assembly (D field inversion was wrong).
    Still not cheese though, the execution still fails.
    But at least now I get the right instruction.
2025-05-29 Some CPU fixes and TB improvements:
    - TB now supports the termination port
    - CPU uses MOV instead of SWAP for reset (and properly loads it upon reset)
    - CPU now doesn't write back old data if target is memory: this is the only correct behavior with core memory.
    - MOV writes the correct data back to memory
    - interrupts are properly routed to both data and control planes
2025-06-01 Some further ALU optimization.
    Now the ROL/ROR chains are tied off of already existing inverters.
2025-06-03 Replaced ALU input selects and BUS commands with individual wires.
    At least on the interface level. Sequencer still uses the enums
    internally to figure out what ALU input to drive to what.
2025-06-09 Fixed (but not tested) interrupt handling.
    The fix is to allow ISWAP to increment $PC after
    execution, thus allowing for the skipping of the
    return from interrupt instruction. This makes
    setting the interrupt vector a bit awkward, but
    oh, well.
2025-06-10 Fixed interrupt problems.
2025-06-10 Added another latch to really fix interrupt handling.
    That is: the ISWAP executed during interrupt
    handling should *NOT* increment the
    stored $PC. Since, upon returning from
    the interrupt handler, we want to retry
    the interrupted instruction.
2025-06-12 Started KiCAD based simulation project
    It's not going well, though basic sim works.
    What doesn't work is temperature sweeps.
    Other than that though, it reproduces LTSpice
    results at least on a simple inverter.
    [and_or_not.kicad_pcb, and_or_not.kicad_sch]
2025-06-17 Started KiCAD modules.
    [alu.kicad_pcb, alu.kicad_sch, aoi_2x2.kicad_pcb, aoi_2x2.kicad_sch, xor.kicad_pcb, xor.kicad_sch]
2025-06-17 Much work towards an actual ALU bit-cell.
    [alu.kicad_pcb, alu.kicad_sch]
2025-06-18 Full 16-bit ALU out of transistors.
    The propagation delay seems to be pretty
    good, actually:
    ~220ns at 125C and (thought the sim is still running)
    ~350ns at -25C
    This is well within target for 400ns and
    kind of surprising for a ripple-carry
    implementation. However if it holds,
    this makes things much easier on the
    implementation.
    BTW: ROL/ROR bit-forwarding is hooked
    up incorrectly on the top, so that needs
    to be fixed.
    Also, only ADD is tested at the moment.
    The rest should be easy as mostly can be
    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
    [alu.kicad_sch, alu_4.kicad_sch, bit_logic.kicad_sch]
2025-06-19 Fixed ROL/ROR routing and added flags
    This is not fully tested yet, but at least
    complete in terms of functionality.
    Latency still seems to be less than 350ns.
    [alu.kicad_sch, alu_4.kicad_sch, bit_logic.kicad_sch]
2025-06-19 Small ALU fix.
    [alu.kicad_pcb, alu.kicad_sch, alu_4.kicad_sch, bit_logic.kicad_sch]
2025-06-19 Checked in circuitverse diagrams.
2025-06-24 Moved carry generation into ALU bit-cell.
    [alu_4.kicad_sch, bit_logic.kicad_sch]
2025-06-30 Started sense-amp project
    [sense_amp.kicad_pcb, sense_amp.kicad_sch]
2025-06-30 A workable sense-amp design.
    This can probably be fine-tuned a little to
    get for instance power consumption
    under control, but otherwise, pretty
    good.
    The design is DC-coupled.
    It has about 85ns delay to it, but I don't
    think that matters all that much.
    It's threshold changes about 1mV
    with temperature.
    Rise times are ~17ns, fall times are ~25ns.
    All are very acceptable values.
    Complexity wise it has 16 transistors,
    3 diodes and ~25 resistors.
2025-06-30 A second inverting sense-amp design.
    I don't think it's worth it's salt, but its
    output stage is my normal NPN driver.
2025-07-04 Diode array documentation added
2025-07-07 Created a semi-decent current-source
2025-07-07 Added more mirrors for the X/Y/Inhibit drivers.
    Accuracy dropped to about 5%, unfortunately.
2025-07-07 Made current source a bit better.
    Now it has ~1% (+/-2mA) accuracy over temperature and ~1mA/V supply rejection.
2025-07-07 DEC version of the current source.
2025-07-08 Updates to current sources.
    DEC one now properly reproduce the currents from the original.
    Mine has proper temperature compensation using the thermistor.
2025-07-08 New current sense amp.
2025-07-08 Some more work to characterize the current sources.
2025-07-09 An even better current source.
2025-07-09 Added driver IC datasheet that DEC used.
2025-07-09 First iteration of line switch. Slow, but at least works.
2025-07-09 More work on the switch. Still very, very slow!
2025-07-10 More work on switches
2025-07-11 Some updates to the line drivers.
2025-07-11 Some tidy-up of the line switch schematic.
2025-07-11 Some cleanup of the BJT line driver.
    It still doesn't work BTW.
2025-07-11 Blog drawings project.
    [blog_drawings.kicad_sch]
2025-07-14 Maybe a reasonable inhibit circuit.
2025-07-14 I can't make a current source, apparently.
2025-07-15 More work on the current source.
    This is *hard*!!
2025-07-16 Finally (in version 3) a decent current source.
    This current source seems to be well
    enough tuned to the load switches that
    that I have. It is parameterized to the inhibit
    currents at the moment, I'll have to tune
    a version for the line drivers as well.
    Rise times are workable with no inductive
    loads, have to test what it would look like
    with worst-case loads.
2025-07-16 Fantastic! This circuit isn't even stable with inductive loads.
    I've added some dampers to keep that in check,
    but now it's sluggish, especially in ring-down.
    So, hopefully, I won't have a really inductive load.
    Actually all indication is that I won't.
2025-07-18 Checking in current progress.
2025-07-23 Much more updated current source.
    This one is back to four outputs and an
    extra buffer stage to make the crosstalk
    nonexistence.
    The penalty for it is a few extra
    transistors and more importantly a
    diminished temperature independence.
    Still not awful and after thermistor
    compensation, pretty good, actually.
    Also, the load regulation could be better,
    something to look into with the actual
    load.
2025-08-15 Started work on line-switch.
2025-08-20 Checking in a bunch of circuit changes.
2025-08-20 Some more analysis on fast inverters.
    There is maybe some way of balancing power
    consumption and speed. But it's not
    pretty.
2025-08-20 Added comment (and SPICE model) about new FET selection.
2025-08-20 I think I have a reasonable high-voltage FET driver here.
    This still needs a good level-shifter in front of it, that needs to be
    invented.
2025-08-22 New line-switch driver idea.
2025-08-25 Lots of fuffing about with current sources.
    Also, found an acceptable dual-FET, so updated to that SPICE model.
2025-08-25 Some progress towards an inhibit switch.
2025-08-25 Realized why current source was so slow.
    This was the extremely slow TIP42C.
    Replaced it with a more modern power BJT
    and things are significantly better now.
    Of course this change requires a lot of
    fine-tuning, some of which still hasn't
    been done.
2025-08-25 Added another potential power PNP spice model.
2025-08-26 Yet another driver trial.
    This one is pretty close to a TTL output stage
    (which BTW finally works). However, it still
    doesn't work well-enough, I think it has to do
    with the pull-up strength of the stage.
2025-08-27 Better driver, still no cheese.
    So, the high-side needs a complementer
    driver (which is a PITA), but even with that,
    the "off-hump" didn't disappear. At least
    the shoot-through did though...
2025-08-28 I finally understand what the problem with the bride is.
    Essentially, the top-side inactive FET Cgs needs to be charged up because the
    bridge is powered by a current source
    that varies the top voltage whilst the gate
    is held at a constant voltage.
    How to fix this though is a different
    animal all together.
2025-08-28 Finally some real progress!
    The emitter-follower idea to generate the
    high-side drive voltage is actually a great
    one. Maybe not the final setup, but
    certainly a great improvement.
2025-08-28 Added a second emitter-follower stage.
    This is there to reduce drop between CS0
    and gate-drive output.
2025-08-29 I think - apart from the input delays - load driver is done.
    I need to find a way to skinny up the low-side
    drive by about 50ns on both sides. Other
    that that though, it seems things are
    working relatively well. Fingers crossed...
2025-08-29 Maybe a complete switch design?
2025-09-16 Escapades in understanding FET turn-on and off.
2025-09-22 Minimal test-bed for switch tests.
2025-09-23 Test bed for current switches
2025-09-24 More ideas around current switching.
    The complicated non-saturation control
    seems to be working, albeit it needs
    4 transistors, not counting the
    level shifters.
    The idea of turning the current source
    on/off also seem to be working, but this
    one needs higher than 20V control.
2025-09-26 Gave up on controlling the current source.
    Instead, fine-tuned the load-switch idea. This is still problematic
    in that the compensation capacitor depends on the load quite
    a bit. But maybe it's good enough?
    Rise time is now on the order of 150ns. Not stellar, but maybe acceptable?
2025-10-02 Dunno, some changes, it seems adding a 2-ohm resistor for some reason.
2025-10-03 Finally written up article about inhibit switches.
2025-10-24 So far the best I could do with an H-bridge.
    At this point, it seems I can just as well as do the low-side
    the same way as the high-side: diodes and BJTs are
    of roughly the same cost...
2025-10-27 This is the craziest H-bridge I've ever seen.
    This uses 4 PNP transistors and some complicated
    drive logic to achieve non-saturated, fast switching.
    Yet, this is the simplest I could come up with, and it
    actually seems to fit the bill with about 120ns
    rising edges.
2025-10-29 Added fancy level-shifters to the H-bridge.
    This is getting ugly fast: 11-12 transistors PER power transistor.
    That's more than 2000 transistors just for the X-Y driver circuit.
    With inhibit drivers, we're around 2500 transistors.
2025-10-30 I managed to optimize out 4 transistors per drive path.
    Also fixed shoot-through. So now, each X-Y driver needs
    16 transistors, needing only 768 total. (BTW, I think
    previously I estimated double the transistor count
    than actually needed, so it went from 1100 to 768).
    I also gotten rid of the shoot-through that was due
    to the not-so-clean high level on the high voltage
    drive of the high-side.
    Now the price I pay is rather sluggish rise-time, we
    barely reach the target current by the end of the 200ns
    on-time.
2025-10-30 Actually shoot-through is still not eliminated, but step-response is beautiful now.
    Introduced base-resistors on the high-side. This limited
    shoot-through somewhat, but it's still present. More
    importantly though, the load-current now is very nice.
    So as long as the shoot-through is not damaging
    anything (and it shouldn't), I don't think I cared all
    that much.
2025-11-03 Created complementer high-side drive. Now the shoot-through is gone.
    This is even crazier than the previous design:
    now all power transistor are of the wrong kind.
    In other words, all power BJTs are in an emitter
    follower configuration. This also has much
    worse step-response, probably because the
    missing shoot-through doesn't "pre-charge"
    the current source.
2025-11-05 Some work towards a temperature compensated delay line.
2025-11-07 Created some drawings for the timing circuit.
2025-11-07 Added clock generator circuit
2025-11-07 I now have a couple of oscillating oscillators.
    I'm not quite sure if I wanted to use them:
    it seems a major PITA to get them logic level
    compliant.
2025-11-10 Started working on optical drivers/sensors.
2025-11-14 Some small sense amp circuit changes (in the stimulus).
2025-11-21 QSpice test circuit.
2025-11-25 Spent a lot of time with common-base input stages.
    Not sure I got to where I want to be, but there is *something*. About 150uV output swing with
    a significantly larger temperature-dependent offset (even though the circuit is now pretty well
    temperature compensated). It's also rather complicated at 5 transistors. I'm wondering though
    if the emitter followers are needed, or if the common-base input can drive the diff-amp directly...
2025-11-25 Some documentation on magnetic disk storage
2025-11-25 More work towards the ROM sense amp.
    It's mostly a negative result: common-base input stage doesn't help.
    However the input current coupling probably isn't a problem: the transient
    comes after the important sample point and dies out on time to meet timing.
2025-11-26 Some work on standardizing component values and reducing power consumption.
    The detector still works, but the detection is slow, so the threshold is pulse-width
    dependent.
2025-12-02 Ton of work towards actually understanding the sense amp and reducing power.
    More work needs to be done. I think what I want is a sense output closer to zero bias, but maybe I'm wrong about that.
2025-12-03 Some musings about how diff-amps work. Or should work.
    Right now, the diff amp is nice, the sense-amp has all sorts of non-idealities, plus it's more complex and less performant then the original one ripped from Motorola.
2025-12-04 More circuits for diff-amp design.
2025-12-05 Checking in outstanding files, started aoi_4x4 design.
    [aoi_4x4.kicad_pcb, aoi_4x4.kicad_sch]
2025-12-10 Checking in diff probe and AOI module work.
    [diff_probe.kicad_pcb, diff_probe.kicad_sch]
2025-12-17 A bit of a misnomer as I think I'll be able to use a common-emitter design.
    I have to temperature compensate the hell out of it though which is
    not simple. I'm still trying to find the best way to do it.
2025-12-17 Getting close to the end of the ROM sense-amp circuit design.
2025-12-18 Added power supply filters to increase PSRR.
2025-12-18 Some modifications to tape sense amp, making it a better (parametrized) design.
    Also, with some tweaks to the input termination and offsets, we don't need the
    AC coupled class-A stage at the output.
2025-12-22 Started switcher design.
2025-12-22 Started working on protection circuit for tape head. Doesn't work. Yet.
2025-12-22 More work on power reduction and speed improvements. Now switcher is at 100kHz and the oscillator is at ~20mA.
2025-12-26 Some work towards a functional PWM-modulated buck.
2025-12-26 Some power-supply related changes and doodles.
2025-12-29 More work on switcher. Over-current protection is reasonable, but soft-start isn't (yet). Over-voltage protection is there but not functional (well) and there's no under-voltage lock-out.
2025-12-30 Yet another buck trial.
2026-01-02 More rather unsuccessul experiements with buck converters.
2026-01-02 More work on switching regulator.
    Maybe a hysteretic thing isn't that crazy? But I need a good switch driver, independent of topology.
2026-01-05 This (rather expensive) switch driver seems to work nicely.
    In fact, it's good enough with a PFET up to a few houndred kHz, probably.
2026-01-05 Copied driver into regulator. It is now much happier.
    There is quite a bit of ringing during turn-on with light loads,
    but output voltage is stable, switching frequency is high
    (170kHz) and FET power consumption is low.
2026-01-05 Fine-tuned inductor values. Results are:
    - Overshoot even at 7A current
    - 1.3W switching loss on power FET
    - 3.36V output voltage
    - 4mV output ripple
    - 33uH inductors, which are relatively small (14x12mm)
    Still need to do decent error amplifier or at least make current
    config less temperature sensitive.
2026-01-05 More probing and some stress-testing.
    The output depends quite a lot on the input supply, that is
    about 10% variation over 5-25V input range. Temperature
    as it stands at the moment has similar impact. The overshoot
    is still there and I'm not sure about load or supply regulation.
2026-01-05 The "4" variant is finally a decent regulator.
    Rather complex at 13 transistors, but at least it's stable in temperature, won't overshoot,
    can deliver 5A (even 7A if pushed) of current, doesn't need giant inductors, has about 80%
    efficiency.
2026-01-06 Added over-current protection at the cost of extra 3 transistors.
2026-01-06 Added soft-start circuit. I think the buck converter is done now.
2026-01-08 Reformed circuits, more comments and test for a second transformer variant.
2026-01-09 Some small ALU changes (need review!)
    [bit_logic.kicad_sch]
2026-01-13 Forward regulator (at least BJT-CMOS one) is more or less done.
2026-01-14 Started working on linear regulators.
    These are relatively easy to get going, except that they are not LDO type. That's not a problem, to lower
    the drop, I need a boosted voltage, which I can get for both the positive and negative rails, but
    that means I need to integrate the forward converter with the linear regulators.
2026-01-16 Linear regulators more or less done. Some experiments with coupling the boost voltage regulator output.
2026-01-16 Some fine-tuning and addition of over-current protection.
2026-01-20 Started working on power-good signal.
    Hower the regulator now is not stable accross temp.
    Probably a problem with the schmiddt trigger biasing.
2026-01-24 Tuned some values to make the regulator more temperature-tolerant.
2026-01-26 Working oscillator and clock gen, plus small changes in 3.3V supply (what changed??)
2026-01-26 Started doodling power-good detectors.
    There's a diff-amp and a comparator-based design here, roughly equal performance and complexity.
2026-01-27 Some cosmetic fixes to power-good detectors.
2026-01-30 Started working towards real modules. Modules with PCIe connectors.
    [aoi_4x4.kicad_pcb, aoi_4x4.kicad_sch]
2026-03-04 Started PCIe connector-based module design.
    [aoi_4x4.kicad_pcb, aoi_4x4.kicad_sch]
2026-03-04 More work on AOI PCB. Fully routed, but not clean yet.
    Also needs bypass caps.
    [aoi_4x4.kicad_pcb, aoi_4x4.kicad_sch]
2026-03-07 More flushed out library and it's use. PCB is also much nicer.
    [aoi_4x4.kicad_pcb, aoi_4x4.kicad_sch]
2026-03-09 Started 8-way decoder. It's ... large.
    [demux_8.kicad_pcb, demux_8.kicad_sch]
2026-03-16 Some work towards a decoder component placement.
    [demux_8.kicad_pcb]
2026-04-25 Some fixes to the ALU schematics
    [alu.kicad_pcb, alu.kicad_sch, alu_4.kicad_sch, bit_logic.kicad_sch]
2026-04-26 Pretty good progress on bit-logic for ALU.
    [bit_logic.kicad_pcb, bit_logic.kicad_sch]
2026-05-24 More or less finalized PCB for 8-way demux.
    [demux_8.kicad_pcb, demux_8.kicad_sch]
2026-05-24 Some more work on power routing.
    [bit_logic.kicad_pcb]
2026-05-24 PCB is more or less done. It's DRC clean but needs bypass caps and some power optimizations.
    [bit_logic.kicad_pcb, bit_logic.kicad_sch]
2026-06-01 MMU and interrupt seems to be working.
    There are a lot of changes here. I needed to:
    - Interrupt enable/disable logic was rather busted, especially with MMU in the
    picture. Interrupts were enabled in the wrong phase and disabled in the wrong
    phase as well
    - External interrupts need to be at least somewhat resynced to the internal clock
    to ensure they don't cause the interrupt detect logic go hay-wire.
    - We actually need to use the 'previous' interrupt state to detect interrupts as
    that's the one that changes state at the very end of instruction execution
    - During interrupt handling, phase0 and phase1 should not generate memory
    cycles
    - The MMU got enabled and triggered AVs in all s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
2026-06-02 Added (totally untested) interrupt controller.
    Right now the corresponding interrupt sticky-bit from the MMU is NOT removed.
    I'll have to convince myself that it's safe to remove as the *OUTPUT* of the
    sticky bit is used within the MMU. So maybe the corresponding sticky-bit would
    need to be routed from the interrupt controller back? That sounds like a mess...
2026-08-04 Added MF11-L schematics (core is on page 134)
2026-10-20 Fix predicate encoding when the memory operand comes first.
    Swapping the operands of an ordered compare mirrors the condition
    (a < b <=> b > a); the assembler inverted it instead (a < b -> a >= b).
    Signed predicates now map to the mirrored opcode. Unsigned ones can't
    be mirrored (there's no unsigned <= or >), so they are now rejected.
2026-10-21 MMU and interrupt controller should be behind AV checks.
2026-10-22 Fix MMU access violation handling; add user-mode AV tests.
    - Limit check: use the carry of an 8-bit sum, and raise an AV when the
    logical page is above the limit (limit inclusive).
    - Only check and translate real bus addresses (instruction fetch and
    operand read). The ALU output was checked in every phase, so e.g.
    "mov $r0, -1" faulted in user mode.
    - An AV cancels the whole faulting instruction, whatever its operand
    type: bus cycles, register update and predicate skip.
    - A faulting fetch loads the interrupt instruction instead of the
    undriven bus; the handler then sees the PC after the faulting address.
    - The limit check is done in the preceding phase and latched, so reads
    that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
2026-10-22 Fix MMU mode switching at user-mode entry and interrupt entry.
    - The first instruction fetch after an SWAPI into user mode was neither
    translated nor checked: INTDIS only switches in phase 1 of the next
    instruction. The MMU now uses the upcoming INTDIS (fetch_intdis) for
    the fetch check and translation.
    - Interrupt entry re-enabled interrupts: handling_interrupt sets INTDIS
    in phase 2, then the interrupt instruction (an SWAPI) flipped it back
    in phase 5, starting the handler in user mode with interrupts
    enabled. The flip is now suppressed for the interrupt cycle
    (l_int_cycle is held for the whole instruction).
    - Write-backs of reads blocked by an access violation are blocked th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
2026-10-22 Make interrupt controller reads safe under read/write-back.
    Every memory operand is read and then written back. Reading the
    interrupt controller returned only the pending bits, so the write-back
    cleared the enable mask. Reads now return enable[15:8] | pending[7:0]:
    the write-back keeps the mask and acknowledges exactly the interrupts
    that were read.
    tb_cpu.py: the termination port moves to 0xffe0 (the ISA simulator's
    EXIT port) with the same semantics: reads return 0x8000, writes with bit
    15 set are ignored. Memory no longer responds in the CPU's internal I/O
    page (0xfff8..0xffff); reads there see a pulled-up bus.
    av.s: use the new termination port; check that the interrupt controller
    keep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
2026-10-23 Add memory pseudo-registers $mr0..$mr31 to asm.py and disasm.py.
    $mr0 to $mr31 are aliases of [0] to [31]. The assembler accepts them
    wherever a memory operand is allowed; the disassembler prints [0]..[31]
    as pseudo-registers. Same syntax as the binutils assembler.
2026-10-27 Document the C ABI in isa.md.
    Adds the rules the GCC port follows: which arguments go in R0, how
    structs are returned, the $mr0..$mr31 memory registers and their
    caller/callee saved split (and -muser-mode), the C data type sizes,
    word-aligned char objects, LSB byte pointers and %bptr, and the rule
    that interrupt handlers must leave [$sp] and the scratch word [$sp-1]
    of the interrupted code alone.
2026-10-28 isa.md: $mr6 is the C frame pointer
    Functions that need a frame pointer keep it in $mr6, which holds a
    word address like SP; elsewhere it is callee saved. The caller saved
    memory registers are $mr7-$mr18.
2026-11-05 isa.md: Named arguments of variadic functions
    State that the named arguments of a variadic function are passed as
    in any other call, so printf's format string is in R0, as GCC now
    does.
